bigtreetech/BIGTREETECH-S42B-V1.0/(threads)

Thread 1 (2020-01-07):

Manual file

schpuntik, 2020-01-07:
Manual file is brocken. Please  upload again

yangwenxiong, 2020-01-08:
> Manual file is brocken. Please upload again

Have been updated

yangwenxiong, 2020-01-08:
[https://github.com/bigtreetech/BIGTREETECH-S42B-V1.0/issues/1#issue-546557873](url)

yangwenxiong, 2020-01-08:
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

yangwenxiong, 2020-01-08:
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

yangwenxiong, 2020-01-08:
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

yangwenxiong, 2020-01-08:
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

Closed 2020-03-23.

Thread 3 (2020-03-15):

Motor Spin after M17 command

ehtnevets, 2020-03-15:
After auto-disable timeout, sending M17 (enable) will cause motor to jump to almost the end of travel of an axis. Is there work around?

Thanks

sae74, 2020-04-30:
I have exactly the same problem in rotation after shutdown

ehtnevets, 2020-05-01:
I'm ordering the MKS closed loop board. I'll let you know if MKS brand exhibits the same problem, in 2-3 weeks. Shipment has been really slow from China to U.S.

sae74, 2020-05-01:
I will wait for feedback from you.
Thank!

ehtnevets, 2020-05-21:
I ordered MKS from AliExpress. It hasn't arrived after more 2 months. I disputed this with AE but seller (MKS) keeps extending protection program. AE only allows dispute if the protection program is expiring in a day. The computer generated response from AE keeps saying my dispute is invalid. So, I call my bank to charge back.  I gave up MKS.

Anyway, I gave up with this closed loop stuff as it doesn't have the advanced smoothing feature like Trinamic drivers. It's loud and vibrates my print bed. Lowering the current seems to help but sacrifices max speed. Even after I found all the disable motor-off feature in Marlin and Klipper firmwares to avoid the jump from re-enabling, I think this closed loop solution gives worse bottom line result.

To top it off, the magnet always gets loose. I used all different type of glues, cement, superglue, epoxy, etc. They don't help. Especially, the ones I used in the extruders with linear/pressure advance feature (linear advance causes the motor to spin back and forth very fast and for short distances, aka violent jerking).

So, in the end I realized that closed loop motor this cheap ain't cut it. If you want to go closed loop, get one with $100s/axis. Plus, if your non-closed loop stepper is skipping steps, there is other fundamental issue that needs to be addressed. But for sure not going with closed loop.

Back to Trinamic.

sae74, 2020-05-21:
Thank. But I need a device not for a 3D printer.
It’s very important for me to keep track of the number of steps.

ehtnevets, 2020-05-21:
Perhaps, you should use the more expensive version (about 3x more). They use more expensive components even down to the passive ones like bigger capacitor, tighter tolerance.

When it comes to closed loop control, I re-learned (I started a company that designed and manufactured robots for semiconductor industry) that you get what you pay for.

You can always keep track your steps with the software. The software is the one doing the stepping anyway.

ehtnevets, 2020-05-21:
And if your usage include moving the motor with a lot of high accel and decel, the magnet could be another problem.

sae74, 2020-05-22:
I need to control the steps for a water pump system. Need high accuracy +/- 0.005 ml liquid

ehtnevets, 2020-06-15:
I finally got my MKS boards but decided that the motion smoothness is more important when it comes 3D printing and decided not to bother with it.

I have 1 board set with OLED and 4 just board set that I want to sell. If you are in US, I can sell them to you at cost + shipping. Cheaper than you find on eBay.

sae74, 2020-06-16:
Thank.
But I am in a different country.
If you know what Chernobyl is, or you watched the Chernobyl series, then this is about my country, Ukraine.

ehtnevets, 2020-06-16:
Ukraine. Remind me of my a friend who told a story about Chernobyl cleanup when he was in the Army there.

Quas7, 2020-09-10:
I experience the same issue for my FDM extruder after powerdown and enabling again. It always stripped my filament as it retracted with max speed x100m of filament. ;)

Simple solution was to disconnect the enable-pin from the cable-connector and bridge the enable signal on the stepper PCB to GND (active low) with a dupont wire.
This way, the stepper driver stays of course always active but there is also no "reset to 0" at the start of the print.

Quas7, 2020-09-10:
I flashed today the latest firmware out of this repo to adjust the PID values a bit and now the enabling/disabling of the stepper driver does not result in any erratic spinning anymore.

I guess, the issue got solved by the devs before uploading the code here.

sae74, 2020-09-11:
How did you upload the firmware?
Where did you connect the programmer?

Quas7, 2020-09-11:
Took the pinout from here: https://github.com/bigtreetech/BIGTREETECH-S42B-V1.0/blob/master/Item-Pinmap.PDF
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
Read carefully the pins as there are two rows of pins (OLED and aux. connector) and one column of pin descriptions depicted

SWCK, SDO, GND are required - you can also disconnect the board from the supply and plug in the 3v3 from the programmer.
Make sure, the board is not "enabled" for flashing as this seems to result in issues (seems to be EMI as my OLED also shows artefacts from time to time).
I used a st-link v2 clone but any STM32 programmer will do, I think.

Quas7, 2020-09-22:
https://github.com/bigtreetech/BIGTREETECH-S42B-V1.0/issues/16
I will continue to post results for optimizing the communication frequency.

AbeFM, 2020-09-30:
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

I hooked up those 3, plus 3.3V, pin for pin over to my generic STLink2 dongle. The dongle mounts in Windows, but beyond that, I can't get anything to talk. Should it show up as a com port? Do I need a driver for the motor controller board (S42B) itself?

Do you upload firmware with the SerialPort Assistant, Arduino, VS, or what?

I have a feeling I have a bad board, but trying to see if I can get it talking. It holds position, calibrates, works with the screen - but won't register steps from printer. I even recompiled to get the longer pulse widths, still a no go.

Thanks - sorry for the off topic post - perhaps having the process more explicitly laid out will help others in the future.

Quas7, 2020-09-30:
depending on the dongle you have, it should show up as a generic USB device "STM32 STlink" or as a "ST-Link Debug" (STLink v3) with an additional COM-port.
If you have a Baite dongle it shows up as a com port via "STM32 STLink".

Do not connect the 3V3 parallel to powering the board itself. There can only be one supply voltage and you could damage either supply (most likely the dongle, if it is a cheap clone).

For coding, I work with platform.io in as a plugin from the market inside visual studio code (https://code.visualstudio.com/).
See here for installation: https://platformio.org/install/ide?install=vscode

You can upload the binary via visual studio itself if you configured your dongle correctly in the platformio.ini via upload_protocol.
Youtube explains it in more detail here for instance: https://www.youtube.com/watch?v=dany7ae_0ks&ab_channel=MakeUseOf

good luck.

AbeFM, 2020-09-30:
Thanks for the detailed response!

1) I have the printer shut off, and the 3.3 line from the programmer
(programmer powered from usb) powering everything. Is this ok?

2) I've had the OLED screen plugged in - is that an issue?  I put the board
in Open Loop mode (sw3 OFF) during this.

3) In Device Manager, under "Universal Serial Bus devices" I have "STM32
STLink", but I have no entries under "Ports" as I would expect with a
serial adapter plugged in. Do you feel that is because I don't have a
driver for the S42B on the computer, or because I may not have fully
installed the STLink?

Watching videos and getting PlatformIO installed.

                  Thanks!
                          -Abe.
Sent from my "smart"phone, please excuse brevity and Swype-oes

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

AbeFM, 2020-09-30:
Ah, ok. So I didn't have 5V run to the driver's socket, so the little adapter board wasn't sending said +5v to the S42B. I checked that I could talk to another SM32 board (one of those Arduino Nano looking deals). Your pinout was helpful.

Now with that jumpered, I was able to flash your firmware onto it. Everything works including printer commanded moves. I just need to remove the jumper and Say It With Solder and I may actually be able to print stuff again. Thanks for all the help!!!!

Does that have the bug fixed with the jumping when "enabled" is un-asserted?

AbeFM, 2020-10-02:
Still sufferings inconsistent connections. Sometimes it doesn't work without being plugged into printer, sometimes it doesn't work IF it's plugged into the printer, I'm getting a replacement programmer but I suspect it's the board. Aside from that, I need to change my PID values, and had some questions for @Quas7 :

> Make sure, the board is not "enabled" during flashing as this seems to result in issues (seems to be EMI as my OLED also shows artefacts from time to time).

Can you explain what you mean here - you mean the enable pin from the printer being asserted? So the bad state is dependant on the firmware settings? I've had the board unplugged from the motor and oled when programming.

I don't think I have the same issue as you, mine gets the first line (initializing oled) then resetting, so it's just flashing that message at ~2 Hz.

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

Have you used this for any movement axis? I was getting run away oscillations on my CR-10 and wondering what good starting numbers might be.

> Warning! contains reset-to-zero-bug after re-enabling the driver: [s42b_org_as_delivered.zip]

Can you explain what that error is so I can verify it's removed from my firmware?

Quas7, 2020-10-02:
@AbeFM
I had also many connection problems in the beginning but quickly noticed, that this happens, if the board was powering the motor (driving the PWM stage).
Disconnecting the motor did not help in my trials likely as the PWM chip will still try with maximum motor voltage to get current pushed into a non existing motor. These voltage peaks seem to still interfere with the programming communication.
Just to be clear, I would not go that far to say that this is a design flaw of the PCB as on such a small board this might be really hard to prevent. BTW, the PWM frequency seems to be 187kHz according to Jans calculations.

You can set the "enabled active high or low" via the menu to switch the driver stage off during programming.

My PID settings are only for my extruders and naturally they feature a quite heavy dampening that prevent oszillations.
If you want to do a heuristic calibration, I would recommend the Ziegler-Nichols methode for PID systems as a starting point (https://en.wikipedia.org/wiki/Ziegler%E2%80%93Nichols_method).
You will need to generate a stable oszillation with a high P and I=D=0 and then measure the oszillation frequeny with a smarthone app like "vibration analysis" (android).
The rest is then following the recipe on wikipedia and I would start with the derived values for "classic PID".

AbeFM, 2020-10-05:
Ah, thanks again for a good answer. I'm unfortunately reasonably versed in PIDs, but have never had a case I COULD just tune like that. I guess the problem is you're reading the pulley, not the stage, probably making things worse. Anyway, I'll try it when I managed to get it flashed - even if I didn't need to I've always wanted to use the phone accelerometer for something useful.

Ah, ok, thanks for the answer: Making sure it's not enabled. Which pretty much means "does motor freewheel", if it's holding it, you'll know.

It would be awesome if (along the lines of "it's not a design issue) they let you flip a DIP switch to get into reliable programming mode. :-)

swanepoeljan, 2020-10-07:
> It would be awesome if (along the lines of "it's not a design issue) they let you flip a DIP switch to get into reliable programming mode. :-)

If they just broke-out the BOOT0 pin of the MCU to the DIP switch (or some extra jumper) we could have used the internal system bootloader to easily flash new firmware with only a normal USB to Serial bridge...

Thread 4 (2020-04-25):

Configuration for 0.9 degree step angle steppers

WayeeCool, 2020-04-25:
I have steppers with a 0.9 degree step angle instead of the 1.8 degree step angle the S42B seems configured for.  On the MisfitTech Nanosteppers, that these are based on, support for 0.9 degree steppers was added a long time ago and I am wondering if the manual for the S42B just leaves out how to configure for 0.9 degree steppers.

Andrei43D, 2020-07-25:
I have 0.9 steppers too. Interested, if its possible to use this board with existing TMC2209 drivers and 0.9 steppers. BigTreeTech, I'm up for testing, of you are interested. This could become a really useful addition to almost any printer, if the board could work with different motors and different drivers (like 2209 or 2226)
Keep up your great work!)

setar, 2020-11-07:
very easy fix
https://github.com/setar/BIGTREETECH-S42B-V1.0/commit/cead5cab6ba368c2d2e6fd1c4872c61c3020dbd4

caesar1111, 2020-11-12:
@setar : which 0.9 degree stepper you are running for your for? And can you still confirm they run without flaws?

setar, 2020-11-12:
it work for me now http://roboforum.ru/forum107/topic18565.html

Thread 6 (2020-06-16):

[FR] TMC stepper driver

Protean-Man, 2020-06-16:
What you have done is impressive with the integrated closed loop circut - but the A4950 is older and antiquated. What about the TMC4671 - ? Or other even two options with the TMC5160 & TMC2209?

frank-pian, 2020-06-29:
These closed-loop drives are based on 'Nano Zero Stepper'.
This code does not use the TMC chip.

dzid26, 2020-07-02:
> What you have done is impressive with the integrated closed loop circut - but the A4950 is older and antiquated. What about the TMC4671 - ? Or other even two options with the TMC5160 & TMC2209?

This would be close loop control on chip instead of software.

They actually sell (expensive) close loop steppers. https://www.trinamic.com/products/pandrive-smart-motors/#c2483

garkin, 2020-07-28:
This whole assembly is less than $20 atm. What makes A4950 antiquated in this price range?
What exactly your change adds to the plate? How much does it costs?
What ammount of work required to update firmware?
[Mouser shows $30 per item](https://ru.mouser.com/Search/Refine?Keyword=TMC4671)
[TMC4671-LA datasheet](https://ru.mouser.com/datasheet/2/256/TMC4671-LA_datasheet_Rev2.00-1880648.pdf)

Protean-Man, 2020-07-28:
In the usage of stepper drivers the A4950 compared to others, it is older and antiquated. This closed loop system is great and yes it is at a great price range for what you get.

My question still stands given that they could make create this for $20, why wouldn't they want to sell a version with more advanced drivers?
The closed loop systems from TMC are very expensive - I'd bet Bigtreetech could do it for much cheaper and get similar quality.

fake-name, 2020-08-05:
The TMC4671  is completely irrelevant here, because the servo controller is implemented in the STM32 MCU. Sure, you could replace the entire circuit with another, but at that point, it's just a different product.

> In the usage of stepper drivers the A4950 compared to others, it is older and antiquated.

The A4950 is not a stepper driver, and it is not antiquated. It's a perfectly servicable modern single-chip current limited H-Bridge IC.

If you think the TMC4671 is a replacement or upgrade for the A4950 (and the way it's being used), you have no idea what you're talking about.

The entire point of doing the servo loop in a inexpensive MCU with a simple H-Bridge output stage is that it's inexpensive, and you can compensate for any hardware nonlinearities with clever software. The TMC4671  is the opposite of that.

dash3811, 2020-11-18:
If you want to use upgraded drivers for closed loop then you should just buy a SKR 1.4 or 1.4 Turbo and instead of connecting the wire to the adapter driver just connect it to the spot in front of the drivers labeled x-cls, y-cls, etc. That's the purpose of those pins.

Thread 7 (2020-07-27):

OLED Screen doesn't stay on

CircuitSetup, 2020-07-27:
Is there a reason the OLED screen would flicker and turn off completely when the stepper motor is enabled? The screen never seems to stay on. It does stay on when the motor is not enabled, but not always.

cofhal, 2020-07-31:
I have the same problem.

CircuitSetup, 2020-08-04:
@bigtreetech - any ideas on this?

charchess, 2020-08-13:
Same here.
to be more specific, I got 4 motors and so far :
* the X one is working fine
* the Y one is dancing (when a command is issued he is going back and forth around the target position I guess, not related to that ticket, just for information)
* the Z1 and Z2 are just not responding and display is shuting down after a couple of seconds or sometimes flickering before shuting down

I tried to invert X and Z1 motor and Z1 motor still doesn't repond properly and still have that shutdown issue.

when moving a bit the oled screen, I got the impression there is some bad contact somewhere, will investigate further in the next days and see if I can find anything.

For those having the same problem (screen shuting down), can you control it (just some display problem) or is the motor not obeying the commands ?

CircuitSetup, 2020-08-13:
@charchess make sure the current and steps are set correctly, and after doing so, run the calibration.

When my screen goes out the motor still responds without issue. If I want to change something I have to do it before the motor is activated though. I swapped with a similar screen, and another driver and it didn't make a difference.

kookaburra88, 2020-08-14:
Same issue on my side with 2 motors + 2 OLED screens

kamilj, 2020-09-01:
More and more often I think about creating a database for Chinese products that are just a scam. Products of such poor quality are practically absent in Europe or the USA. I have the same problem in 3 drivers.

charchess, 2020-09-02:
@CircuitSetup my issue on the motor was ..I did misread the documentation ...
https://github.com/bigtreetech/BIGTREETECH-S42B-V1.0/blob/master/42%20Stepper%20Motor%20Closed%20Loop%20Driver%20Control%20Board%20Manual.pdf page 20 explain how to setup pulse signals ... and it solved the issue of my motors moving wrongly

I can't confirm if it solve the OLED shutdown issue ... as I short circuited the heater/thermistor ...and now am waiting for a new motherboard from biqu...

@kamilj the idea might be nice, but I really don't feel like biqu/btt should be in such a database
* there product are overall good and working as expected for a cheap price
* biqu is on an improvement with customer path (it is known their product are released as working but there will be newer upgraded version months after, so bugs are expected)
* they could do some more thorough job of debugging to only release final product but that would increase the price and the time to release (if that's what you're looking for, I think you might prefer some huge company that release product after years of developpment and not "on bleeding edge" ones)
* they are even providing some documentation (on which they might want to improve a bit, the english level got me at a loss some times )

and to end that, stating that "chinese products" need such a database, I disagree, you'd need a worldwide database as lot of scam are not from china. Referencing all, including real scam (like out of nowhere power generating system ie) would be a real huge amount of work.

Have a nice day

kamilj, 2020-09-02:
I think about Chinese products because the law does not protect the consumer in this particular case.

narosenberg, 2020-09-12:
Same problem here.  Most times the screen goes black as soon as I press the menu button, sometimes the characters are reversed left-right.  I have two of them (new) they both exhibit the same problem and are unusable.  I've contacted the vendor (BIQU) but based on others' messages, I'm not too hopeful.

Quas7, 2020-09-12:
does the issue also occure, if you disconnect the motor (power off before unplugging the motor)?
I suspect that some motors draw to much current and the resulting interference kills the OLED communication.

narosenberg, 2020-09-12:
The motor used is the one you provided as part of the kit.

I have just tried what you suggest – power off, disconnect the motor, power on.  Same result.

Neil

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

Quas7, 2020-09-12:
I have the same issue but much less severe than you guys. My extruder has this closed loop setup and after some printing the display gets corrupted or frozen.

ok, next try... try to disable "closed loop control" by switching dip switch 3 to off.
Dip 4 has to be on to run calibration.
there must be some source of interference.

What supply voltage do you feed to the boards? 12V or 24V?

fjrpilot05, 2020-09-13:
Similar issues as described here. (flakey OLED screen).  But not enough to prevent setup.  I am experiencing 2 deal breakers though.
1) random layer shifts
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

2) On my machine (Monoprice Maker Select Plus, w/SKR1.4 Turbo and S42B on x-axis only) when I do the math I should be at 160 steps/mm with 32 microsteps.  In order to get the x-axis dialed in I need it to be set for between 205 - 206 steps/mm
This is very odd to me.  The mechanics on the Monoprice dictate that it should be 160 as it is on the y-axis without the closed loop.

Has anyone else who is using these experienced layer shift on long running jobs?  How about weird step count settings?

The layer shift problem is a deal breaker for me.  I thought this was impossible with closed loop during a normal print job (no interference, no hung up filament, no hitting the printer with a mallet.... :) )  But it appears that there is something flakey going on.

Regards

fjrpilot05, 2020-09-13:
@charchess
With regard to the y-axis dancing around, Have you tried connecting up through the serial interface and play with the PID values?
This implementation of closed loop doesn't have any sort autotune. (The calibration is not for tuning PID values) so in order to get these tuned in for your implementation these values should be adjusted for each individual axis you use them on.
Regards,
fjrpilot05

Quas7, 2020-09-13:
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

did you reduce the communication speed and increased pulse lenghts to the S42B?
in Marlin you can select the TB6600 external steppers to match the slower timing required by the S42B. It will show this behavior, if set to 4988 or TMC drivers. DRV8825 settings might work somehow.

Quas7, 2020-09-13:
I just noticed, that after flashing the compiled version of the firmware provided in this repository all the display issues vanished together with the bug "spin to zero position on re-enable".

Maybe you test and flash the boards with the latest version?
A few details how to do it can be found here: https://github.com/bigtreetech/BIGTREETECH-S42B-V1.0/issues/3

If the issue persists for someone, there might be a hack by changing the GPIO speeds for the display communication.

oled IO in main.c (line 1215 onwards):
GPIO_InitStruct.Speed = LL_GPIO_SPEED_FREQ_HIGH; // switch to LL_GPIO_SPEED_FREQ_MEDIUM

It looks like the angular sensor (TLE5012B) is not interfaced via the same SPI bus but some other interface.
https://www.infineon.com/dgdl/Infineon-TLE5012B_Exxxx-DS-v02_01-EN.pdf?fileId=db3a304334fac4c601350f31c43c433f

Quas7, 2020-09-13:
For the shifted layers and hte change of communicaton parameters see also here: https://github.com/bigtreetech/BIGTREETECH-S42B-V1.0/issues/14

You can test also with open-loop mode by switching pin 3 "off". If the layers still shift, it is not the PID.
For a wrongly calibrated PID I would normally expect ringing or undershoot but not a constant layer shift. That is why I think the S42B is thinking it is correct as it just did not catch all steps send by the mainboard.

Quas7, 2020-09-16:
after a few days of printin now, the display showed some erronous characters but it is still better than before the firmware update.

Quas7, 2020-09-22:
regarding the OLED there is a new finding for the initialization of the OLED here https://github.com/bigtreetech/BIGTREETECH-S42B-V1.0/issues/16

Quas7, 2020-10-05:
PR is opened as a possible fix for the OLED issue. Testers welcome to approve.

Thread 8 (2020-07-28):

Sensorless Homing

garkin, 2020-07-28:
It should be not hard to implement using encoder.

Question is how you should signal about it to the Marlin without patches. Current Marlin implementation looks heavy TMC based.
Does current pololu adapter have enough pins?

[marlin docs](https://marlinfw.org/meta/search/?q=SENSORLESS_HOMING)
[marlin repo](https://github.com/MarlinFirmware/Marlin/search?q=Sensorless+Homing)
[duet wiki](https://duet3d.dozuki.com/Wiki/Stall_detection_and_sensorless_homing)

Also opens up [Sensorless Probing](https://www.youtube.com/watch?v=xb8dM9duGOs).

garkin, 2020-07-28:
Bad news, looks like replicating TMC UART interface is not a viable solution. Changes to the Marlin will be needed.
Worst news, mainboard interface has no UART pin at all.
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

garkin, 2020-07-28:
May be possible to drop EN pin in favor of UART. Still hardware revision for pololu adapter will be needed.
And they already added this pinout as SKR 1.4
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

Looks staled until next hardware revision.

Closed 2020-07-28.

Thread 9 (2020-08-06):

Stepper drive in closed loop misbehaves...

Baltojikale, 2020-08-06:
Bought diy kits and installed on Geeetech a10 (printer similar to ender3 ). Calibrated and installed according TEaching tech video. Drivers in closed loop mode misbehave.. they count steps as red led lights up ( shows error) but driver doesnt move motors or moves periodically then once again dont move.... also tried changing stepping pulse width, and reflashed most current firmware from this repository. Uppon further inspection drivers works well in open loop but doesnt performs movement correctly in closed loop.
What could be the problem??

mickeymicks, 2020-08-15:
I'm also seeing the same problem on a modified Duplicator 6 with MKS SGEN L board.
Interestingly, this only happens to my Y motor. The one that I installed on my X motor works fine in both open and closed loop.
I tried swapping the motors, connectors, etc and it's only happening on that one board.
For my case, the motor won't move at all and would just make some whiny noises.

Baltojikale, 2020-08-17:
at first was same only one axis misbehaved upon further experimentation both started to misbehave.

raimis170, 2020-08-24:
my does not work when i enable number 3 switch

Marcusbjol, 2020-09-04:
To get them to work, implement teaching techs corexy fix. Prepare to recalibrate the steps per mm tho.

Baltojikale, 2020-09-04:
Yes. i have implemented those fixes. but  it seems thats not the case.. few more test are left to perform but at 32 micro stepping setting for s42b i have topped out atmega2560 chip computational capabilities and thus layer shifting and closed loop misbehavior was due to slow motherboard . Just yesterday instaled SKR1.4 turbo (8times faster that gt2560 board). so today will be testing if problem still ramains.

So my suggestion to fix this issue with atmega2560 based boards is to reduce micros tepping to 16 or even 8 micro stepps per x and y axis.

Will update if problem remains with skr 1.4 turbo

Quas7, 2020-09-14:
could also be partly related to a too fast or boarderline communication timing. Would also explain the axis dependence @mickeymicks as the PCB routing differs for the steps signal.
See https://github.com/bigtreetech/BIGTREETECH-S42B-V1.0/issues/14

Baltojikale, 2020-09-14:
So all tests passed and been printing non stop for a week with skr 1.4 Turbo with no layer shifts. Thought with linear advance feature enabled printing speeds kinda limited... And as i predicted 8 bit boards cant handle 32 microsteping on x /y  and spi on z/e0.  So in case of s42b misbehaving with 8 bit board first thing is to reduce microstepping.

mickeymicks, 2020-09-23:
> could also be partly related to a too fast or boarderline communication timing. Would also explain the axis dependence @mickeymicks as the PCB routing differs for the steps signal.
> See #14

I'll go try out the marlin settings in your link later.
Will test it on a spare SKR 1.4 board I have, as for now, i've decided not to install s42b on my printer.
Just too much hassle and I feel it won't bring that much benefit in real world prints for my case at least.
Maybe some day, I will attempt to install it again.

Thanks!

Closed 2020-09-14.

Thread 10 (2020-08-11):

[Feature Request] Sensorless homing support

MiggyMan, 2020-08-11:
Given that this unit is able to detect missed steps could this functionality be adapted to allow for sensorless homing ?

AbeFM, 2020-10-02:
There's no absolute reference (i.e. the belt could slip a tooth, and it only knows where it is within a given rotation) - you might be able to run it back till it stops moving, then use either absolute rotational position (probably what I'd use)...

I guess the later versions of the board have CAN ports - which yeah, I suppose you would be able to directly command - AND I feel you could drop this lame idea of sending steps.

Quas7, 2020-10-03:
this is not really "sensorless" as we have a magnetic sensor system here. ;)
But, we would need to wire a pin of s42b back to the endstop pins of the controller. I think, it is doable but does not really reduce the wiring as "sensorless" does.

For 3d printers the sensorless homing is normally bound to stallguard (or back-EMF measurement) via TMC drivers.

https://www.trinamic.com/technology/motor-control-technology/stallguard-and-coolstep/

Quas7, 2020-10-03:
@AbeFM
the S42B keeps track of its absoulte position as it is counting rollovers as far as I know.

swanepoeljan, 2020-10-04:
We also have it on the S42B, the red LED that flashes before and after calibration lights up when the error between the desired and actual angle reaches more than about 36°.

Quas7, 2020-10-04:
@swanepoeljan
yes, you are right - forgot about that.
It should not be too difficult to copy that function and generate a trigger on ~2° and pull one of the extension pins high/low to mimic an endstop for the motion contoller board.

AbeFM, 2020-10-05:
Yeah - with the boards that have CANbus, you could run them like trinamic drivers. I know they talk serial, but I don't know if they entirely commanded that way (without step/direction pulses...) - my point was you could implement that set up if you can talk back.  You'd save DIR, ENABLE, and STEP and replace with CANH and CANL, plus power/ground, sounds like a 4-wire solution.

I think one thing you could look for, while homing, is a wind up of the I variable - if you get even 1 degree out, wait a short time, if it's winding up I and P is constant, then you know you're hitting a hard stop.

swanepoeljan, 2020-10-06:
@AbeFM Are you referring to S42B boards?

> I guess the later versions of the board have CAN ports

Haven't seen any of them but would be really interesting! Would also mean an upgrade of the MCU since the STM32F030C8T6 does not have a CAN controller onboard. I like the idea of using CAN! Do you know if it's supported in Marlin or any other firmware?

Good idea for also checking I-term windup to detect a hard stop! This could help to distinguish between bumping (or sudden acceleration) of the control surface or hitting a hard stop...

Quas7, 2020-10-06:
@swanepoeljan
You can DIY it in but not on S42B.
I saw a "wiring example" for the STM32F030C8T6 here: https://github.com/makerbase-mks/MKS-SERVO42B/issues/11 ;)
So far, for 3D printing I did not see any CAN-capable yet (Feature request still open here: https://github.com/MarlinFirmware/Marlin/issues/7735).
For CNC the regular highend does use some real time ethernet, I think.
Given the non-linear behavior of the extrusion, I am also not sure, if there is a big benefit of letting the controler know the actual movment. I mean, the extruder will always blob a bit and ruin an "error free" print, if something is going wrong with steps and has to be corrected (slowed down).
But maybe I miss real benefit here in terms of print reliability?

swanepoeljan, 2020-10-06:
Thanks, looks interesting!

When I think of CAN, I think of a more distributed system. So drivers don't have to be in a box with fans trying to keep them cool but could be mounted on the steppers, like with these close loop solutions. The wiring could be reduced overall and also the noise generated (and picked up) by pulsing steps at a rapid rate (and high currents) through the fairly long motor wires could be reduced. Losses and inductance in the motor wires could also be reduced... Things like the screen and controls are then just nodes and can be mounted anywhere on the bus.
Like you said, for extrusion maybe providing feedback on missing steps would not bring much but maybe there is some other telemetry that it can give back to improve it's operation.

Looks like RepRap [firmware](https://reprap.org/wiki/RepRap_Firmware) has some support for CAN

Quas7, 2020-10-06:
maybe we just wait for this campaign to rum: https://www.ogadget.com/x/ananasstepper3

AbeFM, 2020-10-06:
Agreed - and for extrusion, I don't see much value in closed loop. Maybe I'm missing something. If the set up is even close to right, it'll just shred the filament if you force it, perhaps there'd be some small jams you could fix... But at that point I'd want to have full motion feedback so I could run the extruder both directions and even so I think it'd be a few percent chance of fixing it. I doubt you can do a lot worthwhile without the printer being smart enough to wait for you to fix the error - then you're back on bidirectional communications.

I don't know how the Trinamic drivers do it, but they DO talk back, my Prusa's quite happy to rehome as much as it needed. I'd assumed it was i2c or can which is why I was hoping it would be reasonable to do here. Worst case you could build a box to translate it, but my hope was to lower the load on the CPU by sending target position/speed commands. Certainly I won't be rewriting Marlin from scratch. :-)

Quas7, 2020-10-06:
Oh, you should really test what you can do with a geared extruder setup like BMG (my favorite) or a Titan with closed loop.
For my direct drives I run these little tiny and light 0.7A pancake NEMAs with 1.0A limit and I can retract and print as fast as with a double size stepper (given that the, PID will catch some of the high Jerk in this case).
Of course, if I overdo it I strip the filament but normally the pancakes click before that happens in open-loop.
And this setup stays cool to the touch compared to a closed loop with 1A over-current where you risk burning your fingeres (or melt something else close by). Of course, I have to trust the angle-deviation shutdown of the S42B if I get a jam - otherwise, the motor will reach the same critical temperatures as well.

The Trinamics just measure Back-EMF and they use it for their "Stallguard" feature for remote load sensing. Works really nice also for me for precise homing but it only indicates the load not the position.

But honestly, with a cheap SKR1.4 turbo there is not much need to offload anything anymore to save on CPU cycles.
You do not need a Duet anymore to reach 500mm/s on deltas or something like this. ;)

Regarding the ODrive, I do not even have servos yet on my CNC where this would really make more sense!
But thanks for the hint, maybe I still need something for Christmas for myself.

AbeFM, 2020-10-07:
You're saying the advantage to closed loop is being able to run lower drive current?

Huh. Well, I was all prepared to call you crazy, and I don't think it's the "right" way to do it, but it does sound like it'd let you run a lot less current. And yeah, if you're on the hairy edge - stallgaurd can be iffy. And if you're not, then you're dumping a lot of heat. Printing in summer on a Prusa is not what printing in winter is on one of those.

Quas7, 2020-10-07:
Maybe you think of it the other way around.
I use a much higher current limit with closed-loop than the rated RMS current of the motors.

In open-loop the drivers always push a higher current into the motor.
The closed-loop does only apply higher currents, if there is a sufficient deviation from the setpoint (small deviations = small currents).

Therefore, I use 50% overcurrent (0.7A rated but I use ~1A RMS current limit) as the higher current is only needed for short time periods and is not overheating the motor.

Quas7, 2020-10-25:
Regarding the FR for sensorless homing one possible way to implement it:
1. Copy the red-LED function with a lower threshold of ~0.4deg (quater full step sounds ok?)
2. use either SWCK or SWDO pin on the extension header as "active low" to trigger an endstop on the mainboard
3. In order to keep SWD programming possible, the used pin should only be an active output, if used by the function and stay an input otherwise.

Quas7, 2020-10-25:
I implemented the functionality in this PR: https://github.com/bigtreetech/BIGTREETECH-S42B-V1.0/pull/27

swanepoeljan, 2020-10-28:
If we felt really confident we could also write a UART bootloader which is flashed through SWD. Then after that we could use the SWD pins for these kind of features and just flash our firmware updates using the bootloader (and USB to Serial bridge).

Quas7, 2020-10-28:
That would be one nice solution. But I did not yet try this with a full mechanical setup but only with a small lever.
But without Boot0 accessable we would require a time window approach, right?

We could also maybe free the RX/TX and switch them over to the SWD pins but a software UART is maybe eating up too many cycles given the small STM32 here.

swanepoeljan, 2020-10-29:
> But without Boot0 accessable we would require a time window approach, right?

Also think so, or maybe the bootloader can check one of the buttons. So when you power up or reset while holding a button down the bootloader detects it and waits for new program upload, else continue with normal program execution.

To fast track things we could maybe even look at something that's already available. Quickly Googling I found [OpenBLT](https://www.feaser.com/openblt/doku.php) which looks promising.

One challenge might be to fit everything on the 64kB of flash memory we have on the STM32F030C8. The calibration table takes the last 32kB, just before that sits the parameters which blocks another 1kB and it seems OpenBLT would take the first 5kB. So we are left with 26kB for the actual code.

Can't remember what size the original firmware was but my fork sits at 28kB so would need to do some serious optimization to fit it all in.

Another option we could try is to jump from user code to the existing UART bootloader in ROM. Would then be almost the same as having BOOT0 available. Have never tried it but seems to be [possible](https://community.st.com/s/question/0D50X00009Xkg9mSAB/jump-to-bootloader-area-from-user-application-on-stm32f0) and also mentioned in AN2606. The big advantage here would be that we don't have to give up precious flash memory for another bootloader.

Another nice thing about this last option would be that we can invoke the bootloader whenever we want, like from the OLED menu or even a serial command...

swanepoeljan, 2020-10-29:
It works! The last option, its possible to jump to the system bootloader and then upload through UART1!

I created an InvokeBootloader() function which performs the jump and made it accessible through a serial command. So then in the Terminal program I used this command to call the jump function. Then I disconnected the Terminal and used the Flash Loader Demonstrator to upload the .bin file and it worked!

Here is the code:

```
void InvokeBootloader()
{
  // Function pointer to bootloader in system memory
  // Referenced from AN2606 Rev.44 Table 141.
  // The first word is the stack pointer and therefore the 4 byte offset.
  void (*BootMemJump)(void) = (*((uint32_t*) 0x1FFFEC04));

  // De-initialize UART1 as it will be used by the bootloader
  LL_USART_DeInit(USART1);

  // De-initialize RCC
  LL_RCC_DeInit();

  // Stop SysTick timer
  SysTick->CTRL = 0;
  SysTick->LOAD = 0;
  SysTick->VAL = 0;

  // Disable interrupts
  __disable_irq();

  __DSB();
  __ISB();

  // Set Main Stack Pointer
  __set_MSP(0x20001000);

  // Jump to bootloader
  BootMemJump();
}
```

and here the confirmation from Flash Loader Demonstrator:
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

So over the weekend I will try to add the upload functionality to the Terminal program so that it can be done without the Flash loader. Something like this:
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

Quas7, 2020-10-29:
@swanepoeljan are you kidding me!? This idea was not older than 24h and there was no weekend in between!
I was not even able to comment fast enough that we might need every 'bit' of the flash later . ;)

swanepoeljan, 2020-10-29:
haha... I must admit the idea of jumping to the system bootloader was really fascinating, even left work early to come and try it out! Sounds like you are working on something interesting there... ;)

Quas7, 2020-10-29:
hrhr, that is the right attitude!
I am really not a programming guy but this PID autotuning is something for the Christmas time to get a bit more skilled, I think. One needs challenges to grow, you know. ;)

alexxy, 2021-01-10:
> Yeah - with the boards that have CANbus, you could run them like trinamic drivers. I know they talk serial, but I don't know if they entirely commanded that way (without step/direction pulses...) - my point was you could implement that set up if you can talk back. You'd save DIR, ENABLE, and STEP and replace with CANH and CANL, plus power/ground, sounds like a 4-wire solution.
>
> I think one thing you could look for, while homing, is a wind up of the I variable - if you get even 1 degree out, wait a short time, if it's winding up I and P is constant, then you know you're hitting a hard stop.

I'm working on prototype of such board =)
So it has stm32g4 cpu, tmc51xx stepper driver and 15bit encoder,
can be powered with usb-c with pd, has CAN-FD (up to 8 mbit) and s,d,e, error pins to interface with legacy hw.

Board can be powered from 4.5 to 34 V

Thread 11 (2020-08-14):

PID adjustment via LCD

kookaburra88, 2020-08-14:
Please provide firmware, which allows PID parameter modification via LCD screen.

Furthermore, please implement PID parameter identification. I'm thinking of issuing a chirp signal (sine wave with increasing frequency) trajectory to identify the motion system. Then optimize PID setting e.g. via Q-parametrization (https://www.google.com/url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). If you need help implementing automatic PID tuning, please let me know.

Hanif89, 2020-08-18:
After finding out about this issue, I tested probably over a 100 combinations of PID. I could not get rid of the overshoot without affecting the accuracy. This was with 32 microsteps. The problem becomes visible in printing small circles when trying to damp the overshoot. Setting I to zero causes undershoot. Setting too high of P and/or D results in a lot of noise and vibration probably because the driver is A4950.

I think the closed loop operation shouldn't be based on PID or at the very least the smallest stepper increment should be synchronized with the encoder position measurement. That is the smallest error from the encoder should limited to minimum the smallest stepper increment. Maybe line 89 of stm32f0xx_it.c should be rounded based on the stepangle setting. Also, the minimum input to the stepper should be the same as that used in the open loop mode based on what I'm seeing in that section of code. Otherwise, you get a non-zero input to the stepper between steps which may be causing a lot of unnecessary noise.

Not sure if there's a guide to flash the stepper board. I didn't see any. If there's an easy way to flash it I can probably try changing the code myself.

kookaburra88, 2020-08-30:
You will find the flashing instruction here:

https://github.com/bigtreetech/BIGTREETECH-S42B-V1.0/blob/master/3d%20printer%20-ender3%20closed%20loop%20driver%20module%20installation%20instructions.pdf

Please let us know, whether your controller design was an improvement.

fjrpilot05, 2020-09-13:
@Hanif89
I'm very interested if you tried your modification to the firmware's source.  I'm struggling to try and make these closed loops work for me but the overshooting is unacceptable.  I will second your request to be able to modify the PID values through the LCD.  I don't want to give up on these just yet.
Regards.

nhabes79, 2020-10-02:
I haven't tried to set I at 0 yet. Didn't know I could do that. I've been playing with the PID values through the UART connection and using BTT's serial port assistant. On my CoreXY printer, I have my X and Y motors set at P30 I1 D300. Yes, there is the vibration noise for the first couple of layers, but then it pretty much goes away.
For my cartesian printer, I have P50 I1 D200 for X and Y. I'm still messing with it. Anyway, I was able to achieve the same print quality I was getting before with my 2209s with exception of some salmon skin that I'm assuming is coming from the A4950s. Also, I use a little bit of linear advance. Usually in between .04 and .06. That seems to clean up the remainder of the overshoot.

I'll post some pics later when I get home to show the difference between the 2209s and A4950 closed loop setups.

AbeFM, 2020-10-02:
3rd vote for PID values setting from LCD.

PID Values+
       P
               Up/Down/Set
       I
               Up/Down/Set
       D
               Up/Down/Set

That would be a big help - or write a plain-text way to set values over serial:

READ/SET kP/kI/KD/MC(motor current)/DR(direction)/EN(able) <value>
so we don't have to do checksums and look up on charts of  A1 and B4.

Either one would be a big help.

Lastly: Yeah, the I-values are too big - the PID code needs to rescale that significantly.

Quas7, 2020-10-14:
Regarding the checksums, I assume they are in place because the noise on the lines with a powered motor is way too high to guranatee stable communication. Note, programming the board with motor enabled fails as well in almost all cases either during prog or verify.

The display programming option would be nice at least to modify the RAM values.
Saving the values to flash should maybe be set as seperate function after successfull testing.
I had twice the issue, that a interrupted calibration required a reflash of the firmware (stuck in bootloop).

swanepoeljan, 2020-10-15:
Was also thinking another reason could be due to the fact that the MCU is using the internal RC oscillator which is not always the most accurate for sampling bits.

I think it's anyway a good idea to have checksums, it's just not so nice if you have to manually calculate them. On my [fork](https://github.com/swanepoeljan/TrueStep) of this repo I completely rewrote the handling of the UART, modified the packet structure and included an 8bit CRC checksum. Then I also wrote a small C# program to communicate through the UART, in this case the program calculates the checksum automatically. If I find time over the next days I could maybe also adapt it to work with the original version...

Another modification I made was rewriting the OLED menu and this time I included the option to adjust the PID gains in RAM (as Till also mentioned). Then there is also a Save option which stores the gains to flash memory.

If anybody wanted to try it out, just keep in mind that it's still work in progress with limited testing being done so far.
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

Quas7, 2020-10-15:
@swanepoeljan this is great! I directly pulled your fork to a branch.
BTW, nice new name creation. 👍
And you already have your own promotion video for that: https://www.youtube.com/watch?v=zL2DP2p8xSg&ab_channel=TrueSteppersVEVO ;-D

swanepoeljan, 2020-10-16:
@Quas7 Thanks for giving it a try! Its good to hear that at least it could also compile and run on your side.

Haha... nice video ;-D

Good idea to use it for tuning, think it should not be that hard to implement. So in the firmware I could just add an option to start streaming angle values at a constant rate. Then as a first step just capture and write the reported values back to a csv file for manual processing. Then maybe later perform the processing/calculating of gains in the terminal and even add a graph control to display the result directly in the terminal...
I have a faint memory of Ziegler-Nichols method from Control System class but would have to take a look at the video you posted as a refresher.

swanepoeljan, 2020-10-18:
Made a little bit of progress, added a UART command to stream the angle values at 5ms intervals(200Hz). Then I also added a function in the terminal program to write these values to a text file (TuneLog.txt) so that we can use a spreadsheet for the initial manual calculations. (To convert the logged values to degrees, multiply them by 0.021972)

Trying the Ziegler Nichols approach (as proposed by Till) but having a hard time to get neutral oscillation state with my test setup (which is just a 100mm lever with a weight on the end). If I make Ki=1 then I can get it to oscillate but think its more due to "windup" when P is too low (slow) so not really a P only undamped response.
Just to illustrate the logging:
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

I am trying to assemble an printer bed assembly to test it on there but might take a couple of days until that setup is ready...

Just for interest sake, here is a response from pulling the 100mm lever (without the extra weight) back and releasing it (kind of step impulse) with the stock gains:
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

Quas7, 2020-10-18:
That looks really promising!
I guess, you already tried to point the leaver just vertically down for the free running P-based oszillation? Or just remove the leaver to get a baseline? I am also not sure, how one could calibrate PID for such an "uneven" load scenario.

This "humming" sound for bad calibrated setups is like 3-4kHz by ear.
Just figured, that measuring this via an audio spectrum app might also be a quick way forward. ;P

swanepoeljan, 2020-10-18:
Haven't tried it with the lever down yet, will also give that a try.
At least we can now see the response so should be easier to evaluate if certain gain changes improves the system or not.

Good idea to measure the humming through audio! The PID control loop runs at 10kHz, maybe when oscillating between two angles we get something close to a 5kHz tone...

AbeFM, 2020-10-27:
> I think it's anyway a good idea to have checksums, it's just not so nice if you have to manually calculate them. On my [fork](https://github.com/swanepoeljan/TrueStep) of this repo I completely rewrote the handling of the UART, modified the packet structure and included an 8bit CRC checksum. Then I also wrote a small C# program to communicate through the UART, in this case the program calculates the checksum automatically. If I find time over the next days I could maybe also adapt it to work with the original version...

This was my thinking exactly, I was all hot to write a program like that but I got busy with other stuff and I wasn't super sure how to approach it.
I found your compiled EXE on github, but I would love to see the source for it. Is that something you have posted, or would be willing to post?

swanepoeljan, 2020-10-28:
Sure, I just added it to the [utils](https://github.com/swanepoeljan/TrueStep/tree/master/utils) folder.

Was done in C# using VS Studio Community Edition 2019.

Quas7, 2020-10-28:
@swanepoeljan damn, now I have to check out how to C# as well. ;)

swanepoeljan, 2020-10-29:
:-) I am sure you will pick it up quickly.
It's really a very nice and powerful programming language!

caesar1111, 2020-11-06:
@swanepoeljan : thks for the gread job on the firmware. I have the same issues like kookaburra88 and this helps a lot with tuning the PID.
..another thing...
Since you are already following the issue Error in OLED initialization code #16, you know about the problem with the OLED. While I am trying to test the frequency settings on my installed S42B and Quas7 helped a lot in trying to solve it with an alternative firmware, we got no solution so far. I bought some S42B directly at the BIQU store and I am haunting down the support01@bigtree-tech.com support to give us a solution (right now they are tracking for a bad lot shipped).
But here is an additional request:
Can you add a configuration line in the menue where you can also alter the OLED frequency.... this would help us a lot to find a solution for those who suffer from the OLED issue. This would allow us to choose the frequency without having to flash the S42B all the time.
thks in advance....

Quas7, 2020-11-06:
as discussed over in issue #16 the OLED frequency does not fix it at least not on its own. Please test #20 as a workaround for now.

swanepoeljan, 2020-11-06:
@caesar1111  Glad to hear that it is helpful. As for the extra menu item, should be easy enough to add, I have some minor changes on my local repo that I planned to push to github over the weekend. I could then also add this option in there.

During the last days I also added an optioned to the terminal program that allows it to work with the original BTT firmware. It is limited to the functions provided by original firmware but should at least also help with PID adjustment. Will also upload this version (both the exe and source) over the weekend.

swanepoeljan, 2020-11-07:
@caesar1111 Added the OLED frequency change option to the menu and quickly tested it, seems to work. It's now also updated on my repo. For the moment it does not save the value to flash so if you reset then it starts again with the default decimal value 0. If it helps to solve your issue then I can make the value also saveable in flash (like for the PID gains). Keeping my fingers crossed that it helps!

swanepoeljan, 2020-11-07:
Just pushed the updated terminal program to my repo (zip in root and source in utils), there is now a checkbox ("Use BTT protocol") which allows it to work with the original firmware:
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

This should make it easier to change the parameters, compared to the originally provided terminal program. No need to calculate checksums or things like that, just read the current values, modify them and write them back again. Just note that every write operation writes to flash memory (unlike the TS version, the original firmware has no command for changing parameters in RAM only).

Pampinho1, 2021-01-15:
@swanepoeljan Any chance you can upload the compiled firmware to your fork? I am very interested on trying it out myself, but I am unable to compile it because PlatformIO complains about missing dependencies (In particular they seem to point to "stm32f0xx_hal.h" but I don't know enough to venture into that territory...)

swanepoeljan, 2021-01-18:
I have added a bin [folder](https://github.com/swanepoeljan/TrueStep/tree/master/firmware/S42BV1.0/bin) with the compiled firmware.

Pampinho1, 2021-01-18:
> I have added a bin [folder](https://github.com/swanepoeljan/TrueStep/tree/master/firmware/S42BV1.0/bin) with the compiled firmware.

Thank you so much for that. I have however found the fix to the errors compiling the firmware in #38 and combined your changes with that and it worked. Now I am just trying to figure out a change on the behavior in what seems to be the number of micro-steps. In Marlin I have it configured as running with 32 microsteps, but if I set the same value on the board it only moves half of the distance.

GhostlyCrowd, 2021-01-19:
@swanepoeljan Any change you can get your fork working with the V2.0 S42B from BTT, they haven't posted source which isn't surprising and it uses the STM32F1 MCU now

swanepoeljan, 2021-01-19:
Sounds very tempting and I actually have a V2.0 driver to even test it on! If I can just find the time...

Regarding the V2 source code, have a look [here](https://github.com/bigtreetech/BIGTREETECH-Stepper-Motor-Driver/tree/master/S42B/firmware/S42BV2.0 ).

TazerReloaded, 2021-01-19:
I have two V2 drivers on my printer for X and Y, they work quite well out of the box, so maybe they reworked the default settings (or my printer just matches them and I was lucky).
But of course I'm in for some tuning, so a version that works on 2.0 would be much appreciated! So far it's awesome that I don't have to worry about layer shifts anymore.

GhostlyCrowd, 2021-01-19:
> Sounds very tempting and I actually have a V2.0 driver to even test it on! If I can just find the time...
>
> Regarding the V2 source code, have a look [here](https://github.com/bigtreetech/BIGTREETECH-Stepper-Motor-Driver/tree/master/S42B/firmware/S42BV2.0).

Thanks for the link!  I'm following you on github so I'll keep an eye out if you happen to get the 2.0 project going :)

linewallker, 2021-11-30:
Hi There, do yo have any experience with configuration of pid in use with grbl? I actualy using Last version of fluid NC but I am experiencing some overshots in inner edging of engraved area, can somebody help please?

Thread 13 (2020-08-25):

Motor will not move!

tubaian, 2020-08-25:
I installed a S42B on the X-axis of one of my printers which has a SKR 1.4 turbo board and Marlin-2.0.5_7_7_20 installed and was working fine on a 2209 driver. Calibrated the S42B OK, commented out the X Driver info in Config.h, removed the references to stalled homing for the X-axis, changed the Minimum stepper pulse to 3 and Maximum stepper rate to 150000, all in Config.adv.h . Motor has faint vibration which changes slightly when I give a 'move X' command but the motor shaft does not turn. The only response to a move command is that the error value changes slightly and then goes back to its previous value (usually 0).
I have tried 2 different motors but neither work. Any ideas?

raimis170, 2020-08-31:
i have same. works only on calibration mode

AbeFM, 2020-10-02:
There's a note burried in the docs that says to set the minimum pulse width your printer is sending out - i.e. it might not be seeing the step commands. I believe this will require you to recompile Marlin, as I did.

I had other issues, I haven't tried going back, but it's something to look at.

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

tubaian, 2020-10-03:
Thanks AbeFM. In my initial post I did say that I had already tried altering the two items you specify but without any success. I haven't looked at changes in the s42b firmware sources though so I'll do that. I was going to try running them with an arduino to prove the motors are OK but I was so disappointed that they didn't just run 'out of the box' that I haven't got round to it yet..

AbeFM, 2020-10-05:
My bad - when I came back to this to answer it, I'd totally forgotten what I'd read.

You're still getting it to enable, right? Mine turned out to be missing the +5V line, then it saw the steps. If you're using a stock board I'm assuming that's there... I'm guessing the red "magnet too close" light isn't staying on (it's a second light)? I moved mine further, when trouble shooting, but it wasn't my issue and I feel is a little more unstable since.

With programming issues, it's dead in the water for now.

Quas7, 2020-10-05:
Could be realted to this observeration for certain bigger motors: https://github.com/bigtreetech/BIGTREETECH-S42B-V1.0/issues/19
The biggest motor also did not turn outside calibration in closed loop (open-loop no issue) but for slow movements the display shows increasing angle deviations till "red light" at 36° delta.

tubaian, 2020-10-06:
Abe, I was trying to use the motors on a stock Bigtreetech 1.4 turbo board with Marlin 2. I have tried them with an arduino basic setup and they run fine provided I have a delay of at least 7 - 8ms between step pulses. I have spent hours poring over the firmware source code trying to find somewhere I could modify the 'sampling frequency of the pulse signal' but without success. Its galling that a manufacturer would supply a product that won't even work with their other related products.

Quas7, 2020-10-06:
@tubaian you mean 7-8ms delay between rising edge of the step-input (from the arduino) and the actual motion at the shaft?
I would not directly conclude that this delay is coming from the "sampling frequency of the pulses" but is more the nature of a stable PID control because the D value shoud exactly do that (differential or "dampening"). Maybe you set D to zero and measure (if oszillations do not make it impossible).

AbeFM, 2020-10-06:
I read it as the delay between the ending of one pulse and the start of the next pulse - too close together, you'll miss the pulse and count consecutive pulses as one long pulse. It's a form of aliasing.

Probably you could test it. I'd turn microstepping all the way down, but you don't need to. Have the printer move in a line at a shallow angle - say 1 degree - and/or turn steps per mm way down. If it does that move slowly (straightforward g-code, something like G1 X200 Y2 F10), the idea being you could spread the pulses out enough that they will get counted.

If things work as they do in my head, you'll see the spacing between pulses go up and the system function as expected, and that'll verify your suspicions.

mirecta, 2020-10-06:
I have same problem open loop works perfectly but close loop only one microstep and hang at Err: 35.99 and red stil shinig , calibration is ok . in Marlin 2 i choose TB6600 which has some frequencies and puse width. my board is BT GTR , i have logic analyzer can i help you ?

mirecta, 2020-10-06:
And i has MKS servo 42A 1.1 too and its work with same motors but i want BT S42S .

tubaian, 2020-10-06:
The arduino code I was using to test the motors is as follows..

int stepPin = 5;
int dirPin  = 6;
int  enPin  = 7;

int numstep = 4096;
unsigned long ldelay = 10;
unsigned long mDelay = 500;

void setup() {
  // put your setup code here, to run once:

     pinMode(stepPin,OUTPUT);

     pinMode(dirPin,OUTPUT);

     pinMode(enPin , OUTPUT);

     digitalWrite(dirPin, HIGH);
     digitalWrite( enPin , LOW);
}

void loop() {
  // put your main code here, to run repeatedly:

  for(int x = 0; x < numstep; x++) {

           digitalWrite(stepPin,HIGH);

           delayMicroseconds(ldelay);

           digitalWrite(stepPin,LOW);

           delayMicroseconds(ldelay);

        }

    delay(mDelay);
    digitalWrite(dirPin, LOW);

I found I could change 'ldelay' down to 7 on one motor and 5 on another before they refused to move.  Hope this makes sense to someone..

AbeFM, 2020-10-06:
> I have same problem open loop works perfectly but close loop only one microstep and hang at Err: 35.99 and red stil shinig , calibration is ok . in Marlin 2 i choose TB6600 which has some frequencies and puse width. my board is BT GTR , i have logic analyzer can i help you ?

Ah! I had this once. When I first put mine together, it worked fine, but then I spaced back the sensor board 1.2mm (printed washers), and a couple times it did this, especially if I bumped the wheel by hand.

When I looked it up in the manual it says it might leave the light on like that if the magnet is too close. Anyway, I was about to say check magnet distance (supposed to be 2-4 mm), at least it's something to look at. Got what it's worth, my spacers are still in there and it only happened a couple times.

@tubaian - thanks for the code snippet, that looks great and it's cool you got a tester going like that. Those are with the same BigTreeTech board but different motors?

Quas7, 2020-10-06:
@tubaian Ok, so you experimentally found evidence that the timings from the S42B manual are still to fast for some batches?
Little sidequestion, did you use an Arduino Board with 5V or 3.3V controller?

And more imporant, did you already set the minimum stepper pulse width to 7 or more in configuration_adv for testing?
/**
 * Minimum stepper driver pulse width (in µs)
 *   0 : Smallest possible width the MCU can produce, compatible with TMC2xxx drivers
 *   0 : Minimum 500ns for LV8729, adjusted in stepper.h
 *   1 : Minimum for A4988 and A5984 stepper drivers
 *   2 : Minimum for DRV8825 stepper drivers
 *   3 : Minimum for TB6600 stepper drivers
 *  30 : Minimum for TB6560 stepper drivers
 *
 * Override the default value based on the driver type set in Configuration.h.
 */
**#define MINIMUM_STEPPER_PULSE 7**

mirecta, 2020-10-07:
i will try it today
#define MINIMUM_STEPPER_PULSE 7

tubaian, 2020-10-07:
Quas7, I used an Arduino Uno with a single stepper breakout board. I had the MINIMUM_STEPPER_PULSE in Marlin set to 3 as Bigtech's page suggested - I'll try upping this to 7 later today. Thanks.

mirecta, 2020-10-07:
#define MINIMUM_STEPPER_PULSE 7 not work for me in close loop  stil freeze at 35.99 , in open loop still works perfectly

mirecta, 2020-10-07:
it is point to measure problem because in open loop it works even with pulse 2 and more,

tiagomaricate, 2020-11-03:
Is it solved? Same problem here.

Quas7, 2020-11-04:
> it is point to measure problem because in open loop it works even with pulse 2 and more,

comparing open-loop vs closed-loop might not work because the load on the controller is completely different in both modes. The controller does not have to manage the angle measurment and PID control and that might improve its response behavior for shorter pulse-length etc.

Quas7, 2020-11-04:
@tiagomaricate after testing with many different motors I can say, that the motor design itself is a strong factor. Try using a different nema17 model without any "magnetic parts" (test with a magnet) on the backside.

tiagomaricate, 2020-11-04:
> @tiagomaricate after testing with many different motors I can say, that the motor design itself is a strong factor. Try using a different nema17 model without any "magnetic parts" (test with a magnet) on the backside.

Indeed.
All my original nema have metallic plates/boxes on the backside.
So I tested with a new motor I bought a month ago. This motor has a plastic cover on the backside. And worked.
Now I'm checking if is best just to replace X and Y motor or replace all, to keep a standard configuration.

Quas7, 2020-11-04:
I am quite sure you can make it work with any motor, if you just move the board and encoder magnet very far away from the magnetic noise. I saw installations working fine on the "pulley side" instead of the backside.

NZ-Nitro, 2020-11-10:
Another person being driven mad by this problem, but also calibration accuracy as an example I give the axis a 10mm command and measure with verniers a 7.5 mm movement

- Tried changing the dip switches 1, 2

- Tried changing the steps per mm, this made no change on the error

- Tried changing the #define MINIMUM_STEPPER_PULSE no change on this error

- Reinstalled all the software on the computer no change

-

Quas7, 2020-11-10:
@NZ-Nitro maybe you checkout #24 and #19
Very likely your nema17 motor is interferring with the magnetic encoder or your motor is wired differently than the board.

Mercury3D, 2021-06-04:
Hello,
Has anyone made any progress on this issue?  I am having the same hangup whereby the motor will do 1 microstep then hang at -36 degree.  Have tried all the switches, calibrations, marlin alterations and this problem is still occurring.  I am using S42B V2.0 full motor/sensor assemblies from BigTreeTech (meaning i have not altered spacing of the board or magnet.).  Trying to use these for the y axis of an Ender 5 Plus.  Even if i disconnect the motor from the frame and try moving the motor away from the machine it self it still will not move.  Open loop mode works fine, but as soon as i enter closed loop mode it seizes up.   Any help would be greatly appreciated have been trying to make this work for weeks!

ElekPat, 2021-06-04:
See this https://github.com/bigtreetech/BIGTREETECH-S42B-V1.0/issues/33, it worked for me.

Thread 14 (2020-09-04):

Steppers misbehaving workaround and steps per mm wrong

Marcusbjol, 2020-09-04:
When I recieived the 2 stepper motors, one did not move. I followed the fixes in teaching techs video by changing 2 lines in config_adv.h

#define MINIMUM_STEPPER_PULSE 3
#define MAXIMUM_STEPPER_RATE 150000

After implementing this, both steppers worked.

However, both have radically altered the steps per mm setting. Before the changes, they were set to 1280 with 16 microstepps. After, the movement was way off. By some experimentation, I was able to get it to print properly with y 204.95 and x 207.03 and 32 microsteps on both.

Reading config_adv.h, I will try
#define MINIMUM_STEPPER_PULSE 1
#define MAXIMUM_STEPPER_RATE 500000
to match the driver.

BluPix, 2020-09-06:
Hi, i have discovered from manual that 32 microsteps means 8192 steps per 360° revolution.
So correct formula for steps per mm is: 8192 steps per revolution / (2mm GT2 belt * 20 tooth per revolution ).
example:
8192 / (2 * 16) = 256
8192 / (2 * 20) = 204.8

kamilj, 2020-09-09:
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

You do not read the documentation :P

42 Stepper Motor Closed Loop Driver Board User Guide
ShenZhen BigTree Technology CO.,LTD .

5、We found that when SKR V1.3 motherboard was used
to drive this driver, the motor did not rotate after the
motherboard gave S42B pulse.This is because the pulse
frequency was too fast and S42B could not be detected. At
present, there are two ways to modify:
1.Modify pulse width and pulse frequency in Marlin
firmware.
Details: Modify the high pulse width in configuration. adv,
# define MINIMUM_STEPPER_PULSE 3
# define MAXIMUM_STEPPER_RATE 150000
2.Modify the pulse signal sampling frequency in the S42B
firmware source code.

Marcusbjol, 2020-09-09:
The documentation is poorly written and translated (former tech documenter here). I did find a solution and documented it here for others to find.

Funny enough, hard coding

#define MINIMUM_STEPPER_PULSE 1
#define MAXIMUM_STEPPER_RATE 500000

work as well.

fjrpilot05, 2020-09-13:
@Marcusbjol
You are absolutely correct.  As it turns out it appears that your suggestion works better especially when the implementation is mixed with TMC2209's on the other axes.  I think this is so because these settings are global across all axes and the suggested settings in the manual (pulse 3 and rate 150000) severely hamper the 2209s.

Quas7, 2020-09-13:
in Marlin firmware you can just select the TB6600 drivers for the axis with the S42B in the Configuration.h Stepper Drivers section. Worked for me without issues with TMC2209 on X/Y/Z and only extruder with S42B.

This activates this timing profile just for the respective axis (see configration_adv.h in Marlin).

Minimum delay before and after setting the stepper DIR (in ns)
1500 : Minimum for TB6600 drivers (guess, no info in datasheet)

Minimum stepper driver pulse width (in µs)
3 : Minimum for TB6600 stepper drivers

Maximum stepping rate (in Hz) the stepper driver allows
150000  : Maximum for TB6600 stepper driver

fjrpilot05, 2020-09-14:
Thats an awesome suggestion.  I'm gonna try that right away.
Thank you

Marcusbjol, 2020-09-16:
Seeing odd behavior regardless of which stepper timing I set (tried their recommended settings). The first move of the X-axis moves very rapidly and then moves as expected. Their firmware needs some work.

Additionally, as stated before, their solution degrades performance with their TMC2130 stepper drivers as well.

They are responsible for providing compatible firmware for all their products (using BTT SKR 1.4 Turbo, BTT 2130 Drivers for Z+E0+E1, and BTT closed loop for X+Y). Incomplete product they need to update.

Quas7, 2020-09-16:
@Marcusbjol
for the rapid movement at (re-)enabling you can check here (solved): https://github.com/bigtreetech/BIGTREETECH-S42B-V1.0/issues/3

The timing can be set in Marlin per axis using the "TB6600" timing profile without impacting other stepper drivers.
Marlin documentation improvment for this is suggest already here: https://github.com/MarlinFirmware/Marlin/issues/19391

Marcusbjol, 2020-09-18:
Implementing that fix solved the issues.

Thanks for the help guys.

fjrpilot05, 2020-09-22:
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

Hey Quas7,
I just wanted to circle back and Thank you for your suggestions.  I've got my setup pretty much to a happy place thanks to your suggestions.

Regards,
Kevin

Quas7, 2020-09-22:
Hey Kevin,

great that it worked out as intended and thanks for giving positive feedback. :)

Best regards,
Till

GIANNHSitia, 2021-02-14:
hello, i have same problem. i change X , Y axis driver with S42B 1.1 . Working but with wrong steps per mm..For examper: instead of moving 150mm this move 120mm.. with old driver work ok.. i add to configuration.h this lines.... but dont change nothing. how to fix this? sorry but my english is not good

#define X_DRIVER_TYPE TB6600
 #define Y_DRIVER_TYPE  TB6600

Closed 2020-09-18.

Thread 15 (2020-09-09):

Dual steppers (z axis) wiring confusion

lousassole, 2020-09-09:
Good morning,

I cannot figure out how to wire dual Z to the S42B drivers on my SKR 1.4 turbo. It appears that i could use the adapter as well as the CLS pins on the board, but am not sure if this would cause issues. Would i be better off crimping a cable to use them in parallel, or daisy chain them? I just don't want to experiment with it and let the magic smoke out of the board or burn out a motor.

Marcusbjol, 2020-09-18:
I am no expert on this, so take what I say with a grain of salt.

It should make no difference (parallel or serial). There might not be enough signal strength for 2 closed-loop controllers to function. Burning out a motor is unlikely with the power not being enough, but the double draw of the motors might be (probably not tho).

Test it out and let us know how it goes.

Quas7, 2020-09-18:
maybe you add a drawing, what you want to wire in which way?

do you plan to go for serial Z before or after the S42B?
With "after S42B" I mean one motor with encoder and the second motor is just following via series connection of A1,A2,B1,B2 connection. This would be the only possibility to wire something in series, in my opinion. There is no power issue in this setup as the current stays same as for one motor.

In parallel config, all pins besides maybe GND and Motor-Vcc from the mainboard socket can be connected in parallel.
GND and motor Vcc should be wired directly from a bigger connector than the socket as two motors in parallel might exeed the single pin current limit.
But, for a normal double Z axis the motors should not run above max 2x 800mA (RMS) which should be still fine for dupont style sockets and alike (max 2.5A up to 85C ambient, datasheets are hard to find on that rule of thumb though)

In my opinion, Z-hybrid steppers are quite an overkill as the repeatability and stability of Z with lead screws is normally a decade better than the X/Y belt axes.
Maybe improves belt driven Z axis setups.

Marcusbjol, 2020-09-18:
Definatly mainboard -> 42B -> 42B.

I got my feet wet on smoothie and they have specific instructions on wiring external drivers in parallel (http://smoothieware.org/general-appendixes#multiple-drivers-in-parralel), so it should work in this setup.

Thread 16 (2020-09-22):

Error in OLED initialization code

jmdhuse, 2020-09-22:
In the file oled.c, where the clock divide ration and oscillator frequency are initialized with the 0xD5 command.  The parameter
in the file is "80", but I think it should be the hex value "0x80".  This might address some of the display instability issues.

Quas7, 2020-09-22:
Interessting finding.
Expected for D5h is a 8-bit value representing [3:0] 4-bit "clock divide ratio" and [7:4] 4-bit "Oscillator Freq."
0d80 = 0b 0101 0000 = ~320 kHz clock and divider 1
0x80 = 0b 1000 0000 = ~380 kHz clock and divider 1 (this would be the default setting)

I experienced many display issues before updating the firmware via this repo. But, I still have display issues after 20h printing.

Therefore, I will try to measure PWM frequency of the motor drivers and stay away from the harmonics for the clock+divider setting.
I did not find the magic number for the PWM frequency in the source code yet. Maybe someone else has more luck/skill?

adding the relevant datasheet informations from p.43 here:

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

10.1.16 Set Display Clock Divide Ratio/ Oscillator Frequency (D5h)
This command consists of two functions:
• Display Clock Divide Ratio (D)(A[3:0])
Set the divide ratio to generate DCLK (Display Clock) from CLK. The divide ratio is from 1 to 16,
with reset value = 1. Please refer to section 8.3 for the details relationship of DCLK and CLK.
• Oscillator Frequency (A[7:4])
Program the oscillator frequency Fosc that is the source of CLK if CLS pin is pulled high. The 4-bit
value results in 16 different frequency settings available as shown below. The default setting is
1000b.

[SSD1306-SolomonSystech.pdf](https://github.com/bigtreetech/BIGTREETECH-S42B-V1.0/files/5260380/SSD1306-SolomonSystech.pdf)

Quas7, 2020-09-29:
Jan pointed out, that 187.5kHz might be the PWM frequency.
https://github.com/bigtreetech/BIGTREETECH-S42B-V1.0/issues/17

Therefore, staying away from 375kHz would be a good idea to get stable communicaiton but the default setting is hitting the first straight harmonic (380kHz +/-).

caesar1111, 2020-09-30:
Hi and sorry to ask this silly quesiton, but is there a description in how to connect the S42B to the computer? I not an expert in programming microcontrollers, but stumbled across the problem you described on two fo my three controll boards I just recieved recently. I will try the 0x80 default setting and everything is already compiled, so I just need the description on the  "hardware part" of how to connect the controller...Thks in Advance

Quas7, 2020-10-01:
sure, no problem @caesar1111 .
I explained the hardware setup here https://github.com/bigtreetech/BIGTREETECH-S42B-V1.0/issues/3

It might be better to change the OLED to something 25% faster or slower than 0x80 as this is hitting the PWM frequency as a possible source for interference.

caesar1111, 2020-10-01:
@Quas7 thks a lot, I just order this programmer: https://www.amazon.de/gp/product/B086TWZNMM/ref=ox_sc_act_title_1?smid=A1X7QLRQH87QA3&psc=1
as for the requency.. should I go with the 0d80 you mentioned above?
and just to be sure, you mentioned "SWCK, SDO, GND" in your description. In the pinout there is just the SWDO, so I will go with this mapping:
S42B pin  ->  Programmer PIN:
SWCK      ->  SWCLK
SWDO     ->  SWDIO
GND        ->  GND
3.3V         ->  3.3V
will post as soon as I have the programmer and had a chance to flash the board... my SK-Go² is waiting for some torture tests on the S42B. Spare belts are ready :)

Quas7, 2020-10-01:
If you power the board from another source, I recommend not to connect 3.3v (in theory, the stronger voltage source kills the weaker one or just generates heat).
SWDIO is correct (Serial Wire Data Input/Output)

I would try the lowest frequency range first with 0x00 (280kHz +/-). This whould be centered somewhere between the harmonics of the PWM.
If I find time, I will build a small coil probe and try to measure the actual frequency peaks with an Osci or a nanoVNA.

I run S42b only on my extruders as it keeps the motor very cool compared to just pushing current through it with open-loop stepper drivers. For other drivers I did not see the benefit - if I miss steps, there is something else wrong. And even with S42b the timing will get a hit with to fast moves at the limit, I think.

nhabes79, 2020-10-02:
Interesting discussion. I too can't stand the instability of the OLED screens. They simply aren't useful. I have found that when my printer is powered down and I have the OLED powered through an ST-link or UART, they are super stable. No issues at all.

I actually do have these motors on my y and x axis. I like to do a lot of stripes in my TPU prints, so I'm changing colors a lot. I'm a bit heavy handed and sometimes bump the print head when I am changing colors. Print is over right then and there. Also, I recently got a delta printer. Love it. Changing colors on it is a nightmare. I have about a 50% chance of knocking the print head out of alignment.

I also like to print fast. Sometimes this causes the print head to come out of alignment.

Anyways, I'm hoping these motors fix the problem.

I'm not a programmer and most of the programming vocabulary goes right over my head. I am curious though if you all are having success changing the firmware for S42B. I was able to find something online that showed me how to make VScode/platformio compile as a hex file. I use ST utility to upload the firmware to PCB, but nothing ever seems to change. First of all, the firmware I compile is 85KB while the stock is only 73KB. That seems odd considering I've only been changing the PID values. Secondly, when I use the ST utility to compare the stock firmware to a firmware I've compiled, it is wildly different. Doesn't make much sense to me if I'm only changing a couple of numbers.

The only way I've been able to successfully change the PID values is through the UART connection and using BTT's serial port assistant. That works, but that doesn't have all the options that you all are talking about with the OLED screen issues. Also, while I'm thinking about it, if I change the PID values in the firmware, compile and upload, then check them through the UART connection and BTT's serial port assistant, the PID values are still the same as they were before. It's weird. Nothing changes when I compile a new firmware.

Quas7, 2020-10-02:
Just thinking, maybe it is easier to enable "advanced pause" in Marlin and do a home-after-change?
Normally, the homing precision is 0.05mm with mechanical endstops. A repeatability test can be enabled in Marlin as well to verify that.

I have also bought last week an ultra cheap delta printer (FLSUN Q5) and I love it as it is really ultrasilent after a few mods (fans, hotend, UART steppers, BMG extruders, etc.) but as it is a bowden I do not touch the print head for changing filaments at all and I installed a TL Y-splitter for 2 color prints. But I have to do more testing this weekend to get some statistics for possible errors first.

Regarding your flashing issue.
I do not get a hex-file after compiling but a binary and this is 30.872 bytes big. That should be the default for this repository, I think.
As nothing changes for you but the upload seems to be valid and without any offence... did you check the time stamp on your hex files after compiling? Just want to make sure, you really flash a freshly compiled hex and not a leftover file from the repo itself. ;)

My binary compiled via vs code + platform.io is located in \firmware\S42BV1.0\.pioenvs\BIGTREE_S42B_V1_0\firwmare.bin

AbeFM, 2020-10-02:
> @Quas7 thks a lot, I just order this programmer: https://www.amazon.de/gp/product/B086TWZNMM/ref=ox_sc_act_title_1?smid=A1X7QLRQH87QA3&psc=1

I just got that one, or one just like it - and am having really mixed luck with it. Some times it'll connect, sometimes it drops. I don't trust this controller and I don't trust the STLink and it's been a LOT of debugging. I'm looking forward to seeing how that goes for you.

The first time I tried programming it powered by the dongle (and DISconnected from the printer by pulling the white cable) it didn't work, and plugged into printer it didn't work until I fed +5V on the 5V line. Today, it only works powered from the dongle and not when powered from the printer.

Perhaps a seperate thread for general programming issues makes sense so as not to clutter firmware issues.

@nhabes79
>I use ST utility to upload the firmware to PCB, but nothing ever seems to change. First of all, the firmware I compile is 85KB while the stock is only 73KB. That seems odd considering I've only been changing the PID values. Secondly, when I use the ST utility to compare the stock firmware to a firmware I've compiled, it is wildly different. Doesn't make much sense to me if I'm only changing a couple of numbers.

I was using the same process this morning. My firmware was 30,872 bytes, like the one @Quas7 posted. I couldn't get stuff to upload from VSC/PIO but I can't tell with all my connection issues what's going on. I'm getting .bin files, BTW.
I'm also hoping to use this to prevent occasional skips on the Y-axis - I've set the speeds and accels so low it's really effecting my printing.

Are you hand-calculating the checksums? I found a calculator, tried to write a spreadsheet, but I think I'll have to get into VBA or something to get the checksums and was figuring I'd just use the online calculator. :-\

Re: Changing filament: You should be able to do that with just g-code commands, or through the menus, you can set up load and unload procedures where you shouldn't have to tweak the extruder directly, I've got this on both bowden and direct drive units... And even so, I don't knock the head around as long as it's locked in position... Perhaps a Delta would be less stable?

Lastly:
I added a block RIGHT after the includes:

//Set gain constants here. OEM defaults are 30/10/200
#define kP_Gain 30
#define kI_Gain 5
#define kD_Gain 200

and edited 314-316 to be:
int16_t kp=kP_Gain;                //was: 30
int16_t ki=kI_Gain;                //was: 10
int16_t kd=kD_Gain;               //was: 250

I just don't like scrolling.

Quas7, 2020-10-02:
@AbeFM I can feel your pain with the programmers.
I have various stlink clones, an original stlink v3 and a bag full of converted black magic probes (you can convert a stlink clone or a blue pill board) as well as an original black magic probe. In my experience, all of them work fine but the clones not always at full speed at with all tools (e.g. ST software).

For uploading with stlink clones I noramllyy use st-flash: https://github.com/stlink-org/stlink
But you have to install MSYS2 MinGW (linux in windows) to use it.

The problem with the S42B is mainly the PWM output stage, if the board is "enabled" (normally it is active low!).
You can try to set motor current = 0, enable active high (stays off, when unconnected) or remove the motor voltage supply from the JST connector.

nhabes79, 2020-10-02:
**Quas7** - Funny. I just got the FLSUN QQS. Changed out the board for an SKR 1.4 turbo with 2209s. Loud as can be. Easily my loudest printer and my corexy and cartesian also used to run the same setup and you could barely hear them. I have to learn more mechanically about the delta to see what is causing all the racket. But man, do I ever love the speed of the delta.

I've always used Cura as my slicer. Works good enough for me. I just use its function to pause at a certain layer and move the head away from my print. I manually pull the filament out and change it. I don't touch the print head at all for my delta to do this (bowden setup), but the print head slightly moves almost every time no matter how careful I am. This is what originally got me on the idea of these closed loop setups. I like your idea of advanced pause feature, but I'm afraid I would still run into the same issue. Also realize I'm doing this with TPU. Sometimes I have to push hard to get the new filament pushed into the hotend. It's uncommon for me to bump my CoreXY or cartesian, but it still happens (probably 10-15%). I've already noticed that the closed loop function still works when my printer is paused. I've pushed hard on my print heads for both of those printers and it snaps back into place - waiting patiently for me to change the filament. :) This is obviously a "me" issue. I'm heavy handed and I'm just looking for an extra "crutch" to help me out on these filament changes. Especially once I convert my delta.

I changed something in VS code or something in platformio.... I can't remember. Somehow, I got it to compile into a hex file. I thought I had to do this because the S42B firmware is hex. I didn't know I could compile it as a binary and just use it that way. That would be a lot easier.

Yes. I check the timestamps on my files. lol. That's one of the first things I learned when I first downloaded this software to compile marlin. Learned that the hard way. I'm definitely uploading my latest compiled hex files, but now I'm super curious to try out using binary to see if that works. I'm tired of doing all the checksum calculations using BTT's serial port assistant.

Yes, the lines you mentioned in the firmware (314-316) - those are the ones I've been changing with no luck. Nothing happens. We'll see when I try with making a binary file.

**AbeFM**

Yes, I've been hand calculating the checksums (just learned what that was the other day). I too thought about making a spreadsheet, but things get more complicated, at least for me and the time I want to spend, when it comes to adding up the negative numbers. And that one took me awhile to figure out (especially the D value if you want to try something above 255). You have to use the negative value (didn't know that was a thing when I first looked at this) for A2 (A0 or A1 for P and I), then add it to 05 and your new value you want to put in for P, I or D. However, it all has to stay in 8 bit form, so the checksum can't be bigger than 2 characters. In that case, you need to split up your new P, I or D value into 8 bit form and add those two numbers separately. Took me way too long to realize that one. I have a feeling though I'm just saying things you all already know. Hexidecimal is all new to me.

The thing you did with setting the gain constants, do I have to do that to change them? I tend to just leave my VScode open to the spot where I want to change. Really no scrolling involved.

Yeah, I figured I could use gcodes to do a color change, but I found a way that works for me. Every time I've tried to setup something via gcode, something goes wrong. Like after a color change the print head will go back to printing but push out another 50mm of plastic first before restarting and thus ruin my print. I could keep trying to go down this route, but I like what I do. For the most part, it is easy. I could try sending the printhead to home to change my filament, but its extremely hard for me to do on my corexy at the home position. The cartesian would be easier, but I guarantee I can still bump it out of place. Most of my color changes go smoothly. Sometimes things just get stuck and I have to force it a bit more to get through the extruder (Hemera on my corexy and bmg on my delta and cartesian). That's usually when I bump it. As for the delta, No matter what, I'm going to bump it. Doesn't matter where I tell it to home.

Quas7, 2020-10-02:
@nhabes79
You can try to flash my compiled binary from this thread [https://github.com/bigtreetech/BIGTREETECH-S42B-V1.0/issues/3#issuecomment-691197566], in case you still run into issues with your compiled one.
https://github.com/bigtreetech/BIGTREETECH-S42B-V1.0/files/5210515/S42B_fw_P30_I10_D200.zip
My default was P30 I10 D250 - I hope, that is also yours. If you need other values to verify, let me know.

Quas7, 2020-10-02:
In case, you want to convert your cheap stlink v2 clones to a blackmagic probe: https://github.com/sakana280/stlink-tool
Worked for me right out of the box.

nhabes79, 2020-10-02:
Ok, first of all, I don't know what any of what you said here means:

And I just noticed, that all this checksum magic is maybe needed because the devs have been aware, that there is an EMI issue for an enabled drive stage. ;)

That's unfortunately above my pay grade. I get into the weeds quick when I try to get information out of computer stuff/programming stuff message boards. Very quickly I have no idea what anyone is talking about. I also don't know what a blackmagic probe is or why I would want to convert my ST Link to one. I also don't know what powercycling is that will remove something called a BMP upgrade.

No worries. Maybe someday I'll look up what this all means.

So, the PID values you have in your firmware file are the stock ones. I'm truly amazed that you got that to work. Having my I value above 1 is an imediate failure. Didn't matter what my P or D values were. Have a look at the pictures below. These were all done on my cartesian printer. The one on the left is with TMC 2209s in open loop. The one in the middle is with the S42B closed loop with stock PID values. The print quality is horrendous. The overshoot is super obvious. The layers can't even stack on top of each other. The one on the right is with my PID values that I entered in hand calculating the hex numbers and using the serial port assistant to do so.
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

Now, here is where it gets interesting. I changed my platformio back to creating bin files instead of hex. I remembered now, you have to make an edit in the main.py file.

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

Anyway, I went ahead and compiled my own binary file. Ended up being the same size as your binary file. All good. I used STM32 ST-Link utility to flash it to the S42B. It asked me if I wanted to start at a specific address 0x08000000. I have no idea what that means. I just clicked ok. I then checked the PID values in the serial port assistant. Looked weird.

Then I decided to flash your firmware to my S42B and check the PID values in the serial port assistant. This picture below is exactly what I got whether I used your binary firmware or mine.
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

If this is what you are using, I don't think your I value is 10 either. I think yours is like mine and is set at 1. Why is P at 040 and D at 025? I have no idea. Either way, I'm back to square one and will have to make PID adjustments through the serial port assistant instead flashing firmware.

Unfortunately, all these tests have now completely jacked up one of my S42B boards. I tried to flash back to the stock firmware (the file called ITEM.hex in the S42B files) and now I get this if I try to check my PID values. the motor still works, but I can't read any of the values on my board nor will it allow me to change them. If you have any idea on what I have to do to flash this back to stock so I can use the serial port assistant again, it would be much appreciated. I don't have to go the route of flashing firmware to change my PID values. The serial port assistant was working fine before even if I had to hand calculate the values. I'm fine going back to that.

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

Quas7, 2020-10-03:
No problem @nhabes79. Obviously, you do not need a blackmagic probe or anything fency as your clone is working with the ST link software (many stlink v2 clones do not work this way).
These PID values are stepper motor specific and I use my S42B only for the extruder where I have naturally a crazy high dampening on the movment (geared extruder and pushing filament). Therefore, my "I" values can stay stock.

I think, the flashing you do is actually not erasing the part where these values are stored.
Maybe it helps if you do a full "chip erase" before flashing?
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

caesar1111, 2020-10-05:
Hi,
good the read up on the article, since I hit a similar wall while tuning my SK-Go² (corexy) now running the S42B for X and Y:
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. As you can see, the overall quality is not to bad, but:
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
I have a severe overshooting on the corners. It does not matter what material (black is PLA, organe is PETG), no matter what temperature, acceleration or print speed. So if you are now telling me that this could be related to the PID setting in the firmware of the S42B, at least this leave me with another thing to check up.
Since I am still waiting for my programmer to arrive, I cant really start the testing, but what would help for a fast feedback is a precompiled firmeware which is adressing the OLED frequency and the PID issue, just to start into the right direction.....
....will come back as soon as I have the programmer...

Quas7, 2020-10-05:
@caesar1111 are you sure, that this is really XY is overshooting and this is not just overextrusion because of low Jerk/Acceleration at corners?
This overextrusion is typical for FDM, if there is no linear advance (pressure advance) enabled and calibrated. If you are slowing down at corners the molten plastic is not following a linear characteristic (it is lagging behind) as the mechanics do.

Did you try with "open loop" (switch 3), if you get the same?

caesar1111, 2020-10-05:
@Quas7 its a good point. I didnt have the issue when I was running the printer with  0.9 steppers and TMC2209 for X and Y... but I was also changing to Volcano hotend in the process of migrating.
So LIN_ADVANCE is not switched on so far, but I was playing around with jerk (or nowadays #define JUNCTION_DEVIATION_MM 0.01) and the acceleration:
#define DEFAULT_MAX_ACCELERATION      { 2500, 2500, 50, 2500 }
#define DEFAULT_ACCELERATION          2000
#define DEFAULT_RETRACT_ACCELERATION  2500
#define DEFAULT_TRAVEL_ACCELERATION   2500
starting the acceleration at 500 and went up to 2500 but this didnt change anything....
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
....so next stop: enable and tune in linear advance.

Quas7, 2020-10-05:
Ok, with a volcano this non-linear effect is even more pronounced.
BTW, the testcube is maybe not the best object to test for acceleration and jerk as you need some free distances to get to full speed first.
TeachingTec goes over the basics well enough, I think:
https://www.youtube.com/watch?v=Mnvj6xCzikM&t=933s&ab_channel=TeachingTech
https://www.youtube.com/watch?v=rp3r921DBGI&t=123s&ab_channel=TeachingTech

nhabes79, 2020-10-05:
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

Ok, I have to laugh, but that's exactly what I did that has completely messed up my S42B board (full chip erase, then flash with stock ITEM.hex firmware). No idea why. I have some new S42B boards coming in, just a shame I can't adjust this particular one anymore. Everything else on it still works. It still runs the motor fine in my printer, I just can't adjust the PID values now.

Quas7, 2020-10-05:
@nhabes79
There is one more thing to try as I ran into this for an MKS servo42b recently.
In settings decrease the communication speed to 250kHz and set it to "Software System Reset"
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

Than check the Option Bytes.
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

All flags shood look like in this screenshot (readout from a S42B):
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

Especially the WDG_SW has to be enabled, otherwise it will reboot continously.
Also, all pages should have "No Protection". If there is a mark it will show "Write Protection". I think, platform.io will still give you a "success" but the actual write will fail but that might have been only my setup.

Quas7, 2020-10-05:
To get back to the orignal topic and close this.
I tested now several hours with 0x00 instead of 80 (0d80) to get ~270kHz of display com speed and away from the assumed 187kHz(?) motor PWM harmonics.

I do not see any more display glitches and I do not notice any other issues with this.

0d80 = 0b 0101 0000 = ~320 kHz clock and divider 1
0x80 = 0b 1000 0000 = ~380 kHz clock and divider 1 (this would be the default setting)
**0x00 = 0b 0000 0000 = ~270 kHz clock and divider 1**

I will therefore start a PR for others to test this as well.

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

AbeFM, 2020-10-05:
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

Oh, Ah! I didn't know this end could negotiate for slower speeds - totally I'll do that, the 4MHz would rarely, rarely work.

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

And there's a good chance this is at the heart of my rebooting continuously issue. My flags were all messed up, I'll take another look.

Pretty cool about the screen timing. Hasn't been an issue here, but it's a good approach.

swanepoeljan, 2020-10-06:
@Quas7 Regarding the PWM frequency, I hooked up my scope to the VRef pins of each driver and tested it. It was indeed very close to 187kHz so I can confirm it. Wasn't spot on but could be because the MCU uses the internal clock...

caesar1111, 2020-10-07:
got the programmer as mentioned above.

changed the OLED freq to 0x00 = 0b 0000 0000 = ~270 kHz clock and divider 1 in oled.c

changed the main.c to
int16_t kp=30;                // caesar: changed from 30 to 30 (no change so far)
int16_t ki=5;                // caesar: changed from 10 to 5
int16_t kd=200;               // caesar: changed from 250 to 200

installed STM32 ST-LINK Utility v4.5.0.exe

updated the programmer:
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
with the current firmware:
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
changed the target setting:
Connections setting freq ot 240kHz and Reset Mode to System Software Reset
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

disconnected the S42B board from the stepper and connected the programmer:
S42B pin -> Programmer PIN:
SWCK -> SWCLK
SWDO -> SWDIO
GND -> GND
3.3V -> 3.3V (yes, 3.3 was working for me without any issue)

Erased the chip

And just hit program to upload the S42BV1.0\.pioenvs\BIGTREE_S42B_V1_0\firmware.bin which I compiled with visual studio code......

.....I went without any problem.
Now I connected my spare newly programmed S42B incl. stepper to the printer and running a static test of the display stability. if that works out for some hrs I will install the stepper and start to do a dynamic test.

So thanks to all for helping me to get so far. I will post if all the test run successful and read up on the best PID setting....

caesar1111, 2020-10-07:
...ok, the OLED shut down on its own after about 8hrs.... but way better than the 30 sec. before flashing.
I will retry with the 0d80 = 0b 0101 0000 = ~320 kHz clock and divider 1 setting....

swanepoeljan, 2020-10-08:
You probably figured it out by now, but you could use just "80" or "0x50" (which is 80 in decimal), so it should read:
OLED_WR_Byte(80,OLED_CMD);

Quas7, 2020-10-08:
@caesar1111 I would opt for testing 0b 1010 0000 = ~410 kHz clock and divider 1 next. The 0d80 is the default in this repo, if I remember correctly and did not solve it for me.

caesar1111, 2020-10-11:
No success!
I was testing the complete frequency spectrum up and down. (0x02 up to 0xF0) and especially with the divider 2 I was doing literally every step possible. And
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

Thread 17 (2020-09-26):

Reverse engineer and firmware rewrite

kablek, 2020-09-26:
I must admit I was very sad when I received my S42Bs and they didn't work well (display issues, skewed prints, steps missing, ...). At the time fixes for said problems were not available on this github page (and even today some are not really sure to work).

The code is not well documented, it is messy and apparently it doesn't work too well. Would anyone be interested to cooperate/make/use fresh code and decent open source firmware?

I have experience with STM but I am not ready to commit to such project if there is no interest in making such project happen if there is not enough interest.

swanepoeljan, 2020-09-27:
I bought one of these just to experiment with, haven't installed it in my printer and also don't intend too (for the moment). The idea is more to see if I can use it for a basic robot arm project I am planning in the next weeks/months.

In general it seems to work okay but there are lots of features missing for what I have in mind, some of these are things like reading back the angle through the UART or getting notified when it stalls, etc. So as a starting point I [forked](https://github.com/swanepoeljan/TrueStep) the repo and started to add some of these features (on my local clone). While doing this I also completely changed the serial interface by adding TX and RX buffers and also change the package structure (made it smaller) and so far it works. Next I want to start cleaning up the rest of the code and if I find any issues try to fix them.
So my goals are a bit different but maybe it could still be beneficial to others using it in their printers.

So far I have not really fixed any bugs, just added custom features but will try to keep updating my repository with the latest changes.

kablek, 2020-09-27:
I see, quite nice. But I believe it would be better to do proper rewrite. By having said functions in mind stuff will run much better, be easier to maintain and add further functions. What do you think?

swanepoeljan, 2020-09-28:
A rewrite sounds like fun, but maybe before we go down that road it might be good to identify the problems with the current code. I agree the code structure is messy and all over the place but from what I have seen so far some of the techniques they used seems to be not so bad. It's just to avoid that our rewrite produces nice clean code but does not solve any of the real issues.

I also had a look at the [Mechaduino](https://github.com/jcchurch13/Mechaduino-Firmware/tree/master/Mechaduino/Mechaduino) code and I think they took a lot of the ideas (and code) from there. Maybe its also a good project to use as reference.

kablek, 2020-09-29:
Indeed, most of the problem seem to be related to step input code (seems like MCU is not reading input fast enough?) The drivers are also quite loud (PWM frequency? easy to set PID from LCD, maybe even pid auto tune?), There are problems with OLED display, etc...

Mechaduino code is much nicer looking, there are hardware similarities but I believe it is not the same.

swanepoeljan, 2020-09-29:
I wonder how many of the issues are due to bad soldering, as for some people it works well and for others not so much. The unit I received actually works pretty well (on the bench though), never had any OLED issues and seems smooth and quiet. Think I compiled and flashed the firmware from this repository a day or two after receiving the unit so maybe there are some differences between the stock version and the one on here...

Looks like they use timer1 to count the steps and have the STEP input set as the clock source so it should be very fast. Maybe there is some issues with the way they configured it (eg. mode1 vs mode2)... Before the STEP pulse even reaches the MCU is first passes through an opto-coupler so the signal should also be nice and clean... seeing the inductor I assume they have a switching regulator, maybe it's a possible noise source...
I have a function generator which I could hook up to the step pin to see at which frequency and duty it starts to fail, something I could try in the next days.

As for the PWM, seems that they use timer3 and if my math is correct it runs at 187.5kHz, which should be okay as far as audible noise goes. Maybe the PID is causing some oscillations...

PID auto tune would be nice!

Quas7, 2020-09-29:
PWM at 187.5kHz might explain, why the OLED communication gets confused.
The default setting ist 375kHz which is quite close to the first harmonic at 380kHz of the PWM signal.
https://github.com/bigtreetech/BIGTREETECH-S42B-V1.0/issues/16

AbeFM, 2020-10-02:
My board also came with the OLED seeming fine, after reflashing it seemed ok, but neither time was it on more than ten minutes.

I didn't see obvious bad solder joints, but I didn't look that hard. I am having issues programming it/STLink stuff.

I would be interested in helping with the code. I'm totally NOT a programmer, but with some support perhaps I could be of use?

Perhaps something just a bit higher level would be good for serial communications - these checksums and converting everything to hex, etc, could be done on the other end, just like Marlin.

I'd like to see PID autotune, I've fought it with car idle and all sorts of weird spots - it may be PID isn't the best approach for something with real delay like belt-driven masses, and some >1 kg prints will weigh the bed up to the point your settings may need to vary with bed mass (getting ahead of ourselves).

kablek, 2020-11-05:
alllll righty, took me some time due to other stuff (pretty much didn't touch printer for a while since last few days). I did some testing and researching, also looking at other S42B related repositories and forks. Great job on cleaning out the code and making it somewhat readable! Especially true step project! I have pretty much reverse engineered hardware out of software and some other data I could find and I have come to some conclusions/hypothesis:

PWM at 187.5kHz doesn't make much sense. Said PWM frequency comes from system clock (48MHz) divided by value of Auto reload register of STM MCU (which is set to 256). Thing is, from what I got from other data (haven't yet traced parts on actual PCB - so this still needs confirmation), PWM outputs are connected to motor drivers VREF pins, which set current through the coils, BUT it seems to use low pass filter on that connection. Some data from other repositories show values of 1kohm resistor and 100nF capacitor (which still needs confirmation from actual hardware) meaning we are having cutoff frequency of about 1,5kHz. ARR register value of 256 also means there is only 256 distinct pulse widths available, which is limiting factor in micro-stepping selection/accuracy. My proposal would be to raise ARR value to 1024 which would drop PWM frequency to 46.875kHz which I believe would still work fine or even better with filter, make far less EM noise and also increase micro-stepping performance.
Note that changing PWM frequency on MCU will NOT change PWM modulation frequency of motor driver. That is fixed to approx. 20-40kHz I believe (fixed off time off 25us according to datasheet)

OLED comunication is great example of bad coding! hard coded values everywhere, no control over timing and bit-banging what could have been done by hardware peripherals. Now there have been proposals for changing OLED clock speed which lead to mixed results - but I guess mostly efforts failed. I believe reason for that is, that OLED oscillator frequency doesn't do anything with data interface input sampling, even block diagram in OLED controllers datasheet shows internal oscillator only connected to graphics RAM and output drivers. It also would not make much sense with data clock at few MHz since internal OLED oscillator is about 250-550kHz. What I do feel might aid performance (but need to try it out first once again) is disabling change of D/C pin to high at the end of OLED_WR_Byte. after all, every time you write data in this case makes this pin go instantli high and back to low, which might write command byte instead of data making screen go BRRRRR (OFC - this is just my theory).

What I also found out is, there seems to be multiple versions of S42B board available, with differences as far as having different MCU, those seem to also have different pinouts MAKING THEM INCOMPATIBLE WITH THIS CODE!!!
And that is just another reason for proper rewrite making source code, that can run on all versions of S42B board (maybe even some other closed loop stepper boards in the future)

Quas7, 2020-11-05:
Somebody with more embedded coding skills and time than me might be able to track down the reason for this kind of rare SCLK glitches as they are likely throwing the OLED off track.
https://user-images.githubusercontent.com/1175755/97092636-cf376280-1645-11eb-8711-302a26f9cb0b.png

kablek, 2020-11-06:
I am also trying to address problem with SCLK glitches, there can be MANY reasons, speed limitations (pin or bus) code optimization settings etc. I am suggesting to also rewrite OLED code in the way, that clock is controlled by peripheral hardware based timer and interrupt driven. From what I see in the picture of logic analyzer it somehow seems like incomplete transfer? Maybe there is a problem with interrupt driven function doing something unexpected.

@Quas7 do you have more data about glitches? maybe even in a way to see whole waveform, not just screenshot?

Quas7, 2020-11-06:
@kablek for my setups the OLED corruptions are very rare and I did not manage to capture any glitch that actually resulted in a corruption. Even the SCLK glitches are too rare to get them just by brute force triggering.
I might take another shot at this by defining some timing dependent trigger on SCLK, e.g. triggering on deviations from normal risigin to rising edge spacing. But, I did not find this option for my analyzer yet.

But what do you mean with "whole waveform" - you mean an analog measurement with two channels for SCLK and DATA maybe?
Maybe this helps: [a longer logic analyzer trace showing the clock-generation timing issue for DATA-low I fixed with a few NOPs](https://user-images.githubusercontent.com/1175755/97092373-d65d7100-1643-11eb-94a4-5502042964c6.png)

kablek, 2020-11-06:
With whole waveform I mean one full transfer before and after the corrupted SCLK. It would be good idea to check if transfer before and after are correct.

I have started rewriting OLED code to use timer for clock generation and completely change the way it works. I currently don't have much equipment at home (I am in the middle of moving to another appartment so yeah) so I have to think stuff through pretty good. I might also try reducing PWM frequency, it is far from full rewrite still, but it is a start.
If it works I will upload code/binaries for you to test it out.

Quas7, 2020-11-06:
not sure, if we have to completely rewrite the SSD1306 communication as there is already the SPI LL module included?
https://documentation.help/STM32F0xx/
But I did not go down this rabidhole to check out, if this is possible in parallel to the SPI for the TLE angle sensor.

kablek, 2020-11-06:
Unfortunately, no. OLED is not connected to SPI capable pins... So we are stuck with bitbanging it. But, I completely rewrote it, now I am reviewing my code. If I manage to move my ass downstairs to printer, I might even test it out soon. I did use TIM15 timer to generate PWM which is clock signal. let me just see how it goes and I shall report.

kablek, 2020-11-07:
Small update and findings:
I have roughed in the concept for brand new code and wrote first version of it. Unfortunately it doesn't work (yet) and I currently have very limited set of debug tools. The idea behind my version of OLED code is to use PWM based output on SCLK pin (around 1MHz in current testing version) and trigger interrupt every time next bit has to be written and handle SPI protocol stuff.
Interrupts being triggered at 1MHz is a bit sketchy and fast for 48MHz MCU, but I sure can try it, maybe drop speed later on.

I might also try creating a system where screen updates only where needed and not whole screen all the time. This could allow me to drop SCLK speed or even make it dynamic, according to actual needs.  But first I need to make my version of driver working in baseline version.

As for PWM frequency it is a trade-off, I believe RC filter consists of values 1kOhm and 100nF (STILL UNCONFIRMED!!) which puts filter at ~1.5kHz. I did some calculations of what would happen if we drop PWM frequency, pretty much only thing that happens is that voltage ripple on VREF pin should increase. By dropping frequency we increase ripple, but increase resolution. double resolution -> double the ripple. Problem with increasing tau of filter network is that it increases time needed for voltage to reach desired level.
Acceptable level of ripple depends a lot on desired target current level (motors running on higher current should be less affected by the ripple, since ripple is fixed value. There probably is some room for improvement here, but I am still "brainstorming it".
I am first focusing on OLED performance and rewrite first, one step at the time. Next step is actually figuring out why step input pin is so slow (I suspect over done filtering on step input pin)

kablek, 2020-11-07:
We are making PROGRESS!
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
In the picture we are running completely new code for OLED screen, based on interrupts/timer15. OLED still does it's oled problems from before, but it is much more stable in my case. I have still more testing and improvement to do, I want to share and discuss some findings:
I am mostly working with 1MHz PWM output as SCLK. It seems our little OLED friend prefers longer setup times for pins (makes it quite more stable) but, dropping clock frequency lower (tried 500kHz SCLK and it was horrible) have adverse effects?

 Using my fresh code + jumper wires pretty much makes OLED stable, this suggests maybe we could benefit also by trying to shield screen from EM stuff? maybe some sheet metal, aluminum foil? maybe some extra decoupling caps?

I have also tried dropping motors PWM frequency by setting divider to 4, it didn't do much effect on OLED or motor movement.
I have absolutely no means of looking at waveform though, my cheap ass Chinese oscilloscope-ish thingy is in my tool bag that is on remote location and I have no logic analyzer anyway. I don't really have money to buy diagnostic tools.

This is the code I have so far, I will open actual repository once I get stuff going even more into the right direction:
[firmware-OLED_REWRITE_PRELIMINARY.zip](https://github.com/bigtreetech/BIGTREETECH-S42B-V1.0/files/5505353/firmware-OLED_REWRITE_PRELIMINARY.zip)

I would really appreciate some feedback, maybe measurements and diagnostics for comparison.

swanepoeljan, 2020-11-08:
@Quas7

> No, it is not as the hardware SPI2 is not availabe on this type of package (only on the 64pin package)

@kablek

> Unfortunately, no. OLED is not connected to SPI capable pins...

Are you guys sure about that? We have the STM32F030C8T6 (48 pin) which I think does have SPI2 possible on:
PB12 : NSS
PB13 : SCK
PB14 : MISO
PB15 : MOSI

The footnotes says "3. This feature is available on STM32F030x8 devices only." and "5. For STM32F030xC devices only." which to me means that we do in fact have it?

I think what happened here is that BTT made a mistake with routing the pins correctly and therefore they had to bitbang it in the end. They have it:
PB12 : CS
PB13 : DC
PB14 : D1 (SDIN)
PB15 : D0 (Clock)

So SPI2 SCK is routed to the display DC and SPI2 MOSI to the display clock and SPI2 MISO to the display SDIN which would obviously not work.

This means that if we use a cable between the header and the display (which seems to help anyway) then we could actually use hardware SPI2 and fix the routing to the pins on the display.

kablek, 2020-11-08:
@swanepoeljan you are in fact correct, they did connect it to SPI2 port pins, but they did it very wrong.

I am not sure however, why do cables help? Added inductance/capacitance? Better continuity? Since I rewrote whole oled interface and it does somewhat help, I am not really sure HW spi would make much difference. If two completely different codes show similar issues, I am starting to think it is something with hardware?
Oled driver version I created seems to work more stable, but it is interesting how adding jumper cables makes instant difference (as far to make it 100 percent stable with my version, no artefacts even with enabled motors).

Original code is just horrible. Now I have found what I'm pretty sure is overflow in current regulation code.

Also a question I have, once motor moves/gets enabled, you can't enter menu. Is this normal behaviour?

swanepoeljan, 2020-11-08:
The cable helping a lot is interesting, Till once mentioned he thinks it could be the additional inductance that helps. But maybe like you mentioned we could also add some decoupling caps or add some shielding material inbetween the board and display to see if that helps. Maybe even just a series resistor to dampen the signal slightly...

Maybe you are already aware of it but one thing that caught me while doing heavy code modification was that we only really have the first 31kB of flash available. The next page is used for parameter storage and then the following 32kB used for the calibration table. As I approached the 31kB limit I often started to get strange behaviour as the parameters could override program code.

> Also a question I have, once motor moves/gets enabled, you can't enter menu. Is this normal behaviour?

That's strange, I can definitely enter the menu while it's running.

kablek, 2020-11-08:
Is that actually the case with code overwriting parameters? That seems like a really bad programing then....

I will do some testing, trying to get oled stable without cable from hardware standpoint. I did as much as I could, you can also take a look at my version of OLED code, it is compatible with your fork of the code (TrueStep), just remove initialization stuff from main.c file and replace oled.c/.h

swanepoeljan, 2020-11-08:
> Is that actually the case with code overwriting parameters? That seems like a really bad programing then...

Jip, the first sign is normally that after flashing it want's to run the calibration again as the calibration flag gets overridden by program code. Personally I would have used the 1st or last flash memory page for parameter storage to prevent these kind of problems.

> Edit: Well, did some abuse on OLED module, no luck. I will focus on rewriting other code... MAYBE rewriting everything else could stabilize OLED?

Was also thinking that maybe something else is causing it, like maybe an interrupt at some critical stage. The strange thing is that some other guys on here have some drivers which does not even last 10 seconds and others that run fine. So most likely we can only do so much from a software perspective and the rest would need to be hardware fixes/hacks.

"Unfortunately" I am one of the lucky guys and my driver works perfect (with any firmware). Have never had the OLED issue so it's hard for me to debug this issue.

kablek, 2020-11-09:
Well... In that case it really calls for complete rewrite... I am probably going to modify OLED code to also support HW SPI with asumption people use wires to fix the pinout. I believe tho we first require rewrite of other things. There is just too much wrong with original code, and it is really badly written. There are some good concepts in the code, but execution is terrible.

I believe it would be in our best interest to join "our forces" and start rewritting as much as we can.

Another thing I found is, that in function "Output" that sets PWM outputs, there is potential for effort values above 32 to overfloow? I have proposed solution but I haven't yet tested anything. Also I don't understand the use of float for phase multiplier, wouldn't it just be better to multiply by 25 and then divide by 2 for 12.5 phase multiplier? I still have to test said fixes.

But I suggest scrapping most of original code. I think it is not really worth fixing in the shape it is.

swanepoeljan, 2020-11-09:
> I believe it would be in our best interest to join "our forces" and start rewritting as much as we can.

Sounds good, I think we have some good people on here, each with their own set of skills making very positive contributions (in both software and hardware). Like you said, would be nice at some point to combine all this into a brand new project. Maybe even with support for different boards using a Configuration header file (like Marlin for example) to enable/disable features you want, depending on your hardware.

> Another thing I found is, that in function "Output" that sets PWM outputs, there is potential for effort values above 32 to overfloow?

You mean due to the order in which it is evaluated? it would be better to write:
`v_coil_A = effort * (sin_coil_A / 1024);`

instead of:
`v_coil_A = effort * sin_coil_A / 1024;`

The interesting thing is that some time ago I did measure the voltage on one of the VRef pins with effort value of 80 which gave an output very close to 1V which suggests that it works. If I have to take a guess, I think due to the 1024 constant all variables are promoted to 32bit integers which makes it work. Or do you see some other issue there?

> Also I don't understand the use of float for phase multiplier, wouldn't it just be better to multiply by 25 and then divide by 2 for 12.5 phase multiplier?

This one is also unclear to me, why it's even there in the first place...

> EDIT: Expect new version of OLED code today (in aprox. 5-6 hours from now) in my fork of the repo, compatible with TrueStep fork. I have commited changes but forgot to push them.

Nice, thanks! Will give it a try.

kablek, 2020-11-09:
Well I don't know what exactly is going on there. Promoting variable to 32bit might be the case, but it doesn't make much sense with all other being 16bit integer value. As for the order of evaluation goes:
`v_coil_A = effort * (sin_coil_A / 1024);`
Is a bad idea, because sin value being divided first would resoult it being 1 or 0 depending on rounding operation. But this makes me wonder, what did you measure VRef with? oscilloscope or meter? was it actuall sine wave representation of motor phase or was it square wave of 1V? if it is square wave of 1V, then it might be the case of program actually doing division first and then multiplication (Compiler optimizations work in misterious ways). We do want multiplication first, but we don't want number to overflow.
I will se if there is option to look at code disassembly and compare it to original source.

About phase multiplier I am also pretty clueless, it probably has to do with different formats of angle being written? but with code being written in ugly way it is, this will be hard to figure out. It should definitely be faster to multiply and divide with whole numbers than to just multiply with floats

Another note to my OLED code: the fact it is interrupt driven, making it non blocking makes key press detection much faster, double clicks are detected since there is no debounce/delay.

swanepoeljan, 2020-11-09:
Ah ja true, I didn't think that one through properly, we definitely want to start from the left.

For the measurement I just used my meter but can redo it with my scope to get a better picture.

> Another note to my OLED code: the fact it is interrupt driven, making it non blocking makes key press detection much faster, double clicks are detected since there is no debounce/delay.

Had a similar thing when I rewrote the OLED menu, they use delays in the original code to do the debouncing which I didn't like and it slowed the main loop down a lot. In the end I used the SysTick timer to scan for key presses at a lower rate which works okay.

kablek, 2020-11-09:
Alright, I finally did push new version of OLED code to my fork. I cleaned it up quite a bit and did some planning for further changes to OLED driver code. I believe code should work fine for now and should be stable enough for use. In the future I will add support for hardware SPI over fixed pinout, but that is currently not top priority.

Button handling could also be handled by interrupts I believe, but that does coma at a price of potentially slowing things down due to interrupt calls. Buttons are also not top priority IMO since their implementation is not really difficult. I believe area to focus on first is getting all important interfaces working correctly, if possible without anything happening in main loop?
I will probably look at code for magnetic encoder and bridge control (TIM3 PWM) next.

I would be very happy of comparison between original code waveform and my new version of code waveform, so if you are willing to test it out I would be quite happy.

kablek, 2020-11-09:
I believe I figured out where 12.5 phase multiplier might come from:
1 full rotation of the motor is 360°
1 full step is 1.8°
360/1.8= 200 -> represents number of steps in one full rotation

1/32 step mode sets stepangle variable to value of 2.

Then we have this piece of code:
```
s = LL_TIM_GetCounter(TIM1);
        if(s - s_1 < -32768)
          s_sum += stepangle * 65536;
        else if(s - s_1 > 32768)
          s_sum -= stepangle * 65536;

        r = s_sum + stepangle * s;
        s_1 = s;

        if(r == r_1)
        {
          hccount++;
          if(hccount>=1000)   //Delay to decrese current when stationary (after 1000 cycles idle it drops current to half)
            hccount=1000;
        }
        else
          hccount=0;

        if(hccount >= 1000)
          Output(r,UMAXOP/2);
        else
          Output(r,UMAXOP);
        r_1 = r;
```
Now, hccount is simply for current reduction after some time on idle and has nothing to do with angle.
r is what is passed forward to Output function to be then multiplied with 12.5.
r_1 is simply previous value of output angle and it is used for delay management together with hccount, so it doesn't do anything with angle calculation.
s is data from the TIM1 or counter that is counting step pulses, It seems like value saved in TIM1 register is not getting clear, and acts like absolute steps in some direction counter.
s_1 is just previous value of s
s_sum is I believe used for some averaging function? maybe overflow detection? I have no clue but we can assume it could be value of zero before if increase/decrease it. That means we can put it away.

that would simplify code to:
```
s = LL_TIM_GetCounter(TIM1);
r = stepangle * s;
Output(r,UMAXOP);
```
Now if on TIM1 pin we need 32 pulses (which get later multiplied by 2) for 1 step and 200 steps for one full rotation:
64 * 200 =12800 -> number of 1/64 usteps in one full rotation, this number divided with 12.5 results in 1024, which is very suspiciously 1024, which is quite a nice number considering 1024*4=4096 which is number of elements in the sine table? now this last bit kind of confuses me, but I guess reason is for steps from step input to be scaled to theta table.

swanepoeljan, 2020-11-10:
Could be that you are on to something here...

Last time I tried to figure it out I was looking at the OneStep() function. This one is used during the calibration and should move 1.8° per step. Here they used:

`Output(81.92f*stepnumber,80);`

When applying the 12.5 multiplier we get 12.5 * 81.82 = 1024 which kind of makes sense since for full steps we would read the sine table in 90° (1024) intervals. What throughs me off though is if that is the case then why when we use 1/2 steps (stepangle = 32) and make 2 steps we pass 64 to the same Output() function and also expect to move 1.8°?

Quas7, 2020-11-11:
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

For the OLED, it is maybe more robust to switch to a bitbanging I2C implementation instead of the 2-wire SPI. The bandwidth is not required for any animation/graphics. And the register-shifting used in SPI might be the root-cause as a too fast clock edge cycle (faster than in my captured glitch) propably kicks the display out of sync.

kablek, 2020-11-11:
Well it might be worth a try with I2C, that does require slight hardware modification of OLED board. However, I think it would be even worse with I2C, since it is much more subject to glitches from my experience. It might be worth a try to lower GPIO speed
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

Thread 18 (2020-09-30):

The Y-axis is stuttering and acts sometimes like a guillotine

copperfield74, 2020-09-30:
Hi everybody, today I was able to implement the S42B on my Artillery Sidewinder X1 Y-axis.
I followed the steps that were shown on YT by Teaching Tech.
I put  switch 4 on and did the calibartion. After that I entered the microsteps (16) and also entered the mAh (1700).
But the first test wasn't successful because the hotbed only moved stutteringly and not fluently. Also I'm not able to move the bed all the way to the front. I thought that maybe the voltage isn't high enough so I raised it to 2100. But still the same problems. Also the Y motor is somehow "humming" as if it's somehow working once it moved. Sometimes when I've shutoff the motors, turn them back on and home Y it's flying like a guillotine. If I had my thumb between the plate and the camera mount it might have cut it off (or at least hurt me). See a video here:
https://youtu.be/W5ACd9wWcLg

I've calibrated it once again but still the same problem. I would say that the magnet it quite in the middle of the motor and the distance to the pcb is also okay because of the spacers that were delivered. I hope to get some help asap so that I can go on with printing.
PS: when Closed Loop is off (dipswitch 3) it moves fluently. My firmware is Marlin 1.1.9

AbeFM, 2020-10-02:
I believe this is an issue with not having the PID values tuned for your printer. What happens is the motor turns to position, the bed hasn't QUITE gotten there yet. The motor stops but the bed goes past, pulls the motor PAST the position, so the motor starts pulling the other way, and if there's a match between PID values and the response time of your bed, you'll get rocking. Mine was about ready to knock the printer over, shaking violently till I damped the oscillations with my hand.

I suspect the loop needs to be slowed down for massive loads, but I'm still trying to get reliable programming so I've yet to mess with it.

(watched video) I'm not sure why it's unevenly traveling, but I suspect that's what it is. Tightening belt will help a little, but it's not the RIGHT answer, and will wear belt.

copperfield74, 2020-10-02:
Hi AbeFM, thanks for your response.
I thought nobody was here anymore! ;-)
I've already changed the PID settings to see what happens. It got better, but I'm honest....I didn't know what I was doing! :-)
I couldn't find any good resource or tutorial describing PID! I don't even know what the values should do. It now moves a bit more fluent but it sounds as  if it was grinding. I changed the values to:
P:30
I:10
D: 300
But I don't know which value is the right one concerning my special problem. And it's a pain in the a** that I have to disassemble the S42B from the motor to connect it to my Laptop everytime to see if the changes are good or bad.
If PID is so important why is there no real documentation? Or more easy way to dial it in without the hassle of unmounting it every time. If I would get it to work I would buy a few more for my other printers but right now I'm sad that there is no help from BTT to solve these problems.

nhabes79, 2020-10-02:
I suggest changing the I value to 1. It wasn't even worth it to me to do any PID tuning until the I value was fixed. 10 is way to high. Also, make sure A4988 is the motor driver chosen in your firmware. I had some issues if any other motor driver was chosen in my firmware.

copperfield74, 2020-10-02:
>
>
> I suggest changing the I value to 1. It wasn't even worth it to me to do any PID tuning until the I value was fixed. 10 is way to high. Also, make sure A4988 is the motor driver chosen in your firmware. I had some issues if any other motor driver was chosen in my firmware.

Thanks for your reply! What do the different values stand for? What happens when I is changed. It would be great to understand what is happening. Has it to do with acceleration? Or what does the I stand for, or the P or the D! And yes I did change the driver to A4988 in the firmware. Please let me be your padawan...teach me please! :-)

Quas7, 2020-10-03:
I would recommend you select TB6600 as stepper drivers for S42B in Marlin. Even A4988 is still a too fast communication for the S42B.
This change does not have a really big impact as long as you do not plan to go >500mm/s travel on 32usteps with 32bit controller boards.

copperfield74, 2020-10-04:
>
>
> I suggest changing the I value to 1. It wasn't even worth it to me to do any PID tuning until the I value was fixed. 10 is way to high. Also, make sure A4988 is the motor driver chosen in your firmware. I had some issues if any other motor driver was chosen in my firmware.

I've tried to go as low as I=1 but after that the Y axis didn't move anymore. I've changed it to 5 and now it's working again. It's not perfect but much better then before.

copperfield74, 2020-10-04:
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

I still have my stock MKS Gen L V1.0 board in my printer so no 32bit board. Maybe I'll give it a try and change to TB6600.
Thanks for the hint.

megatech1966, 2020-11-10:
> TB6600.

Did you have any luck fixing your problem. I think I have the same problem. I’m waiting for my st-link to arrive so I can update the firmware and change the pid values.

Thread 19 (2020-10-05):

Info: not all NEMA17 motors are compatible

Quas7, 2020-10-05:
After playing around with 5 different NEMA17 and 3 hybrid stepper DIY boards I figured that not all motors are "magnetically compatible" with the concept.

I did not bother reading out the field values with a hall probe or similar but just compared working setups with non-working ones by using "magnetic view foild".

The difference I observed is a change in sharpness of the N/S boarder (center) as well as the outer shape of the magnetic contour while rotating the shaft for the same airgap (no magnet tilt etc.).
Seems, like the motor casing is magnetic or the permanent magnets from the inside of the motor interfere somehow.

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

I have no direct proof but after seeing this I just added spacers between the motor shaft and the magent and additional spacers on the mounting screws. This got one of three previoulsy non-working setups working.

Therefore, if the S42B is not working for you maybe just try exchanging the NEMA17.
For me it was a 50:50 chance up to now with smaller motors (e.g 4047) working generally better than large ones.

Could, of course, have various different reasons but I just wanted to share in case someone made a similar observation.

raimis170, 2020-10-06:
what was your problem before ? did fix it?

Quas7, 2020-10-06:
for certain motors I did not get any movment. They were freewheeling till some magic lock-position and step commands showed angle deviation running up but no movment. Other motors showed movment but vibrated at certain angles quite heavily.

The spacers or a second axially magnetized magnet (reduces B field) did not fix all of them but for one it worked afterwards. It looks like it is not always a PID parameter issue but might also be an encoder or better a magnetic signal quality issue.

Others would have to test as well, if additional spacers below the encoder magnet get some combinations working.

Quas7, 2020-10-17:
not suprising but it looks like the spacer needs to be non-magnetic, e.g. 3D printed, and the magnet should at least be 50% outside of the motor housing.
With this improvment I got all motors to work that I tried so far (3 pcs).
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

MetalBeard72, 2020-10-24:
"For me it was a 50:50 chance up to now with **smaller motors (e.g 4047)** working generally better than large ones."

Forgive my ignorance. What does 4047 refer to? Physical size of the motor? Does higher amperage matter?

Quas7, 2020-10-24:
C4047 and similar are nema17 codings for common motors (https://reprap.org/wiki/NEMA_17_Stepper_motor)
For me this translates to 40 mm motor length.

Quas7, 2020-10-29:
I tested now a few more nema17 and found a totally incompatible one even with the magnet completely outside the shaft cavity. It does not move at all in close loop.

The main difference to the other motots seems to be a thinner aluminum backcover and a ball bearing close to the backside.
Magnets stick to the ball bearing though the backcover. This might be a first indication for compatibility.

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

MetalBeard72, 2020-10-29:
Hey, that looks promising.

MetalBeard72, 2020-10-30:
I switched to a motor that passed the magnet test and it worked! On another note, I think I fried one of my boards. It no longer powers up. (Unrelated to this post)

Brian-Zombait, 2020-11-08:
> The main difference to the other motots seems to be a thinner aluminum backcover and a ball bearing close to the backside.
> Magnets stick to the ball bearing though the backcover. This might be a first indication for compatibility.
>

Okay, so more spacers for the board and insert a non magnetic spacer between the shaft and magnet. That means longer screws, too.

Good thing I used only a whisp of gel super glue. Should be able to pry it off.

IhorNehrutsa, 2020-11-11:
Thank you, Till Quas7.
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
Calibrated well after the proper direction of the motor rotation (Issue #33).
I see your Pull requests.
May you change the firmware to see degrees during the calibration process?

Quas7, 2020-11-11:
I am quite sure, that the "calibration" process does not actually result in anything close to absoulte degrees. It can only be a relative degrees given by the motor precision of something like 1.8° +/-5%.
This also means, that before and during calibration the sensor has no clue what the actual angle is, as it is only referencing every new full step (+1.8°) to the readout of magnetic field of the sensor.

But, what should be doable is to output the number of steps already done and total steps needed like a progress indication.
Also, one could do a verification run after calibration as the MKS servo42b does.

Q5Grafx, 2020-11-29:
I tried your solution by doing this. i needed a 5mm x 2mm spacer for the magnet. i found plastic spacers at granger but only had minimal contact on the magnet and shaft because of the 3.2mm hole in the center. then i typed into a search 5mm discs. which brought me to etsy i ordered 5mm x 3mm stainless beads which have a 1mm hole and a different option of 5mm copper stamp cuts. i went with the copper. i had to use 4 layers. for centering i have 8mm od with a 5mm id spacer and use more magnets as a handle. what i noticed is the copper offset the magnetic field and other magnets would not line up with it on center anymore. But its due to magnetic flux from the copper and actually helped. for standoffs i went to grainger and found 6mm m3 spacers and they fit inside the countersinks on the motor and give the perfect distance of about 3mm from magnet to sensor. after that the setup was effortless and had no problems with it. Now all i need is an easy way to set the PID for tuning because i hate seriel port communication. but the system is functioning however i cant see where they get their step counts. a 8 microstep it says 2048 pulses but on my cnc its only 512 but then its as accurate as i have the capability to measure. i decided to use the 16 step and bumper the setting to 1024 and my pins are 1 on 2 off 3 on 4 off and its accurate 10cm = 10 cm.

Thread 21 (2020-10-06):

Step problem

DJDOUBLEG, 2020-10-06:
Sometimes the number of steps is more than the set value.
Why can this be?
This occurs when the printer has not been used for a long time but has been turned on (approximately 30 minutes).

Quas7, 2020-10-08:
you can try and check what is discussed in https://github.com/bigtreetech/BIGTREETECH-S42B-V1.0/issues/13

Thread 22 (2020-10-07):

Change of Filament (Homing) not working

copperfield74, 2020-10-07:
I'm using a Sidewinder X1 and Repetier Server!
Before installing the S42B there was no problem to change the filament during a print.
When I hit PAUSE the nozzle would raise 5mm and X/Y would home! Then I could change the filament, hit CONTINUE and the print would continue where it stopped. Normal behaviour!
WITH the S42B I've tested it maybe 12 times in the beginning of a print and it worked like I was used to, BUT everytime I had to do it during a longer print, the beaviour was like this:
PAUSE: Nozzle raises, X and Y are homing! Perfect.
CONTINUE: X goes to the right position but Y (S42B) fasts completely forward so that the print can't be continued.
I think that I'll get rid of the S42B when this project is done. In my case it's not reliable enough and has killed 3x 30h prints with that problem. I now have to buy 4.5kg spools so I can print 3 parts without having to change filament.

Quas7, 2020-10-08:
You could also try a filament fuser block. But I never tried this - sticking to 3.5kg (where do you get 4.5kg spools?!)

swanepoeljan, 2020-10-08:
Do the time you take to change the filament make any difference? For example, when it's in PAUSE mode for a short time (few seconds) it works but if it's paused for a longer time (more than a minute) then it doesn't work?

The times that it fails, could you notice the OLED maybe restarting?
Just thinking if the S42B restarts for some reason (watchdog, hard fault, etc.) and then forgets its last position...

When in PAUSE mode, are the motors enabled?

Quas7, 2020-10-08:
Also, there is a discussion on max step frequency and pulse width as it seems not all boards behave identical.
https://github.com/bigtreetech/BIGTREETECH-S42B-V1.0/issues/13

You can join and test with increased pulse width and see, if this corrects your error.
Here a proposal, what you could try out before discontinuing:

Configuration_adv.h:
/**
 * Minimum stepper driver pulse width (in µs)
 *   0 : Smallest possible width the MCU can produce, compatible with TMC2xxx drivers
 *   0 : Minimum 500ns for LV8729, adjusted in stepper.h
 *   1 : Minimum for A4988 and A5984 stepper drivers
 *   2 : Minimum for DRV8825 stepper drivers
 *   3 : Minimum for TB6600 stepper drivers
 *  30 : Minimum for TB6560 stepper drivers
 *
 * Override the default value based on the driver type set in Configuration.h.
 */
**#define MINIMUM_STEPPER_PULSE 10**  // 10us long step-pulse (7 was experimentally the lowest for in one test for one board)

It might also be, that your direction signal is decoded fast enough and it runs off in the opposite direction.

/**
 * Minimum delay before and after setting the stepper DIR (in ns)
 *     0 : No delay (Expect at least 10µS since one Stepper ISR must transpire)
 *    20 : Minimum for TMC2xxx drivers
 *   200 : Minimum for A4988 drivers
 *   400 : Minimum for A5984 drivers
 *   500 : Minimum for LV8729 drivers (guess, no info in datasheet)
 *   650 : Minimum for DRV8825 drivers
 *  1500 : Minimum for TB6600 drivers (guess, no info in datasheet)
 * 15000 : Minimum for TB6560 drivers (guess, no info in datasheet)
 *
 * Override the default value based on the driver type set in Configuration.h.
 */
#define MINIMUM_STEPPER_POST_DIR_DELAY 10000 // I assume, this means "wait 10us before sending steps"
#define MINIMUM_STEPPER_PRE_DIR_DELAY 10000 // I assume, this means "wait 10us after last step to send direction change"

And, of course, the max freq. has to be limited as well
/**
 * Maximum stepping rate (in Hz) the stepper driver allows
 *  If undefined, defaults to 1MHz / (2 * MINIMUM_STEPPER_PULSE)
 *  5000000 : Maximum for TMC2xxx stepper drivers
 *  1000000 : Maximum for LV8729 stepper driver
 *  500000  : Maximum for A4988 stepper driver
 *  250000  : Maximum for DRV8825 stepper driver
 *  150000  : Maximum for TB6600 stepper driver
 *   15000  : Maximum for TB6560 stepper driver
 *
 * Override the default value based on the driver type set in Configuration.h.
 */
#define MAXIMUM_STEPPER_RATE 150000  // how many steps/s max.

copperfield74, 2020-10-08:
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

That's a very good question!
The successful tries were all done in a short period of time. The real chnage of filament took obviously more time. I'll check next time.
If I'm not mistaken the motors should stay enabled during PAUSE.

copperfield74, 2020-10-08:
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

Qua7, it seems that you are really digged deep into this topic. I'll take a look if anything helps with my problems. Most of the time the motor is "humming" when I move it forward and it seems as if it's working against something so that it doesn't shut off and gets quiet. Never thought that it would be this hard to get it to work correctly. :-(

copperfield74, 2020-10-09:
>
>
> You could also try a filament fuser block. But I never tried this - sticking to 3.5kg (where do you get 4.5kg spools?!)

I got my 4.5Kg Filament from Material4Print they also have 8Kg spools but that would have been overkill. ;-)

Quas7, 2020-10-09:
You could try one more thing to check, if this is related to this issue https://github.com/bigtreetech/BIGTREETECH-S42B-V1.0/issues/3

1. Move everything to the center of your print area
2. send the printer the following commands:

G28 ; home all axis
G1 X30 Y30 Z30 ; All move 30mm
M18 ; (or M84) disable steppers
G4 S2 ; wait 2 seconds
M17 ; enable steppers again

If the Y-axis jumps to the center after this you have a board with the older firmware as I did.
Reflashing with the binary mentioned in the issue #3 solves this.

copperfield74, 2020-10-10:
> G1 X30 Y30 Z30

I did what you told me to do and you were right. It jumps back to the center of the printer.
So the first thing next time should be to update the firmware. I've already bought a STLink to do that.

Thread 23 (2020-10-10):

TMC CONNECTION ERROR

davidcgu, 2020-10-10:
Good night guys,

I just tried to install this on E axis while originally I had working an TMC2209 on UART with no issue.

I'm able to power up and complete calibration succesfully however I'm getting TMC connection error.

I'm I send M122 from pronter I see that issue is coming from this slot, E0.  If I move back and install again the TMC communicatoin error is gone.

I have no clue on how to solve it do you have some idea?

From other side, I see a 4 dip switch onboard and have no clue what is the purpose of this, I can find out anything about it on manual, do you have some document where is explained the purpose of those switches?

Thanks in advance

davidcgu, 2020-10-10:
trying to find the way to delete the post, any info regarding the funcion of the 4 position dip switch?

Thanks in advance

Quas7, 2020-10-11:
did you already do te steps in the manual?

dip 4 is write protection of calibration data.
dip 3 is closed loop vs open loop mode.
dip 1,2 set microstep resolution.

set 4 to off and select your preferred microsteps with 1,2.
Them run calibration without any load on the motor (detach belt).

Also A4988 is not the right setting in Marlin. Chosing TB6600 is more  appropriate for the signal timings.

davidcgu, 2020-10-11:
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

Thanks for your reply,

I read all PDF and I think I have not seen any clear steps to follow... what steps are you speaking about?

My actual marlin config changes are:

#define E0_DRIVER_TYPE A5984
#define INVERT_E0_DIR true
#define MAXIMUM_STEPPER_RATE 150000
#define MINIMUM_STEPPER_PULSE 3

Calibration process is completed succesfully as mentioned previosuly, on open loops i turns fine is when moving to close loop when I facing the problem, I could try to change to TB6600 but not sure if this will change anything,,,,

From other side, should I insert jumpers on the board to select the microstepping mode?

Regards

swanepoeljan, 2020-10-11:
Sounds like it could be an issue with the magnet installation, and that the distance between the magnet and the sensor needs some adjustment. Maybe experiment with adding/removing some of the small spacers. Think the manual said the sweet spot is somewhere between 2mm and 4mm.

Quas7, 2020-10-17:
@davidcgu you could take a look at #19 as this solved it for me for all stepper motors I tried.

Brian-Zombait, 2020-11-08:
> @davidcgu you could take a look at #19 as this solved it for me for all stepper motors I tried.
>

I am experiencing the same problem as the OP. My machine is an Anycubic Mega S.

I've already updated the settings in the motherboard firmware to reflect the pulse min 3, and the max rate to 150,00. The default driver on the board is A4988. Also, motherboard firmware has been updated to the latest version of Merlin using the Anycubic Mega file set from their website to ensure its set up properly for my machine. Note - it works fine without the S42B controllers.

On addition, I have tested the values, via the oled, of the micro steps from 16 firm to 4 with no change in closed-loop mode. Again, open-loop mode works fine.

I have not attempted to change PID values, and have no experience doing so. All firmware changes and updates have been done via Visual Studio.

The distance between the magnet and sensor is 2.62mm, based on my measurements with my trusty calipers.

Any help with this would be appreciated, as my whole reason for getting the S42B controllers was for the closed-loop function.

[My motherboard is an ANYCUBIC TriGorilla Integrated Main Board Compatible Mega2560 & RAMPS1.4 Combo Control Board 4 Layers PCB Controller Board for RepRap Mendel Prusa I3.](https://www.amazon.com/dp/B079GRJH6V/ref=cm_sw_r_cp_apa_fabc_SqaQFb8Z1X3H7?_encoding=UTF8&psc=1)

Thread 24 (2020-10-21):

Calibration Runs / Motors Won't Move

MetalBeard72, 2020-10-21:
I am using the Kit... Should have just bought it already assembled. I would return it and exchange if it weren't shipping from China. (delay).

I have read through the other threads:
1-Changed spacing of board to magnet both ways
2-Changed Marlin:
    a- #defineMINIMUM_STEPPER_PULSE 7
    b- #defineMAXIMUM_STEPPER_RATE 150000
    c- commented out x and y driver designations
3-Stripped everything down to just one motor and a bare SKR V1.4 Turbo at 12v
4-Calibration runs successfully
5-Switch pot 4 on dipswitch to off
6-Motor does not turn in open or closed loop modes
    a-Vibrates but does not move
    b-Red light comes on with "Err: 035.99"

I'm not sure what else to try. How sensitive is it to the magnet being perfectly center? If it is super sensitive, how do you get it centered perfectly? I have superglue all over my fingers and a big frowny face.

Quas7, 2020-10-21:
normally, constant red light means too close or too far away from the magnet. Also, if the magnet is deep inside a cavity for some NEMA17 motors, it gets issues.
Can you post a sideview photo of your assembly?

What bothers me is, that you have no movment in open-loop (dip-switch 3). Because it does not care for the magnet at all in this mode.
Are you sure, the motor is wired correctly with its phases? Is it moving 1.8deg per step during calibration or does it sound a bit non-constant?

MetalBeard72, 2020-10-21:
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
I will try a spacer under the magnet. As far the wiring. Pretty standard stuff. These have been running on a printer with an SKR v1.4 Turbo and TMC2209 drivers for some time. I will  double check though. Movement during calibration looks pretty consistent.

MetalBeard72, 2020-10-21:
It was wiring. I put a spacer on the magnet as well.

Quas7, 2020-10-22:
In my experience the centering of the magnet is less important than the flatness or parallelism to the encoder chip (no runout of the airgap).
If you run in open-loop, do you see any wobbling of the magnet in Z (airgap) or XY (top view on magnet). You can take the board off for checking that, I think.

MetalBeard72, 2020-10-23:
Looks level. I re-did the magnets justvto make sure. Is there a US source yet? I teallyvwant to return these and just get the assembled version. What motors are recommended?

MetalBeard72, 2020-10-23:
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
looks a little off. I have fiddled with this for 5 days. Getting the magnet level and centered seems beyond my capabilities. Regardless. It still only returns a 35.99 error.

Quas7, 2020-10-23:
And you did try already 4mm or higher as distance with more spacers as this looks like only 2 to 3mm?
If you need more spacers, I personaly only use one diagonal for mounting (2 screws) instead of overconstraining with 4 mounting screws.
Also, opening 4 screws of the nema17 at once theoretically can increase tolerances, e.g. step error.

MetalBeard72, 2020-10-23:
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
I added more space, changed the screws to just 2 corners.
No luck.

Quas7, 2020-10-24:
That is really strange. Last try would be using a different motor.
But it is a 1.8deg motor, right?

MetalBeard72, 2020-10-24:
Yes. https://images.app.goo.gl/9hRqTCS8wh2aHETv8

MetalBeard72, 2020-10-24:
I even tried one more spacer.

MetalBeard72, 2020-10-24:
Are there any US retailers yet?

swanepoeljan, 2020-10-24:
A quote from the [Nano Zero Stepper](https://github.com/Misfittech/nano_stepper) manual:

"_The magnet will be glued to the back of the stepper motor on the shaft, it is recommended for the
maximum accuracy that a nylon washer be glued between the stepper motor and magnet.
The nylon washer between the motor shaft and the magnet reduces the magnetic loss through the
motor shaft, thus increasing the magnetic field for the encoder to read. The magnet shipped with the
NZS is a “strong” magnet and will work without using the nylon washer between motor and magnet but
the increased magnetic field with nylon washer is better for encoder._"

Maybe it's also something to try...

Quas7, 2020-10-24:
hehe, exactly. I have 2x nylon washers as magnet spacers.
I also tried using a second magnet from another set but that was the worst perfromance ever as it short circuits the magnet (needed to be almost touching to get calibration)

MetalBeard72, 2020-10-25:
I asked for an exchange

MetalBeard72, 2020-10-30:
I switched to another motor and it works. Quas7 suggested a magnet test in Issue19. Worked for me. I managed to fry one of my boards though. It no longer powers up.

tiagomaricate, 2020-11-03:
I'm having the same problem.
So basically is related to the distance from the magnet?
I also had to switch the order of the wires.
ON motor is A-B-C-D and on the board is B-A-D-C.

Quas7, 2020-11-03:
@tiagomaricate it can be the magnet distance to the board IC (2-4mm) or the magnetic surrounding of the magnet (ferromagnetic bearing right next to the shaft backside). It might help to add non-magnetic (plastic) spacers below the magnet but it has to stay somewhat centered and level! See also #19.
Note, that AB CD and BA DC is the same - no need to change anything besides maybe the rotation direction in the S42B menu.
What you might have got is a cross-wired motor with AC BD (Board AB CD) that would rotate erratic with no constant movement and uneven torque in open-loop or during calibration.

tiagomaricate, 2020-11-03:
> @tiagomaricate it can be the magnet distance to the board IC (2-4mm) or the magnetic surrounding of the magnet (ferromagnetic bearing right next to the shaft backside). It might help to add non-magnetic (plastic) spacers below the magnet but it has to stay somewhat centered and level! See also #19.
> Note, that AB CD and BA DC is the same - no need to change anything besides maybe the rotation direction in the S42B menu.
> What you might have got is a cross-wired motor with AC BD (Board AB CD) that would rotate erratically with no constant movement and uneven torque in open-loop or during calibration.

Got it!
I will remount the magnet and recheck the distance.
I back with the results.

tiagomaricate, 2020-11-03:
> @tiagomaricate it can be the magnet distance to the board IC (2-4mm) or the magnetic surrounding of the magnet (ferromagnetic bearing right next to the shaft backside). It might help to add non-magnetic (plastic) spacers below the magnet but it has to stay somewhat centered and level! See also #19.
> Note, that AB CD and BA DC is the same - no need to change anything besides maybe the rotation direction in the S42B menu.
> What you might have got is a cross-wired motor with AC BD (Board AB CD) that would rotate erratic with no constant movement and uneven torque in open-loop or during calibration.

I just replace the magnet now closer to the sensor.
Tested trying to rotate the axis through the TFT screen.
The motor just rotates once and a little step.
After that, it becomes unresponsible.

Brian-Zombait, 2020-11-08:
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

Okay, so the board motor pinout is (AB) (CD). Now, I just have to do an ohm check on my motors. Been trying to get this working, too, with similar issues.

Machine is an Anycubic Mega S.
Have updated firmware and set stepper maximum speed to 150,000, and stepper minimum pulse to 3.

Stepper moves on one direction in a stutter step throughout the calibration process. It juggled in place before the above mentioned firmware changes.

Trying to move it using the onboard axis controls causes the red LED to come on and the motor to lock in place. This was true before and after the firmware changes.

Hoping to find that the harness isn't wired for my motor as that would be a very simple fix.

tiagomaricate, 2020-11-08:
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

Well, I tested with another motor and the wire order worked with ABCD -> ACBD.
Basically inverting the two wires on the middle.
The first motor had metal cover. The second, plastic. Not sure if this is related.
I’m replacing the motors for a new one of the same model worked.

dzid26, 2021-01-19:
My magnet is 0.3mm from the sensor and it works fine,
The key is to arrange phases as BTT "intended".

If calibration does "uneven" steps, swap wires 1&3.
If calibration seems to step rotate OK, but close loop doesn't work after restart, change rotation direction by swappping 1&2 .

jlmxyz, 2021-04-01:
Hi,
I've the same problem here
what I've done

1. dip switch are all on, using LCD I do the calibration, the slider move 1cm forward then 1cm backward
2. power off, switch all dip on, then change dip switch 1 to off, send 1cm move order => 1 step is done then leds go green+red constant
4. power off, switch all dip on, then change dip 1 and 2 off, power on, send 1cm move => same
5. power off, switch all dip on, then dip 4 off, power on, send 1cm move => same
6. power off, switch all dip on, then dip 3&4 off, power on, send 1cm move => slider move 1.5cm (but move...)

the magnet is attached to the shaft using a nylon spacer.
distance between the magnet and the sensor, about 1.6mm, tried with shorter distance, same...

jlmxyz, 2021-04-01:
I managed to make it work somehow...

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

I managed to make it works somehow.....

1. I had to swap 1&2 motor wire
2. put all dip on
3. redo calibration
4. reset et power off
5. move dip4 to off
6. power on

it's working somehow..... I make a move 10cm, it begins to move with an awful noise then suddenly stop and make an really really awful noise, as if the motor was stuck by something.... it made me so worry that I jumped on power plug to switch off....
I redone the same test with the dip3 off (no closed loop) everything runs smoothly and quietly... O_o...

vb8080, 2022-11-29:
> b-Red light comes on with "Err: 035.99"

For me it helped that i adjusted the "Motor mA" value!

marshr32, 2022-11-29:
> How sensitive is it to the magnet being perfectly center?

Since this thread got bumped again I thought I'd add something else I found out.
The magnet doesn't have to be perfectly centred for the system to work, however for me, moving it around a little has massively improved how smooth the motor operates.

I didn't glue the magnet, just dropped on in the end of the shaft so it stuck itself. So I can just poke it with a plastic screwdriver to move it.

Also, you can loosen the screws on the board slightly and move the board to center with the motor running, which also helps with smoothness and noise.

Happy playing!

Thread 25 (2020-10-23):

X axis dancing

Sekai1942, 2020-10-23:
Hi. i just installed s42b on my diy printer and did the calibration and it works but the x axis when i try to move it it just goes back and forward really fast.I think the whole asamble is to large in weight and it overshouts when moving then try to compensate then it overshouts in reverse and that becames a loop.
I try to lower the accelaration but the same thing.
The Y axis does the same but not every time (as shown in video).
And when i turn off the motors in the interface below, the y axis i can move it but the x axis the motor stays energized but there is no compensation meaning the board is not active for close-loop.
Any ideea how to solve this?
https://drive.google.com/file/d/1P0TRuBtJh8re5k-FxD4gFDRKnzX-ddsW/view?usp=sharing

Quas7, 2020-10-23:
Did you calibrate without load (belt detached)? That would be my first shot as imprecise calibration kills the PID loop quite easy.

If the calibration is fine without load I would check for the PID settings of the S42B as they likely need tuning for heavy loads. Can be done either via serial control (see the manual) or via flashing the firmware directly (my prefered way).
Oszillation should be either too much I or P or to little D. Instead of I=10 a few use I=2 or even I=1. Just reduce I until you get no oszillation. If this is not possible, reduce P as well.

I am not sure, how far Jan is already for his fork to get PID tuning more user friendly: https://github.com/swanepoeljan/TrueStep

Maybe you check the other issues in this repo as well as there are some tunings required for Marlin 2.0.x as well.

Sekai1942, 2020-10-25:
You are right. i calibrated without load.I calibrated the y axis with load and it looks ok now but the x axis i have no way to reach out to the buttons. i will have to serial control it.
thanks.

Sekai1942, 2020-10-25:
btw how to upload the firmware?

Quas7, 2020-10-25:
for the flashing of the FW you will need an stlink dongle (clone). More details are here:

https://github.com/bigtreetech/BIGTREETECH-S42B-V1.0/issues/3#issuecomment-691197566

Sekai1942, 2020-10-28:
> for the flashing of the FW you will need an stlink dongle (clone). More details are here:
>
> [#3 (comment)](https://github.com/bigtreetech/BIGTREETECH-S42B-V1.0/issues/3#issuecomment-691197566)

Thx for the replay. I order the dongle about a month ago for different project.
The current problem i have is i cannot modify the pod from serial.
It gives me a response back but when i try to change the parameter, it gives back crc sum error.
What i am doing wrong?

Quas7, 2020-10-28:
@Sekai1942 I never used the serial interface and always flashed my changes directly. So, I can not help much on this one but there are other issues discussing on this here, I think.

swanepoeljan, 2020-10-28:
@Sekai1942 Did you see [this](https://github.com/bigtreetech/BIGTREETECH-S42B-V1.0/blob/master/Serial%20data%20transfer%20protocol.pdf) document. It explains how to calculate the checksum.

Sekai1942, 2020-11-09:
yes i found out how to modify the parameters.

swanepoeljan, 2020-11-09:
In the meantime I have added support for the original firmware in my [terminal program](https://github.com/swanepoeljan/TrueStep/blob/master/TrueStepTerminal.zip) which you could also use for changing the PID gains.

robtheminnie, 2021-01-04:
Does this firmware also work with the s42b V2.0 or is it only suitable for the V1.0?

swanepoeljan, 2021-01-04:
Since V2.0 uses the STM32F103 and probably also use a different pin out it will most likely not work. As for the terminal program, I am not sure, if they kept their protocol the same it could probably work.

robtheminnie, 2021-01-04:
@swanepoeljan, thanks for the info.  I commented in another issue, #32 , about having the same problem.  The user fixed the issue by updating to your firmware fork.  However, as I have V2.0 boards, this isn't possible.  Are you familiar with the #32, and behaving indicated, with vertical lines and ringing.  I'm assuming it's incorrect PID gains.  Any thoughts?

swanepoeljan, 2021-01-05:
Haven't seen that post, glad to hear it worked for him. I would also try playing with the gains to see if it helps, maybe he can share his printer model and gains that worked for him.

Thread 26 (2020-10-23):

motors loud/screeching

lousassole, 2020-10-23:
I am at a loss here. I have installed these drivers/kits on my x and y axis, and on both axes when holding position they emit a loud whine. When moving it becomes more of a screech. I have tried loosening my belts, which did not help much. I have ensured the voltages are correct as well, and that everything is mounted flush.
The printer still runs well, the screeching is nearly unbearable though.
Is there anything i'm missing that fixes this?

Quas7, 2020-10-23:
do you have a datasheet for your nema17 motors? E.g. the inductance, resitance and current rating?

lousassole, 2020-10-24:
Brand: Creality 3D
Item name: RepRap 42 Stepper Motor
Item number: 42-34
Step angle: 1.8 degrees
Nominal Voltage: 4.83V
Current Rating: 1.5 (A)
Rated speed: 1-1000 (rpm)
Rated torque: 0.4 (NM)
Ambient Temperatuar: -20℃~+50℃
Length: 34mm

The printer runs off 24v, mainboard is a BTT SKR 1.4 turbo on marlin 2.0.x bugix
they are the default x/y motors for the ender 3. As far as i'm aware, they should be compatible.

Quas7, 2020-10-24:
ok, and changing the motor current does change the screaming frequency?
I had loud motors only, if I wired the phases incorrectly (A1,A2,B1,B2 S42B output but some motors are A1 B1 A2 B2 input). But with wrong wiring they should move very erratic and you get successfull prints, right?

lousassole, 2020-10-25:
prints are successful (even had a successful 16hr job last night), and changing voltages seems to have no effect as far as i can tell. It seems to be that whenever there is any strain placed on the axle of the motor it produces this screeching sound.

Quas7, 2020-10-25:
I think, your motors are a bit on the high side with their inductance (>7mH maybe).
The required voltage to drive 1.5A is quite high which means there is more wire with its series resistance on the motor coils and this results in a higher inductance.
High inductance makes motors reluctant to change direction (or accelerate) and that should hit the decay mode of the stepper driver stage and might result in audible noise. Normally, higher or lower supply voltage should change the pitch.

In other words, you could try nema17 with <4mH or just around 3V for 1.5A and around 40Ncm torque.

https://reprap.org/wiki/NEMA_17_Stepper_motor

lousassole, 2020-10-27:
i'll play with the voltages some more. I'm trying to keep the motors as cool as possible though, so i may end up having to switch to a different motor.

Thread 28 (2020-10-30):

Board no longer powers up

MetalBeard72, 2020-10-30:
I'm afraid I fried my board. I have been very careful to power down before making any connection or switch changes. Now the green LED no longer turns on.  Just on the off chance that I can resurrect this thing, Has anyone else saved one of these?

Quas7, 2020-10-31:
can you still communicate with the controller via the SWD interface (e.g. still program it?), if powered only via the SWD interface?
If this does not work anymore, I would trash it.

Quas7, 2020-10-31:
Maybe also check with magnification that there is no bent pin/short or any other metal flicker sticking somewhere.
Reassembling the boards often might have thown some metal splinters from the screwing process on the board...

dzid26, 2021-03-06:
I wonder if BEMF could have kill it.

Because when I drive the motor from the output fast enough, the MCU resets. @Quas7  Do you have idea why is it restarting?

The input voltage is stable and current is never reversed.  - Hmm, maybe that's the key, because I think the board have reverse polarity protection diode. So if that diode doesn't allow the current to flow in reverse, the internal voltage will rise high. Though, I would expect the linear regulator to heatup, and no MCU reset.

....Hah, while writing this I run it with a drill for longer, while it was reseting. It seems the A4950 didn't handle BEMF. Mosfet are shorted and it is drawing 0.4A continuously now.  Bummer.
But MCU still works.

Anyway, I still don't udnerstand why it was resetting.

I guess for now I am going to stick with MKS42B which doesn't have reverse polarity diode. I also put clamping diode on supply lines to protect for overvoltage.

dzid26, 2021-04-06:
Ok, so I think it resets (and then burns) from BEMF, due to bad location of the clamp diode.
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
@bigtreetech  Maybe V2.1 could be improved.

Thread 29 (2020-11-01):

Missing License file and source files.

JustGitting, 2020-11-01:
Hi BTT,

Seems BigTreeTech's major positive selling point is that sells "Open Source Hardware". Giving users freedom to modify, repair and create new applications with BTT hardware. However, this goal is not backed up by the appropriate license or source files (gerber PCB design files, etc) in this repo, see #5 for example.

Please add an appropriate Open-Hardware License (e.g. OSHW) and provide the hardware source files (e.g. gerber, netlists, etc files) to this great project.

Best wishes.

GithubSimba, 2020-12-08:
@JustGitting Hello. Do you have any reply from BIGTREETECH?

JustGitting, 2020-12-08:
Hi @GithubSimba,

Nothing from @bigtreetech, which is rather disappointing.

Unfortunately there are companies that claim to produce "Open Source Hardware" because either they don't really understanding the meaning of OSH or they are being deceptive. Simply adding a few PDFs and some software does not make it "Open Source Hardware". OSH should allow users to reproduce their own device without the need for proprietary tools or software (in general), hence the meaning of Freedom.

@bigtreetech please update your repo with the appropriate OSH license and hardware source files as soon as possible or stop pretending to be for OSH.

Thread 30 (2020-11-03):

How to update the firmware?

tiagomaricate, 2020-11-03:
Hi people!
I was reading tome topics related but the documentation itself is very minimum.
I'd like to know if there is some kind of tutorial or similar to help me on how to update the S42b.
So far, the only thing I know is the need for an adapter.

Quas7, 2020-11-03:
A starting point can be found here: https://github.com/bigtreetech/BIGTREETECH-S42B-V1.0/issues/3#issuecomment-691197566
A working adapter would be a stlink v2 clone, or any other stm32 programmer that can be found on Amazon.

Setting up the development environment consiting of Visual Studio Code and platform.io can be found on youtube, e.g. https://www.youtube.com/watch?v=cmHQxd_qGl8

Hope this gets your running.

tiagomaricate, 2020-11-03:
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

Tks!!!
I will give a check.

imperator-maximus, 2021-03-04:
Platform.io was not able to upload firmware here (" OpenOCD init failed"). Solution: use STM32 ST-LINK Utility. Open firmware there and upload it via "Target"-"Program"

vc, 2021-03-22:
After uploading [TrueStep](https://github.com/vc/TrueStep) firmware via ST-LinkUtility, you can upload firmware via serial port using [TrueStepTerminal NG](https://github.com/vc/TrueStep/tree/master/utils/TrueStepTerminal)

paulrbeers81, 2021-05-03:
@vc is TrueStep compatible with S42B v1.1?  I assume so since the processor is the same and I THINK it's just a tweak to the layout, but maybe not?

vc, 2021-05-03:
> @vc is TrueStep compatible with S42B v1.1? I assume so since the processor is the same and I THINK it's just a tweak to the layout, but maybe not?

You are right. TrueStep firmware specifically for S42B v1.1

ravx4, 2021-05-25:
Hello everyone,
After reading topics about True Stepper, I decided to give it a try.
I have managed to upload firmware.bin via ST-Link utility and it's working fine.
However, when I try to connect via true step terminal, I get "could not connect" message no matter what baudrate is set.
Also I have tried connecting my S42b v1.0 to TS-terminal on 2 different laptops and pc (win 10 and win7) and still got the same error.
Can anyone give me any clue what could be the reason of this error?

vc, 2021-05-25:
> Can anyone give me any clue what could be the reason of this error?

I think you'd better ask a question in the repository from which you took the firmware and the TS-terminal program. There are already several varieties of these components.

ravx4, 2021-05-25:
Thank you for reply @vc,
although I don't quite understand how to ask in original repository (I'm using files from @swanepoeljan repo) as there's no possibility to open an issue there.

vc, 2021-06-01:
> although I don't quite understand how to ask in original repository (I'm using files from @swanepoeljan repo) as there's no possibility to open an issue there.

Yes, you are right, the issue section has been closed in @swanepoeljan's repository.
You can try using my build of s42b firmware and TrueStepNG software. I forked from @swanepoeljan repository and did some tweaks. If it is interesting, you can look here: https://github.com/vc/TrueStep

ravx4, 2021-06-13:
Ok, I'll try your repo, maybe can manage to get board comunicating with my pc,
Big thanks again :)

Thread 31 (2020-11-04):

Steppers running too hot

KOENgineering, 2020-11-04:
Installed the driver on X and Y ( on SKR 14 Turbo) Z and E use TMC2209 and are much cooler than before specially Z (E is pancake stepper that comes with BB direct drive extruder, all on Ender 3 pro)
but X and Y are too hot, over 60-70 deg (approx) once I burned myself on X axis drive
stepper in standard creality motor, before was hot (on standard ender 3 MB, but now it HOOOOOT, tried to reduce the current to 600mA same, no changes,

motor is 1.2 A rated, should I set the current to 2400 mA, will that lower the temp (makes no sense that higher current will lower it)
seriously thinking to remove the drivers and go with TMC2209 for X and Y too, this is just a crap!
and yes, I do not see any improvements to the prints

Quas7, 2020-11-04:
I would generally expect that the S42B setup is always running a bit hotter regarding the "total area" around the motor, if it is running under full mechanical load for same RMS current.

Reason are the stepper drivers that are right next to the motor withint a few millimeters with a S42B.
With a normal TMC2209 you have at least the stepper drivers normally cooled with a fan far away on the MB and also the inner resistance of the TMC2209 is much lower than the Allegro drivers on the S42B resulting in even more heat right next to the motor.
Also, convective cooling is a bit reduced with a piggy pack board on the motor backside.

Thread 32 (2020-11-06):

Poor quality prints

megatech1966, 2020-11-06:
Hello all. I installed 2 BTT S42B V1 on to my x and y. Calibrated ok. Uncommented x and y in configuration.h. Y was playing up. Wasn’t moving all the way to 0 on my bed. Changed 2 lines in configuration_adv.h
#define MINIMUM_STEPPER_PULSE 3

#define MAXIMUM_STEPPER_RATE 150000

Now y is working ok
Had to change x steps to 100 and y steps to 100

The problem is I get poor quality cube. Vertical banding and horrible ringing. The nice one was with my TMC2130s.
My max acceleration is 500
Any help would be appreciated 😃
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

megatech1966, 2020-11-06:
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

S42B using open loop (switch 3 off)

robtheminnie, 2021-01-04:
I have a similar issue with mine.  I have these fitted to x and y on an ender3, and now have the same ringing/vertical lines shown in the initial post.
Have you found a fix?

megatech1966, 2021-01-04:
I updated the firmware from a fork of the btt firmware

robtheminnie, 2021-01-04:
> I updated the firmware from a fork of the btt firmware

Do you have a link?

Was it from here?

https://github.com/bigtreetech/BIGTREETECH-Stepper-Motor-Driver/tree/0814d4a0371aa818ba08abeb214c3f460904cde9/S42B/firmware

megatech1966, 2021-01-04:
https://github.com/swanepoeljan/TrueStep

robtheminnie, 2021-01-04:
Ah, thanks.  Also, just seen you are using the V1.0 board.  I have V2.0 boards so that fork won't work unfortunately.
Thanks for the info though :) I might get in touch with the writer of that fork and see if he has any input.

GIANNHSitia, 2021-02-15:
I have the same problem, have you found a solution? I have S42b 1.1 to X and Y axis

![Uploading IMG_20210214_191235.jpg…]()

megatech1966, 2021-02-15:
I have a solution for version 1.0

GIANNHSitia, 2021-02-15:
how to fix it?  not working to 1.1v?

megatech1966, 2024-04-07:
This issue should be closed.

Closed 2024-04-07.

Thread 33 (2020-11-11):

Direction of motor rotation during calibration?

IhorNehrutsa, 2020-11-11:
My motor was worked well only in an open-loop mode (DIP 3 is OFF).
After Calibration (when DIP 3 is ON) when the motor shaft was rotated manually, the Err: parameter changed near +/- 1 degree.
I pushed the magnet out of the motor housing as described in issue #19. That not helped.

Closed-loop mode began work, only when I swapped two wires of one motor coil. That changed the direction of motor rotation during the calibration process.
So I think there is a bug in the calibration process which requires a certain direction of motor rotation. First CCW, then CW (View from the shaft, not from the driver board).

Quas7, 2020-11-11:
Interessting. I will test this next weekend.

ElekPat, 2020-11-12:
Thank you very much, I could not get my motor to run in closed loop (i tried all previous suggestions) until I tried this: IT WORKS NOW !!!

dzid26, 2021-01-19:
Or one can change DirPin direction in the menu

Thread 34 (2020-11-30):

Endstop issues

MasterBPM, 2020-11-30:
Hi,

i have to say i am very unpleased with this Product so far. Bought 5 pre-assembled s24b v1.2 from biqu and I am now troubleshooting since 14h. So on all 5 Steppers the magnet has different dimension so I had  to disassemble all of them and measure, combining spacers to fit correct distance between magnet and sensor. Also 1 Display provided a short (lucky I had spares). 1 Motor is still not running in closed loop, but in open. So much "fun" for 32€ each. Anyway ...

I am running an skr 1.4 Turbo with 5 of these and newest marlin Bugfix. The only thing I really think I can't figure out myself is the problem I had on all endstops in closed loop.

---------

X and Y - hits endstop, stepper stops but  raise up from 0.04° to ~35° error/misalignment and stepper shows red led till I press reset button or reset printer. No issues in open loop.

BL touch clone for z - axis turns up a bit (5 mm) should then pull down pin and motor steps down to heatbed, but instead it doesn't pull down the pin but also here error count goes up to ~35° , red led turns up and only reset pin or printer reboot fix it.

With other motors and tmc 2209 everything is running fine, also in open loop everything is as it should be. But I need the closed loop feature otherwise this product is absolutely useless for me.

I hope someone could help.

Cheers,

MBPM

Quas7, 2020-11-30:
is the s42b stepper driver timing already set to slow?

MasterBPM, 2020-11-30:
Hi,

Iam not 100% sure what you mean. If you mean pulse settings I tried it commented, 1/500000 and 3/150000 in marlin conf adv.

Cheers,

rafaljot, 2020-12-08:
I am very disappointed with the lack of a feature from the nano_stepper project. Especially the virtual endstop.
https://github.com/Misfittech/nano_stepper

"
**errorlimit**
Gets set the maximum number of degrees of error that is acceptable, any posistioning error about the error limit will assert the **error pin**, when error pin is set as error output.
For example:
:>errorlimit 1.8
Will set the error limit to 1.8 degrees.
"
I think it could be the best option to manage endstops.

Thread 35 (2020-12-01):

S42B 2.0 Closed Loop Not Working.

rennwaffen, 2020-12-01:
Just installed the new S42B 2.0, and closed loop doesn't seem to want to work. I'm waiting on a response from BTT (which takes a little while) so I figured I'd ask here in the meantime. I also have a V1.1 on my X axis that works flawlessly. Any idea as to what the issue could be? Notice the deg. value not changing as the axis moves.
Info:
Calibration went fine (Supposedly)
DIP 3 is set to ON
DIP 1, 2, 4 are set to OFF
32 Microstepping
Tried currents as high as 1000mA (2000 setting) with no luck.
Board: SKR 1.4 Turbo

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

dzid26, 2021-01-19:
Swap one one of the phase polarity:
https://github.com/bigtreetech/BIGTREETECH-S42B-V1.0/issues/33#issue-740859328

N6MQD, 2021-01-28:
There is another issue posted that may be your issue.  DIP 2 is for Closed Loop mode.  DIP 1 is for Calibration.  DIP 3 and 4 are for subdivision.

Thread 36 (2020-12-16):

S42B_v2.0 won't enter calibration mode

pizzabola, 2020-12-16:
Hey I'm writing this be cause the lack of clear instructions on the BTT github site.
My set up:
BTT SKRv1.3
Stepper 17HS4023
S42B_V2.0 board
This is what I've done so far:
I installed the hardware S42B and the oled display on my x axis stepper motor. After that, I remove my TMC2208 driver from the skr 1.3 and installed the cable from the S42B and put it in place (in UART mode). On the S42B I flipped all the switches to off but switch #4 which remained on according to the pdf from BTT to enter calibration mode.
On marlin, in the configuration.h,  I comment out //#define X_DRIVER_TYPE  TMC2208 in order to make the stepper driver to default "A4988". In configuration_adv.h I enabled "#define MINIMUM_STEPPER_PULSE 3" and also enabled "#define MAXIMUM_STEPPER_RATE 150000" changing the values from 250000 to 150000. I compiled everything on visual studio code and uploaded the sketch to the skr1.3. I turned on the printer and everything seemed working just right but when I try to calibrate the stepper using the oled display of the S42B nothing happens. I mean, the s42b turns on but no blinking lights or motor movement at all. From the lcd display of the printer I was able to make the steppers move no problem. The only problem is that the S42B won't enter calibration mode. I'm I missing some step to set up closed loop control right? Any help would be pretty much appreciated thanks

Q5Grafx, 2020-12-17:
I have the same with a couple of mine. at first they would go to calibrate whenever i wanted them to. one day they stopped. My machine is working flawlessly but i cant do a calibrate. Im running 3 of these on 60mm steppers and my machine was kinda close before but i could never get exact dimensions. when i added these its dead on and repeatable. With mine i had issues with a few motors and ill explain what i did so maybe it will help you. I set mine to activate high so i had to set $4=1. still was getting issues with start and stops but the software thinking the motor was moving but it wasnt. pin 1 and 2 are for microstep settings, make sure they are set to match the setting on the oled screen. i set the power to the power level the motor was rated at and not doubling it like others have said because the power is halved. I also had to add a non magnetic spacer behund the magnet to raise it slightly outside of the aluminum motor housing. for these i found 5mm copper stamped discs on etsy. it took 4 to get about 2mm height increase. then put on a 5mm spacer to lift the board to get about 3mm space between the magnet and the sensor. when i turned on my machine after this last mod i couldnt get into calibrate on 2 of the three motors, but when testing actual calibration against a caliper i am with .001" which for me is good enough. in addition the stepper motors are completely silent now where they had never been anything close to silent. I ran a few test jobs last weekend and all went well, all dimensions were dead on and cuts were clean so now its time to make christmas gifts for the grandkids. I forgot to mention if i set pin 4 to on and pin 3 to off i can get into calibrate on those 2 motors. but not when closed loop mode on and calibrate pin turned off. the third motor doesnt really care what settings are and it will calibrate any time i want it to. the third motor is new though so i wonder if it will stop going to calibrate after awhile.  Hope something in this rant helps.

GhostlyCrowd, 2021-01-19:
Did you guys ever solve this i have 2 brand new ones and neither will enter calibrate mode, the rest of the menu works.

jcmental, 2022-11-02:
Hi Sorry to bring up an old thread, but I've just installed 2 of these and neither will accept any function i select from the menu, I have 2 S42B V2.0 I can scroll through the menu but when I press the enter button nothing happens. I have all dip switches to off except #4

Thread 37 (2020-12-20):

schematics??? and 0.9deg motor support?

jlmxyz, 2020-12-20:
Hi,
on the documentation, it's said we have to cross some motor control lines and not some others... on my motor there is only wire that goes outside... I assumed the wire color were the same as the provide cable... but there is nothing that happens when entering calibration except a bad noise... my motor is a 0.9degree motor, obviously the calibration will fail because a whole rotation won't be performed...

1. I need the schematics of the board to now how the drivers are connected to the motor control interface
2. I don't get what the purpose of the switches on the center of the board, again a schematic will greatly help
3. I will have to reflash the board in order to support my 0.9 motor... I read that there is only a way through the JTAG inteface on P4 connector?

thanks and regards

Quas7, 2021-01-13:
I think, you should maybe read a summary on NEMA17 motor wiring and working principle. You have to connect A and A' (coil A) as well as B and B' (Coil B) of the motor correctly to the 4-pin connector of the board.
The wire color is no indication here as it is not standardized at all.

Here are the requested informations, if that can help you.

1. it is hidden in a not very convient way here: https://github.com/bigtreetech/BIGTREETECH-S42B-V1.0/blob/master/Item-Pinmap.PDF
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

2. read the manual on page 7 and page 9 for the dip switch meaning (schematics will not help you because they are just inputs to the firmware): https://github.com/bigtreetech/BIGTREETECH-S42B-V1.0/blob/master/42%20Stepper%20Motor%20Closed%20Loop%20Driver%20Control%20Board%20Manual.pdf

3. it is the so called SWD interface. Pinout see pinmap above. Just make sure, the motor is not enabled during programming as this messes with the signals. You will need a stlink v2 or similar to program. Good luck.

pctj101, 2021-01-18:
Hello!

I looked at https://github.com/bigtreetech/BIGTREETECH-S42B-V1.0/blob/master/Item-Pinmap.PDF

I see your info, but it does not contain the part number, or part values (such as 330 Ohm).  Is the part list available?

Thank you!

Quas7, 2021-01-19:
there is no BOM (part list) provided, afaik.

jlmxyz, 2021-02-03:
> I think, you should maybe read a summary on NEMA17 motor wiring and working principle. You have to connect A and A' (coil A) as well as B and B' (Coil B) of the motor correctly to the 4-pin connector of the board.

well, in fact this don't help... on https://github.com/bigtreetech/BIGTREETECH-S42B-V1.0/blob/master/Item-Pinmap.PDF there is no information about where A and A' and B and B' are located.... there is also nothing printed on the pcb.... a schematic would have gave me the answer... but no... so I will have to try and guess...

Thread 41 (2021-01-17):

How to Update firmware

adamfilip, 2021-01-17:
How Do you connect the S42B v1.1 board to USB?
it has no USB ports

IF i need to use another device.. what pins does it use?

Quas7, 2021-01-17:
dpublicate of #30

JWest1969, 2021-02-26:
I too have questions about this. There was no programming cable supplied with the unit. There is no description other than an image of 4 wires plugged into the header pins on the board. I have no serial port on my computer, just usb, so I have no clue what to do. My installation went smoothly until I ran a test print and the result was very ugly print quality. I hope someone will chime in and show/tell about the actual device needed to connect to the board to access parameters that are not available through the provided user interface of the oled screen and buttons. It sucks that the device doesn't work correctly out of the box and that myself as an end user of the product has to become a firmware programming expert in order to make it work on my machine! If I turn dip switch 3 off (open loop mode) prints look great! With dip switch 3 turned on (closed loop mode) prints look terrible.

NZ-Nitro, 2021-03-21:
The information supplied by BTT is pretty shit, did you know between 1.1 and 2.0 the button functions reverse?

Thread 42 (2021-01-19):

Build Failing with new version of ST STM32 (11.0.0)

cwindsor2003, 2021-01-19:
PLATFORM: ST STM32 (11.0.0) > STM32F030C8 (8k RAM. 64k Flash)
HARDWARE: STM32F030C8T6 48MHz, 8KB RAM, 64KB Flash
DEBUG: Current (blackmagic) External (blackmagic, cmsis-dap, jlink, stlink)
PACKAGES:
 - framework-stm32cubef0 1.11.1
 - tool-ldscripts-ststm32 0.1.0
 - toolchain-gccarmnoneeabi 1.70201.0 (7.2.1)
AssertionError: Missing MCU or Product Line field:
  File "C:\Users\windsorchris\.platformio\penv\lib\site-packages\platformio\builder\main.py", line 170:
    env.SConscript("$BUILD_SCRIPT")
  File "C:\Users\windsorchris\.platformio\packages\tool-scons\scons-local-4.0.1\SCons\Script\SConscript.py", line 598:
    return _SConscript(self.fs, *files, **subst_kw)
  File "C:\Users\windsorchris\.platformio\packages\tool-scons\scons-local-4.0.1\SCons\Script\SConscript.py", line 287:
    exec(compile(scriptdata, scriptname, 'exec'), call_stack[-1].globals)
  File "C:\Users\windsorchris\.platformio\platforms\ststm32\builder\main.py", line 99:
    target_elf = env.BuildProgram()
  File "C:\Users\windsorchris\.platformio\packages\tool-scons\scons-local-4.0.1\SCons\Environment.py", line 219:
    return self.method(*nargs, **kwargs)
  File "C:\Users\windsorchris\.platformio\penv\lib\site-packages\platformio\builder\tools\platformio.py", line 61:
    env.ProcessProgramDeps()
  File "C:\Users\windsorchris\.platformio\packages\tool-scons\scons-local-4.0.1\SCons\Environment.py", line 219:
    return self.method(*nargs, **kwargs)
  File "C:\Users\windsorchris\.platformio\penv\lib\site-packages\platformio\builder\tools\platformio.py", line 127:
    env.BuildFrameworks(env.get("PIOFRAMEWORK"))
  File "C:\Users\windsorchris\.platformio\packages\tool-scons\scons-local-4.0.1\SCons\Environment.py", line 219:
    return self.method(*nargs, **kwargs)
  File "C:\Users\windsorchris\.platformio\penv\lib\site-packages\platformio\builder\tools\platformio.py", line 342:
    SConscript(env.GetFrameworkScript(f), exports="env")
  File "C:\Users\windsorchris\.platformio\packages\tool-scons\scons-local-4.0.1\SCons\Script\SConscript.py", line 661:
    return method(*args, **kw)
  File "C:\Users\windsorchris\.platformio\packages\tool-scons\scons-local-4.0.1\SCons\Script\SConscript.py", line 598:
    return _SConscript(self.fs, *files, **subst_kw)
  File "C:\Users\windsorchris\.platformio\packages\tool-scons\scons-local-4.0.1\SCons\Script\SConscript.py", line 287:
    exec(compile(scriptdata, scriptname, 'exec'), call_stack[-1].globals)
  File "C:\Users\windsorchris\.platformio\platforms\ststm32\builder\frameworks\stm32cube.py", line 43:
    assert PRODUCT_LINE, "Missing MCU or Product Line field"

Pampinho1, 2021-01-19:
Look into #38. I was able to get it to compile using those changes just fine.

Thread 43 (2021-01-20):

BTT S42B V2.0 - will not enter calibration

GhostlyCrowd, 2021-01-20:
I've got 2 brand new BTT S42B V2.0 and I can't get either one of them to calibrate. They start up to say calibration OK but when I click calibrate with Dip4 on if does nothing, the K4 button works because I can use it to change every other menu option but selecting calibrate does absolutely zero.

It's not functioning in closed loop either (dip4 off dip3 on). But it is working I can move the stepper It never corrects its self, the RPM always says 0000, error always 000.00 and degrees never change from the initial value when turning on the stepper. I've gone over the documentation several times its pretty sparse. What am I missing?

Quas7, 2021-01-20:
was dip 4 off not required for enabling writing the cal data to the flash area? not sure, how it is for v2.

GhostlyCrowd, 2021-01-20:
> was dip 4 off not required for enabling writing the cal data to the flash area? not sure, how it is for v2.

I've tried both on and off and regardless it won't enter a calibration state. It does nothing when selecting to calibrate.

milicigoran, 2021-01-21:
i had the same problem and remember reading that for version 2 you need to have dip 1 and 2 on and for another version was 3  and 4. so i just turned 4 off right now and turned on 1 and 2 and it worked. it went into calibration mode. But whats weird is the writting said to do that after you calibrate. so try that. it worked for me. so 3 and 4 down and 1 and 2 up.

GhostlyCrowd, 2021-01-21:
> i had the same problem and remember reading that for version 2 you need to have dip 1 and 2 on and for another version was 3 and 4. so i just turned 4 off right now and turned on 1 and 2 and it worked. it went into calibration mode. But whats weird is the writting said to do that after you calibrate. so try that. it worked for me. so 3 and 4 down and 1 and 2 up.

MOTHER OF GOD THIS IS THE ANSWER!

GhostlyCrowd, 2021-01-21:
Either the Dip switch is mounted backwards. 1 seems to be 4 and 4 seems to be 1. Dip 1 on 234 off its calibrating Now. So the PDF guide in the source code says Dip 4 on 123 off, sigh but in reality its Dip1 @milicigoran  thanks!! i wasted so much time compiling and flashing because seriously how could ever BTT S42B V2.0 i got be bad???

milicigoran, 2021-01-21:
I found it am accident because I have 2 other ones that it's dip 4 and they work perfect but I was in here this morning looking for a solution trying to compile with vs code. Not letting me. And I've had this new one for a few days but haven't touched it because i was waiting for my linear rails to get here and make my printer in to double z with linear rails everywhere. Anyway couldn't find a solution to my problem but your post was the last one i read before going to start the hook up process and sure enough it wouldn't calibrate. But my other one side just fine. And then i remembered reading on BTT website that for sale 1.4 turbo it's pins 3 and 4 and for 1.3 i think it's pins 1 and 2. But that's to run it after you calibrate. But since I saw that you guys tried everything else i said i might as well try pins 1 and 2. And sure enough. I was like a little kid. Didn't wait for the calibration. I went straight to the computer to let you know because I know how it is to want to do something but u just can't and hope someone else figures it out. I hate that feeling. Anywayblojfg story short glad i could help. Hope it works out for you.

GhostlyCrowd, 2021-01-21:
@milicigoran  I got them all working on my test bench ramps with Pin 1 instead of 4 for calibration and pin 2 instead of 3 for closed loop enable.  Pins 3 and 4 set the microsteps.   It makes no sense that a different Main board for the printer would change the dip positioning needs. I still feel like my dip and your dip switches are just installed in reverse.  The documentation is also lacking sadly. The PDF included with the V2.0 source shows a  board layout for their old S42A with USB port still.

milicigoran, 2021-01-22:
> @milicigoran I got them all working on my test bench ramps with Pin 1 instead of 4 for calibration and pin 2 instead of 3 for closed loop enable. Pins 3 and 4 set the microsteps. It makes no sense that a different Main board for the printer would change the dip positioning needs. I still feel like my dip and your dip switches are just installed in reverse. The documentation is also lacking sadly. The PDF included with the V2.0 source shows a board layout for their old S42A with USB port still.

Yeah it's probably reversed because I have 2 that work normal with 4 for calibration and just b1 that's pin 1. And this one that's backwards i got on Amazon for cheaper because it was a return. And I'm betting they returned it because they couldn't get it working. They were probably trying pin 4 and when it didn't work they sent it back. Actually just now writing this i realised another variable. This one that's like yours and backwards i got with the stepper as a plug and okay package. The other ones that are dip 3 and 4 i got just the board with the oled. Did you buy the package or just the board?

milicigoran, 2021-01-22:
Because it could be the package is different than if you buy just the board with the screen.

GhostlyCrowd, 2021-01-22:
> > @milicigoran I got them all working on my test bench ramps with Pin 1 instead of 4 for calibration and pin 2 instead of 3 for closed loop enable. Pins 3 and 4 set the microsteps. It makes no sense that a different Main board for the printer would change the dip positioning needs. I still feel like my dip and your dip switches are just installed in reverse. The documentation is also lacking sadly. The PDF included with the V2.0 source shows a board layout for their old S42A with USB port still.
>
> Yeah it's probably reversed because I have 2 that work normal with 4 for calibration and just b1 that's pin 1. And this one that's backwards i got on Amazon for cheaper because it was a return. And I'm betting they returned it because they couldn't get it working. They were probably trying pin 4 and when it didn't work they sent it back. Actually just now writing this i realised another variable. This one that's like yours and backwards i got with the stepper as a plug and okay package. The other ones that are dip 3 and 4 i got just the board with the oled. Did you buy the package or just the board?

I got the Full Kit with OLED with out the stepper from BTT's amazon store.  Kind of weird. Seems like they might have had a production run that was reversed.

N6MQD, 2021-01-28:
Just picked up two of the motors myself from Amazon and found the same thing.  Would not work in closed-loop mode but after reading the posts here, I tried reversing the number order.  I think the issue is documentation and not a reversed switch as the orientation mark on the PCB seems to match up with DIP position 1.

tnap1979, 2021-02-28:
I've just purchased 2 of these from KingPrint on amazon.ca s42b v2.0 without stepper motor..
I came here just looking for a manual.. but I'm damn glad I did because I'd have returned these myself thinking they were faulty for following old version information.. used pin 1 to calibrate, and pin 2 to set closed loop...
Seems more documentation and information needed for the v2 s42b's

NZ-Nitro, 2021-03-20:
I am going through the pain right now............ I find I can do the calibration but end up with a stepper that when I give it 10mm moves about 7.8, looking at your comments I am going to test this theory

NZ-Nitro, 2021-03-20:
Well so far the theory is correct with the switch positions but the problem still exists, pretty average company BTT

NZ-Nitro, 2021-03-20:
I I ever solve this I will share it from the rooftops bloody annoying

Sunbuzz, 2021-04-03:
@NZ-Nitro I think that has to do with the steps per revolution, the S42B uses 256 steps instead of 200. (Which is 78%)

NZ-Nitro, 2021-04-03:
> @NZ-Nitro I think that has to do with the steps per revolution, the S42B uses 256 steps instead of 200. (Which is 78%)

It's poor design, look for my post with the answer

NZ-Nitro, 2021-04-03:
Follow up comment from BTT
hello
Generally speaking, the motherboard firmware is set to 16 subdivisions. If the motor is 1.8 degrees, the number of pulses is 16*200=3200. If you use our S42B motor and set 16 subdivisions, our S42B pulse number is 4096, so 4096/3200=1.28. You need to use the original number of pulses per millisecond * 1.28 to get the correct number of pulses per millisecond. If S42B is set to 8 subdivisions, our S42B pulse number is 2048, so 2048/3200=0.64. You need to use the original number of pulses per millisecond * 0.64 to get the correct number of pulses per millisecond. Similarly, if 32 subdivision is used, the calculation method is the same as above.
Sincerely,
BIQU customer service

jammi, 2021-08-29:
> Generally speaking, the motherboard firmware is set to 16 subdivisions. If the motor is 1.8 degrees, the number of pulses is 16*200=3200. If you use our S42B motor and set 16 subdivisions, our S42B pulse number is 4096, so 4096/3200=1.28. You need to use the original number of pulses per millisecond * 1.28 to get the correct number of pulses per millisecond. If S42B is set to 8 subdivisions, our S42B pulse number is 2048, so 2048/3200=0.64. You need to use the original number of pulses per millisecond * 0.64 to get the correct number of pulses per millisecond. Similarly, if 32 subdivision is used, the calculation method is the same as above.

You could better just say it's using 256 steps per rotation instead of the usual 200 or 400. Anyhow, I have two of your modules that don't work properly and one that works most of the time, but not always. I think you could be much more responsive on updating your documentation and help your customers.

jcmental, 2022-11-02:
So guys, sorry new to all this stuff. I finally got the stepper to calibrate by setting all dip switches to of then turning #1 back on.
it says it’s calibrated on start up now, and I’ve managed to change the rotation of of one of the steppers. But I don’t know what to do now?
Do I switch dip 1 to off? I’m not sure what switch to turn on for closed loop?

oriwheb, 2023-01-23:
Putting this here in case someone else roams the internet for answers:
https://github.com/bigtreetech/BIGTREETECH-S42B-V1.0/issues/24#issuecomment-950551658

Basically: The hardware/firmware changed, but the wires from the S42B to the motor didn't, so you need to pop the pins out of the cable connector and rearrange them (the S42B's side of the cable is easier to deal with).

The classic symptom of an improperly wired cable is when the calibration process thunks along and stutters back and forth rather than doing clean steps in one direction then the other.
Another sign of improper cabling is if when trying to move the motor via the printer board/screen the motor locks up and starts heating up, this is probably because the wiring confuses the S42B since the movement does not match with what it thinks it sends to the motor, so it locks up in 'fixing the position' of the movement.

If the tiny screen module doesn't update in real time when you move the bed you can reset it to see the new degree.
Note that the screen might not show any data (only 000's) if DIP 3 is 'off'.

As for the DIP pins: 1 & 2 are supposed to match your chosen subdivision (microsteps) via the screen module.
3 in the 'on' position is for enabling closed-loop feedback (basically the entire point of all of this). Turn it off for open loop printing and debugging I guess.
4 is the calibration enabling pin. Without it in the 'on' position you can't calibrate.
I personally haven't seen any issues with calibrating while 3 is in 'on'.

Sadly, like I said, BTT change things up inconsistently, so some people get their DIP pins installed in reverse, so 1 is calibration, 2 is closed loop, and 3 & 4 are microstepping.
Copying this straight out of the PDF in BTT's github:
1st 2nd subdivision
impulses per circle 1024： 1 1 4
impulses per circle 2048： 0 1 8
impulses per circle 4096： 1 0 16
impulses per circle 8192： 0 0 32
Set your 1 & 2 DIP pins according to this. There's no need to turn them on or off when calibrating or enabling closed-loop.

Some people have issues with the magnet being too deep inside of the motor encasing, so propping the magnet up on glued non-magnetic material might help with properly tracking the magnetic field. You can see such interference visually if you have a piece of magnetic paper.
Note that according to BTT the distance between the encoder and the magnet should be between 2mm and 4mm.

Thread 44 (2021-01-21):

DEFAULT_ENV

milicigoran, 2021-01-21:
I cant seem to be able to compile the firmware with vs code. i get a "Warning! `env_default` configuration option in section [platformio] is deprecated and will be removed in the next release! Please use `default_envs` instead" when i try to compile.  From what ive read it has to do with the core of platforio but i checked i have the latest 5 which is backwards compatible with 4 which is what im guessing was out when this code was written. so how do i go about compiling it or should i just not worry and flash the bin file thats available and flash with my sd card?

milicigoran, 2021-01-21:
now im getting this.

AssertionError: Missing MCU or Product Line field:
  File "C:\Users\Milici\.platformio\penv\lib\site-packages\platformio\builder\main.py", line 170:
    env.SConscript("$BUILD_SCRIPT")
  File "C:\Users\Milici\.platformio\packages\tool-scons\scons-local-4.0.1\SCons\Script\SConscript.py", line 598:
    return _SConscript(self.fs, *files, **subst_kw)
  File "C:\Users\Milici\.platformio\packages\tool-scons\scons-local-4.0.1\SCons\Script\SConscript.py", line 287:
    exec(compile(scriptdata, scriptname, 'exec'), call_stack[-1].globals)
  File "C:\Users\Milici\.platformio\platforms\ststm32\builder\main.py", line 99:
    target_elf = env.BuildProgram()
  File "C:\Users\Milici\.platformio\packages\tool-scons\scons-local-4.0.1\SCons\Environment.py", line 219:
    return self.method(*nargs, **kwargs)
  File "C:\Users\Milici\.platformio\penv\lib\site-packages\platformio\builder\tools\platformio.py", line 61:
    env.ProcessProgramDeps()
  File "C:\Users\Milici\.platformio\packages\tool-scons\scons-local-4.0.1\SCons\Environment.py", line 219:
    return self.method(*nargs, **kwargs)
  File "C:\Users\Milici\.platformio\penv\lib\site-packages\platformio\builder\tools\platformio.py", line 127:
    env.BuildFrameworks(env.get("PIOFRAMEWORK"))
  File "C:\Users\Milici\.platformio\packages\tool-scons\scons-local-4.0.1\SCons\Environment.py", line 219:
    return self.method(*nargs, **kwargs)
  File "C:\Users\Milici\.platformio\penv\lib\site-packages\platformio\builder\tools\platformio.py", line 342:
    SConscript(env.GetFrameworkScript(f), exports="env")
  File "C:\Users\Milici\.platformio\packages\tool-scons\scons-local-4.0.1\SCons\Script\SConscript.py", line 661:
    return method(*args, **kw)
  File "C:\Users\Milici\.platformio\packages\tool-scons\scons-local-4.0.1\SCons\Script\SConscript.py", line 598:
    return _SConscript(self.fs, *files, **subst_kw)
  File "C:\Users\Milici\.platformio\packages\tool-scons\scons-local-4.0.1\SCons\Script\SConscript.py", line 287:
    exec(compile(scriptdata, scriptname, 'exec'), call_stack[-1].globals)
  File "C:\Users\Milici\.platformio\platforms\ststm32\builder\frameworks\stm32cube.py", line 43:
    assert PRODUCT_LINE, "Missing MCU or Product Line field"

Thread 45 (2021-01-25):

Manual and CAN bus control for V2.0 board?

mfxpyro1, 2021-01-25:
Where can I find the manual and details on how to use CAN bus to control the S42B V2.0 board ? I can't seem to find it anywhere.

Wayne2580, 2021-01-29:
I am interested in this as well

Frontpage32, 2021-02-19:
I too am interested. I have gotten some info but it's depressing if correct. Seems it only works on a specific duet board and doesn't work on any BTT boards at this time. (Please correct me if I am wrong) So it's is basically useless till BTT makes a board or you switch to duet well due to the cost that is not going to happen anytime soon.
This is the board I was directed to but seems duet has 2 or 3 that can use CAN BUS.

https://duet3d.dozuki.com/Wiki/Duet_3_Mainboard_6HC_Wiring_Diagram

Sunbuzz, 2021-02-19:
I am also interested.

NZ-Nitro, 2021-03-21:
i CANT FIND ANY INFORMATION anywhere ON THE s42b v2.0

dzid26, 2022-08-12:
Use [Intellistep ](https://github.com/CAP1Sup/Intellistep) firmware.

Thread 46 (2021-01-25):

S42b 1.1 after calibration write 357.7 degrees

GIANNHSitia, 2021-01-25:
Hello boys, i bought two S42B 1.1 for my printer. I test both with a nema17 and as after calibration, on screen write rpm 0, error 0 and degress 357.7. I tried many times to do it again calibration but the result is the same. I watched some presentation videos in youtube and saw after calibration on screen write 0 degress. my question is, is it defective or let me fix it. this video shows the problem please check - and the second problem is, when moving the stepper motor, the speed on the screen is 0. some write something

https://youtu.be/cgP7WpYkTbE

GhostlyCrowd, 2021-01-26:
In the video you never shut the calibration Dip switch off after you calibrate and reboot and turn the Closed loop dip switch on. So first i would  be trying that.

GIANNHSitia, 2021-01-26:
Hello, i try, with close loop dip switch OFF, after calibration and i press reset button, on screen the degrees is 0. After this, i turn off the power suppy and i turn the dio switch calibration OFF and the Close loop ON, turn again the power supply on and again write 357.6 degrees. I try and without 3d printer mainboad and is same. I have 2 S42b and present the same.
-note, that it works normally I just can not understand what 357.6 degrees means, and if it is normal

I attachment a video
https://youtu.be/GVUeH1f0JPE

GhostlyCrowd, 2021-01-26:
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

Try Turning Dip 2 on for Closed loop and 1, 3 and 4 off does that work?

Some of these boards seem to have the dips reversed, my V2 are both like this.

GIANNHSitia, 2021-01-26:
The dip switch 1 and 2 is the microsteps, 3 is close loop on/off and dip switch 4 is calibration. If dip switch 4 is off i cant calibration. 1 on and 2 off is 16.microstep ( i try 1 and 2 on but is same). Do you can a calibration video with v2 board???

GhostlyCrowd, 2021-01-26:
> The dip switch 1 and 2 is the microsteps, 3 is close loop on/off and dip switch 4 is calibration. If dip switch 4 is off i cant calibration. 1 on and 2 off is 16.microstep ( i try 1 and 2 on but is same). Do you can a calibration video with v2 board???

IF dip 4 off you cannot calibrate then your dips are not transverse.  what happens if you send it a movement command does the red light turn on and the motor fail to move?

GIANNHSitia, 2021-01-26:
No no work normal, the red light is off. If i try move the motor with my hand, this return to last position.the close loop working. Mabe the 357.6 degress is the calibration accuracy. 360 degress -357.6 = 2.4/200 step=0.012 error accuracy

Thread 47 (2021-01-27):

s42b v1.1 frame err! ch340g connection

linewallker, 2021-01-27:
Hello to all,
  I have some issue when I connect s42b v1.1 board via ch340g usb to ttl driver, no baud rate works and still getting only Frame Err! when I am on serial monitor.

Even connecting with TrueStep Terminal is not working and I am still getting this error again and again, but TS Terminal is reading the settings I need but when I change I can not write back with error message that something went wrong.

Does anyboody have any clue what to do to get it work ? I need to change PID settings due oscilation os X axis arm
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

when I change to 115200 baud I am getting only symbols
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

please help guys

when I try to move the arm it is like when the amatuer driver is trying to get the car mooving forward :)

GhostlyCrowd, 2021-01-27:
TX on the USB-TTL goes to RX on the S42B and RX on the USBTTL goes to TX on the S42B. GND goes to GND and don't connect  3.3v or 5v on the USB-TTL, Power the S42B via the Printers power. I have a cheap ch340g usb to ttl and this works for me.

linewallker, 2021-01-28:
Now I can connect and read data with no problem, but I can not write Back anything with error something went wrong
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

linewallker, 2021-02-22:
Thanks for your a swer, I will try tomorow and let you know if It worked for me. If I should be honest, i have conected only by Ch340 to usb without printer so this is possible the answer for me 😉Odesláno z mého telefonu Huawei-------- Původní zpráva --------Od: GhostlyCrowd <notifications@github.com>Datum: st 27. led 2021 21:54Komu: "bigtreetech/BIGTREETECH-S42B-V1.0" <BIGTREETECH-S42B-V1.0@noreply.github.com>Kopie: linewallker <linewallker@centrum.cz>, Author <author@noreply.github.com>Předmět: Re: [bigtreetech/BIGTREETECH-S42B-V1.0] s42b v1.1 frame err! ch340g connection (#47)
TX on the USB-TTL goes to RX on the S42B and RX on the USBTTL goes to TX on the S42B. GND goes to GND and don't connect  3.3v or 5v on the USB-TTL, Power the S42B via the Printers power. I have a cheap ch340g usb to ttl and this works for me.

—You are receiving this because you authored the thread.Reply to this email directly, view it on GitHub, or unsubscribe.

linewallker, 2021-03-01:
Ok, so after some time I must say that serial terminál is working solution but the P I D tuning is a large pain in my ass right now.
I do not know how to count the correct value so I am trying manuál way.

After about 1000 tests i am exactly where I started, axis still oscilate and create wawes in the plot even whe i am not able to setect vibration.

Do somebody know how to find correct values for P. I. D.?

linewallker, 2021-03-04:
It was not grbl so we can close it..

Closed 2021-03-04.

Thread 48 (2021-02-01):

Code example without Marlin?

imperator-maximus, 2021-02-01:
Hi, I ordered some S42B V1.1 and SKR V1.4/V1.4 Turbo board. I want to use these in a project which does not have any connection to a 3D printer or something similar.

As I see everything here is made so for 3D printer use with Marlin firmware.  I already found examples about how to implement custom functions for custom G-Code commands in Marlin.
But I am wondering how it would be possible to use that board + that closed loop S42B just in a plain example without Marlin overhead?
In both scenarios (custom G-Code command) or plain code: how to use these motors (Wifi, display,...)?

Thank you!

imperator-maximus, 2021-03-06:
In my opinion the interface has to be improved before which can be made via custom firmware. So with this it would be possible to access it via UART only and any board can be used. SKR V1.4/V1.4 is not very helpful here.

Closed 2021-03-06.

Thread 49 (2021-02-25):

Example how to read angle?

imperator-maximus, 2021-02-25:
Hi,
I already asked for a beginner example
https://github.com/bigtreetech/BIGTREETECH-S42B-V1.0/issues/48
but in the meantime I dig into Marlin and it is a crazy overhead but also quite simple to use anyway.

But I am still searching for  an example how to read the current target angle (the "Deg" value which is shown on display) in Marlin?
Thank you!

imperator-maximus, 2021-03-06:
I just found an example in custom firmware here: https://github.com/swanepoeljan/TrueStep/blob/master/firmware/S42BV1.0/Close_loop/src/User/telemetry.c which transfers angle via UART.

Closed 2021-03-06.

Thread 51 (2021-03-19):

S42B-V2.0 firmware rebuild

xhejtman, 2021-03-19:
Hi I tried to rebuild firmware for S42B-V2.0 version. It works, however, built firmware has only 35kB while pre-build firmware 2.0 has 54kB. This is ok, but the OLED display refreshes very slowly when flashed rebuilt firmware. If I flash pre-built, refresh speed is normal. Moreover, platformio settings for V2.0 has actually settings for V1.2.

Any ideas how to rebuild fast V2.0 firmware?

GhostlyCrowd, 2021-03-19:
The firmware the posted for V2.0 is incomplete and not what they shipped on the devices and does not work correctly.

They have ignored all requests ive sent to update the repository.

xhejtman, 2021-03-19:
Thanks, is there any firmware that can be used for V2.0? I need to rebuild to add 0.9 stepper support.

GhostlyCrowd, 2021-03-19:
a fellow by the name @CapSup1 is doing a rewrite in his free time its not working yet

CAP1Sup, 2021-03-20:
As of right now, the LCD is working (minor bug left with buttons, I'm going to fix it today). The serial and CAN bus should also be working, but I haven't personally tested them yet. As for the motor, I had issues with the encoder, so that's also on the list of things to fix. I'm getting close, I'm hoping to have it finished by the end of either this month or the next. I've just been busy lately working on my Robotics team.

xhejtman, 2021-03-21:
Thanks, great work. Should 0.9 motor work as well, if sources are tweaked a bit (mostly sed 200/400).

CAP1Sup, 2021-03-21:
@xhejtman I've already been working on implementing that, the motor calculations should accept basically any step angle you like once I iron out the kinks. I'll create a release once I finish with the stepper testing. I'm shooting for the end of the next month or two

Thread 52 (2021-03-19):

S42b firmware upgrade TrueStep

GIANNHSitia, 2021-03-19:
hello, today i upload the Truestep X1 firmware. After upload on screen write " NOT Calibration Please Calibrate".. i cant see Navigate menu. working only reset. i try connect with TrueStep Terminal but no connected. With Ttl, i connect the TTL TX to BT RX , and TTL RX to BT TX and gnd to gnd.. the 3.3v not need.. and Baudrate to 34800.... help me plz.. how to calibrade

Thread 53 (2021-03-20):

S42B Closed loop stepper inaccuracy

NZ-Nitro, 2021-03-20:
Well I cant be the only person with this problem.
Tried the 1.1 version first then the 2.0 version with exactly the same issue.
SETUP
SKR1.4 turbo
connected using the direct adaptor to the board
current 1600
steps 16
once calibrated (if does a full 360 deg turn both ways) if you send a command to the machine of 10mm it moves only around 7.8mm

Machine steps are accurate for an ender 5 plus

if I disconnect the motor and run it with a 2209 drive I get 10mm, change back I get the 7.8mm

My understanding of calibration is first run you turn on sw1 and sw2 plus sw4

when set up for 16 pulses is dip sw 1 on 2 off 4096

I have tried every combination possible lol

Who ense has had this?

NZ-Nitro, 2021-03-20:
More testing as I have seen comments about the 5v missing, I am getting 24v and also 3.3 v at the motor so that should be fine

NZ-Nitro, 2021-03-21:
Testing cont
changing dip sw 3 and 4 makes no change to the length of movement
changing #define DEFAULT_AXIS_STEPS_PER_UNIT   { 80, 80, 800, 100 } makes no change to the distance

maracMB, 2021-03-22:
Same issue here.
V1.0

Multiplexing tmc2100 and this s42b. So the input is THE SAME.
Tmc2100 moves correctly, s42b does not.

No matter the pins, no matter the 5 or 3.3v, nothing. It just fails to move correctly.

The calibration does rotate 360 degrees tho...

At total loss.

NZ-Nitro, 2021-03-22:
https://github.com/bigtreetech/BIGTREETECH-Stepper-Motor-Driver/blob/master/S42B/V2.0/42%20Stepper%20Motor%20Closed%20Loop%20Driver%20Control%20Board%20Manual.pdf Just been sent this by BTT

NZ-Nitro, 2021-03-22:
BTT reply to me and my problem

hello
Please operate according to the instructions first. And your pulse number setting is wrong. If the default number of pulses per millisecond for the X axis in the firmware is 80 and 16 subdivisions are used, you need to change it to 102.4.
Number of pulses per millimeter = one revolution of pulses
Number/Length of one circle of machine gear

maracMB, 2021-03-22:
yes there is a step/mm correction needed. we get that BTT, yet that's the issue; correcting step/mm is just... weird and wrong. all 1.8° degrees have 200 steps per rotation. it's HARDWARE BASED!
"operate according to the instructions first"... :D no comment needed.
i won't even sell these, i'll throw them away!

It's not just us two, there are more people, but predominantly, there are users of this that just don't find this weird. "oh i have to correct my steps, ok"..
it's not that i have issues with it not knowing how to use it. It is that it does not operate to common sense and in sync with anything we know.

NZ-Nitro, 2021-03-22:
I am away from home for a few days, my guess is there are 1000s of these that have been chucked in the bin, a degree is a degree a mm is a mm

NZ-Nitro, 2021-03-22:
I will study and test this on Wednesday

GhostlyCrowd, 2021-03-22:
> I will study and test this on Wednesday

If youre looking to fix any stepping accuracy, this project is working to redo the firmware in its entirety and addfeatures worth checking it out its in early stages https://github.com/CAP1Sup/Intellistep

maracMB, 2021-03-22:
@GhostlyCrowd now that looks proper! Thanks. I'll watch that.

NZ-Nitro, 2021-03-22:
Yeah I will watch this too, it's a pity BTT has let this one slip

NZ-Nitro, 2021-03-23:
4, 8, 16, 32, 64, 128, 256, 512, 1024

NZ-Nitro, 2021-03-23:
Here is the true calculation for an Ender 5+, so where on earth did BTT get their figure from?
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

NZ-Nitro, 2021-03-23:
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
I think I am onto something? 1024, 2048, 4096, 8192 are their micro steps as listed in the manual, this does not corelate to real world settings like I listed above

NZ-Nitro, 2021-03-23:
And if we use their setting..............................
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

maracMB, 2021-03-23:
@NZ-Nitro so they got the stepper pitch wrong? This is  easy fix in firmware right?

NZ-Nitro, 2021-03-23:
I am not sure, will look tomorrow as im knackered, last two days on a course learning how to relocate venomous snakes, was a lot of fun

NZ-Nitro, 2021-03-23:
Well some success at last I couldnt sleep so went out to test some things, I changed Marlin to #define DEFAULT_AXIS_STEPS_PER_UNIT   { 102.4, 102.4, 800, 100 }
Uploaded this to the printer and still got my crappy 7.8mm on a 10mm move
Decided to check the settings with Pronterface after seeing the popup in Marlin saying "override with M92" well checked and for some strange reason the setting didnt go into the printer!!, put the Gcode in M92 Y 102.4 and hello got my 10mm movement, anybody got some clues about this?
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

NZ-Nitro, 2021-03-26:
Follow up comment from BTT
hello
Generally speaking, the motherboard firmware is set to 16 subdivisions. If the motor is 1.8 degrees, the number of pulses is 16*200=3200. If you use our S42B motor and set 16 subdivisions, our S42B pulse number is 4096, so 4096/3200=1.28. You need to use the original number of pulses per millisecond * 1.28 to get the correct number of pulses per millisecond. If S42B is set to 8 subdivisions, our S42B pulse number is 2048, so 2048/3200=0.64. You need to use the original number of pulses per millisecond * 0.64 to get the correct number of pulses per millisecond. Similarly, if 32 subdivision is used, the calculation method is the same as above.
Sincerely,
BIQU customer service

CAP1Sup, 2021-03-26:
@NZ-Nitro
 I have read all of your comments and BTT really did a horrible job on this firmware. I am in the process of redoing the firmware with actual gcode commands, a whole CAN bus configuration method so you'd only have to connect to one to configure them all, as well as a full menu rewrite and a correction of the stepping algorithm. I hope to support a wide variety of motors and configurations on things like serial baud. Is there anything specific you'd like to see from the rewrite? I'm happy to implement anything that you think might be beneficial.

TazerReloaded, 2021-03-27:
> Decided to check the settings with Pronterface after seeing the popup in Marlin saying "override with M92" well checked and for some strange reason the setting didnt go into the printer!!, put the Gcode in M92 Y 102.4 and hello got my 10mm movement, anybody got some clues about this?

Marlin saves changed values to EEPROM, which is not overwritten by flashing firmware. So it does not matter what you specify in the firmware config as long as you have the old values in the EEPROM.
Still, the steps per mm should not change by switching drivers.

NZ-Nitro, 2021-03-28:
Thanks TazerReloaded I only just worked this out after countless hours trying to fix stuff, CAP1Sup I will probably use your firmware, its currently working and printing
Pretty poor show by BTT that what I have discovered is not covered on any documents anywhere

CAP1Sup, 2021-03-28:
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

It can if the microstepping is different I believe.

maracMB, 2021-03-28:
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

Sure, it can be, but multiplied 2x, 4x, 1/2x, etc.
Not 1.24x 😁

CAP1Sup, 2021-03-28:
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

Fair enough, you're right. I really don't know why it's different.

jlmxyz, 2021-04-01:
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

what the F***K?
"16 subdivisions. If the motor is 1.8 degrees, the number of pulses is 16*200=3200" => ok I understand this, 1.8degrees stepper have 200 steps for a turn.... right
"16 subdivisions, our S42B pulse number is 4096" => whaaaat? why 4096? why not Pi*AgeOfCaptain/squareroot(2)?????
ok, I don't get anything of the rest... if I knew this was sooooo bad, I wouldn't bougth thoses..... too bad the makerbase ones are not supporting 3.3V control power level... I chosen theses because they were 3.3V....

CAP1Sup, 2021-04-01:
What an interesting reply @jlmxyz I'm doing a complete rewrite, which I'm going to be finishing soon. I'm hoping to finish over this weekend. My version is not only better commented but it actually make sense. Check it out once you get the chance. The only thing that I need to finish yet to have it basically 100% operation is writing the communication for the encoder and making sure that the stepping method is correct.

maracMB, 2021-04-01:
@CAP1Sup is there a way for you to make factored steps? since you're rewriting firmware?...
Theory: the s42b is recalculating steps that the mainboard gives it. X number of steps that s42b board has to recalculate either way. Soooo, if s42b firmware would have an option to factor these steps, then one could use one output on the mainboard and drive these motors at virtually different step/mm from a single output of mainboard. It's complicated and at first stupid, but i'll try to eplain why this would be god-like to have:

i did an IQEX machine (quad - 4 independant carriages), the logical evolution is to do six... because why not. I now need 15 individual stepper motors. Duet3 is not an option. And using klipper also a no-no. so to achieve that i am expanding duet2+duex5 driver capacity via demultiplexing existing 2 external stepper driver pins. that will give the theoretical 10+10 native steppers PLUS 2x16 multiplexed stepper driver count/stepper driver channels. The demultiplexed steppers will serve as extruder motor drivers. Factored steps on s42b side would enable me to use different extruders and not be bound to same toolheads used at the same time or having to change esteps each time the toolchange happens.
For now, i wait your firmware like a godsend because it will give me an option of "forced" enable and thus holding torque on otherwise non-enabled drivers that will enable to use this principle not only for E motors but on Z motors as well...

So, if you could just input a tiny little additional factor for steps that we can then change via gcode.. That would be out-frickin-standing :)

PS: if you want to know more about my IDEX build, later Quad and further stuff about demultiplexing, my FB group is here: https://www.facebook.com/groups/237163797566846

THANK YOU IF YOU CAN IMPLEMENT THIS CRAZY IDEA! ;)

jlmxyz, 2021-04-01:
> What an interesting reply @jlmxyz I'm doing a complete rewrite, which I'm going to be finishing soon. I'm hoping to finish over this weekend. My version is not only better commented but it actually make sense. Check it out once you get the chance. The only thing that I need to finish yet to have it basically 100% operation is writing the communication for the encoder and making sure that the stepping method is correct.

humm too badly I don't have any hardware to reprogram the chip... I finished to make it work somehow... but compared to the maker base ones I have, they are 10x more noisy in closed loop and 2x more in open loop... and for some reason on closed loop mode, the movement never end (or maybe it ends, but I fear too much for my board to burn that I switch power off)... at the end of movement, the motor behave as if there was something blocking the movement... it make an awfull noise like an oscilation... as if a hammer was hurting a wall at high frequency... so I guess I will drop theses drivers, there is no schematics, noisy, poorly documented...

CAP1Sup, 2021-04-02:
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

This actually isn't that hard to implement. I'll have it implemented by tomorrow afternoon. It's actually only like 25 line changes to enable this. All I have to do is add a multiplication factor and an OLED menu. Any specific multiples you want?

CAP1Sup, 2021-04-02:
> > What an interesting reply @jlmxyz I'm doing a complete rewrite, which I'm going to be finishing soon. I'm hoping to finish over this weekend. My version is not only better commented but it actually make sense. Check it out once you get the chance. The only thing that I need to finish yet to have it basically 100% operation is writing the communication for the encoder and making sure that the stepping method is correct.
>
> humm too badly I don't have any hardware to reprogram the chip... I finished to make it work somehow... but compared to the maker base ones I have, they are 10x more noisy in closed loop and 2x more in open loop... and for some reason on closed loop mode, the movement never end (or maybe it ends, but I fear too much for my board to burn that I switch power off)... at the end of movement, the motor behave as if there was something blocking the movement... it make an awfull noise like an oscilation... as if a hammer was hurting a wall at high frequency... so I guess I will drop theses drivers, there is no schematics, noisy, poorly documented...

The programmer is quite cheap. You can get one [here] (https://www.amazon.com/Aideepen-ST-Link-Programming-Emulator-Downloader/dp/B01J7N3RE6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). They only cost $10 so I think it's worth it.

maracMB, 2021-04-02:
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

Omg! Yesss!

Well the multiple would need to be a variable (So that's couple of lines more...)... But one would set it via gcode like M93 F1.34

CAP1Sup, 2021-04-02:
@maracMB I can definitely do that, there's only one concern. The stepper coil calculations only work with whole micro stepping values. So I'm going to have to round it to the nearest step, which might cause minor inaccuracies. However, considering that the board should be able to achieve 1/32 microstepping, I estimate that the accuracy will be rounded to 0.05625 degrees. Probably not really something to worry about,  but it's something that's going to have to be kept in mind.

CAP1Sup, 2021-04-03:
@maracMB I spent all of my time today working on the encoder's SPI interface. I was, of course, unable to get it working so I didn't get to your idea. If you wouldn't mind posing your idea under the new idea discussion page on my repo, it would be greatly appreciated so we could keep everything in one place. Other than that, I will make your idea top priority for tomorrow morning's coding time.

CAP1Sup, 2021-04-03:
@maracMB all done! I only implemented the value over the serial and CAN bus. I left it out of the OLED menu just because I figured it wouldn't really be used that much from the panel. The only remaining issue is the motor's encoder, which I will be finishing up hopefully very soon.

maracMB, 2021-04-03:
@CAP1Sup yeah, OLED does not matter at all.
i will find you and buy you a beer. That's a promise. Thank you VERY much. Once i publish the build, you will be named.
I'll test it after the weekend probably

CAP1Sup, 2021-04-03:
@maracMB No problem, happy to help. It only took me a couple of minutes to implement. The only issue left is the encoder. I worked on it today, but I still can't seem to get any values out of it yet.

jlmxyz, 2021-04-06:
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

ok thanks, will give it a try!!! CAN bus can hopefully be a nice option in my case, I'm considering making a "intelligent" closed loop controler, with 2 end stop connectors, thermal sensor connector... and having communication done by CAN protocol instead of STEP/DIR control.... maybe the firmware rework can be a base for this project?

jlmxyz, 2021-04-13:
any news about the new firmware? I bought a programmer so I should be able to test it...
BR

CAP1Sup, 2021-04-13:
> any news about the new firmware? I bought a programmer so I should be able to test it...
>
> BR

@TazerReloaded and I have been working on implementing encoder readings. We where able to get the angle values from the motor (now nicely padded on the LCD) and speed is right around the corner (probably later today). Other than that, we have some minor values to fix and I need to redo how the coils are calculated because how I have it is wrong. After those are done, the board should be functional enough for use. More features are planned once we get it working on a basic level, so stay tuned for that. I'm thinking we can get the board working by the end of this week or the next.

jubjub64, 2021-04-30:
Can someone here point me in the right direction to wire up my s42b v2 to a st-link v2 so that I can either change the PID or upload a new firmware? And which program to use for the communication? BTT decided to leave any of that info out of their documents that I can find. Thanks for any and all help.

jlmxyz, 2021-05-10:
I've a question since you're working on the firmware, how is the communication DIR/STEP/EN handled? according to the doc, the timings have to be quite bigs, MKS closed loop model is by far faster, but have a huge issue on the CEM (the device control system is hugly, in fact it's able to burn small buffers or unprotected GPIO of CPU O_o) the bigtreetech S42B and nema57 version use optocouplers which is by far better (EL0631 if i'm correct, according to datasheet https://datasheet.lcsc.com/lcsc/1809291513_Everlight-Elec-EL0631-TA-V_C110806.pdf, Output rise time can be as low as 40ns, but with different values of resistor/capacitor) so how do you perform the "sampling" of pulses? if I correctly understood what BIGTREETECH programmed, they perform polling like sampling and not gpio interrupts based measurements... I really look forward your firmware... because BIGTREETECH one is just buggy and unusable... and MKS closed loop require to create an adaptation board... so my project is stuck

CAP1Sup, 2021-05-11:
@jlmxyz
The step pin is setup with an interrupt to handle the stepping. The stepping function checks the direction pin while calculating the stepper coils. The enable pin is checked every time the stepper correction updates (around 10-50x a sec, haven't decided on frequency yet). I didn't see a use for having to deal with an extra interrupt on either the enable or direction. I'm working on the final touches of the stepping algorithm and step correction now.

Thread 54 (2021-03-31):

what are the dip switches for????

jlmxyz, 2021-03-31:
I'm a bit puzzled...
on the doc https://github.com/bigtreetech/BIGTREETECH-S42B-V1.0/blob/master/42%20Stepper%20Motor%20Closed%20Loop%20Driver%20Control%20Board%20Manual.pdf, there is written that 2 firsts switches are for microstepping :
1 1 = 4
0 1 = 8
1 0 = 16
0 0 = 32

but on the screen we can select the microstepping....
so.... what is what for????? does the switches overdrive the selection in the menu? does the menu overdrive the selection of the swithes?  is the menu the settings for the controlBoard->ClosedLoopControler settings? or are the swtiches for controlBoard->ClosedLoopControler settings?  or is the menu for ClosedLoopControler->Motor? or are the switches for ClosedLoopControler->Motor????

I'm lost, the ClosedLoopControler calibrate, but nothing move... while it move with makerbase's servo57B (by the way I'm using S57B CLC, not sure this is the right place to ask, but there is no bigtreetech-S57B-V2.0 repository....)

thanks and regards

GhostlyCrowd, 2021-03-31:
the dip logic is inverted and BTT is too incompetent to update their source or manuals.  Dip 1 On is to Calibrate Dip 2 on is Closed loop Dips 3 and 4 are for micro stepping.

NZ-Nitro, 2021-03-31:
I think they provide dip switches for if you don't use the screen, also look at my post about accuracy

jlmxyz, 2021-04-01:
>
>
> the dip logic is inverted and BTT is too incompetent to update their source or manuals. Dip 1 On is to Calibrate Dip 2 on is Closed loop Dips 3 and 4 are for micro stepping.

what does it means "DIP 1 ON is to CALIBRATE"

1. DIP1 has to be ON for calibration, OFF for normal use?
2. DIP1 can be left ON for calibration AND normal use?
3. DIP1 had to be OFF to prevent recalibration, has no impact for normal use?

DIPS 3 and 4 apply on what micro stepping? motor microstepping? control micro stepping????
eg are MotorStep = LCDConfiguredMicroStep * CommandStepping / DipswitchMicroStepping?
or MotorStep = CommandStep * DipSwitchMicroStepping????

really thoses DIP switch just brings pain in the ASS.... why adding something that cost more and can be configured with the LCD???

Thread 57 (2021-07-20):

Will move only DIR High direction?

thejinn13, 2021-07-20:
Hey you all,
After the first success on connecting and running the calibration without any problem, I now cannot find the solution for adjusting the direction of the stepper. In short: it won't move backwards, a.k.a. the DIR = LOW wont move, but just stall.

The circumstances:

Arduino UNO sends commands to the S42B-V2.0 via digital Pins D2 (En), D3 (Dir), D4 (Step). Further the UNO provides 5V to the 5V COM of the S42B as also common for other drivers.
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

There is no load on the stepper. If rotating, it consumes about 200mA. I use the following sketch from  #https://github.com/bigtreetech/BIGTREETECH-S42B-V1.0/issues/13#issuecomment-704586812
[sketch_jul20a_BigTreeTechS42Btest.txt](https://github.com/bigtreetech/BIGTREETECH-S42B-V1.0/files/6851059/sketch_jul20a_BigTreeTechS42Btest.txt)
Note, that I sent quite slow pulstrains.

I changed various Dip-Positions on the S42B-V2.0. On my board: Dip No. 2 accounts for Closed/Open Loop. The problem persists in Open Loop mode.
I checked the stepper for a broken coil. However, both phases have 2.2Ohms.

To spice it up:
Adjusting Enable on the Stepper (OLED) to "!Enable" won't work, too. The motor will also only start on HIGH with "Enable" activated.

I dispared already, nothing would make me happier than some you capable people would find an obvious mistake.

best

thejinn13, 2021-07-26:
Dear who it may concern,

I figured the problem. Of course it turned out to be a novice error.

Please make sure, that you properly defined GND in the above sketched circuit. It is of major importance the GND Arduino and GND S42B have the same level.

My floating lab-supply of course did not share a GND with the Arduino. Therefore the level of the control Pins for STEP, DIR und EN were quite undefined. **Connecting a GND Pin of the Arduino with the negative pole of the lab-supply solved the problem.**

Interestingly, other drivers (TB6600) do not have this problem. It could be from separated rails or just a housing kept at neg. lab-supply.

Closed 2021-07-26.

Thread 59 (2021-11-21):

BIGTREETECH S42C

NZ-Nitro, 2021-11-21:
New model?

Anyone tried it?

andrew-cowell, 2021-12-05:
i have it.
installed on a voron 2.4 ON X Y.
when moving in just x axis or y axis they drift the toolhead out of place.
its like the motors loses torque when not used then eventually corrects it self as it has reached it destination.
also when you do Z lift and or Bed mesh.
the z is already moving down before they are on the destination they should be.
the manuals are crap there is no in depth  information.
the lcd menu lacks  options in my opinion.
screws should be 100mm long so they fit EVERY type of stepper motor
no install information but its kinda straight forward.
The only information to make these puppy's work is on marlin.
no clear documentation how to write to the uart port.
the alu heat and mounting block is then again A SUPER AWESOME feature.
just needs a top plate now .
2000rpm they say
can not get them to run fast in anyway at this moment.
Running them on klipper.
En these needs a auto brake on them to work there.

TheRevenantStar, 2021-12-30:
Can we get some docs on this model?

andrew-cowell, 2021-12-31:
on my voron its very cleary this servo pcb is under preforming.
even when current is high !
and you can not twist the pulley.
once you install them and they get a command.
they do drift the firmware is crap at this moment.
but am sure this can be fixed also they say they are uart capable!
PLEASE !!! better documentation For klipper and or any other firmware.
as is!!!
these are 100% unuseable unless!!!
YOU WANT TO PRINT SLOWER THEN you did before.

TheRevenantStar, 2021-12-31:
I haven't noticed any drift, or slow movements.
Mine is setup on the Ender 5+'s X-axis (I have yet to replace a defective one to setup the Y-axis) as of 2 hours ago.
The device performs exactly as advertised, once I figured out how to get the thing to calibrate.

In the end, speed and accuracy are typically inversely related. You can't expect high-speed printing and perfect accuracy, even from a CLS; though a CLS can help you approach perfection.

_On a personal note, and I hate to pull this card, maybe use more complete and understandable sentences. If anyone at BTT is using Google Translate, fragments and bad grammar make it harder to understand you._

andrew-cowell, 2021-12-31:
On a personal note, and I hate to pull this card, maybe use more complete and understandable sentences. If anyone at BTT is using Google Translate, fragments and bad grammar make it harder to understand you.

Zal ik het dan gewoon volledig in het Nederlands doen ??
Zodat niemand van jullie het verstaat :)
Sorry dit mijn leesblindheid u probleem is.
en het is niet omdat dat jij nu maar op 1 werkt!
dat het niet waar is wat ik zeg.
ik heb er wel degelijk 2 werkende.
En ze driften dus wel.
heb dit al bewezen met geposte video.
Dus als ik van u was zou ik u getrokken kaart maar terug steken.
Want u ganse woord salade.
is tegen strijdig met u claims.
en iemand bij btt reageren ???
ik ben al meer dan een maand nu bezig om een reactie te krijgen.
NIKS!!!
Dus wat als ze dit lezen met een vertaler.
And the grammar is not the problem :)

The-Distal, 2022-01-02:
https://github.com/bigtreetech/BIGTREETECH-Stepper-Motor-Driver/

You can find the S42C documentation here. I still can't get mine to work (fails calibration) and their support hasn't gotten back to me about issues... but at least you can see their code. The doc isn't great, but it's better than nothing.

mink007, 2022-06-15:
> I haven't noticed any drift, or slow movements. Mine is setup on the Ender 5+'s X-axis (I have yet to replace a defective one to setup the Y-axis) as of 2 hours ago. The device performs exactly as advertised, once I figured out how to get the thing to calibrate.

Any tips and tricks on how to calibrate ? Other than just plugging in the wires and following the instructions on the OLED?

reynhardtstef, 2022-08-01:
Does the firmware for the S42c even exist publically? I have also reached out to their support team but no one has contacted me yet.

Thread 60 (2022-06-09):

S42C V1.0 Github library?

mink007, 2022-06-09:
I understand i am writing under S42B V1.0 repository but this question is related to S42C-V1.0 version which is recently released

https://www.biqu.equipment/collections/driver-board/products/bigtreetech-s42c-v1-0-42-stepper-motor-closed-loop-driver-board-with-oled-display

I do not see the github library for S2C V1.0. Will you be publishing the documentation and relevant code/software for S2C V1.0 ?

The boards i ordered are still in shipping transit. I am looking forward to it. It appears it can support 24Volt input which is great.

Thank you.

mink007, 2022-06-09:
Found the library at for S42C V1.0

https://github.com/bigtreetech/BIGTREETECH-Stepper-Motor-Driver

Closing the issue.

Closed 2022-06-09.

Thread 61 (2023-01-11):

UART communication to set PID values with BTT Writer

CKCMorgoth, 2023-01-11:
Hello there
I added 2 S42C steppers to my printer and now I have the problem that my prints result in heavy ghosting, so I checked multiple posts in here and decided to try to set the PID values until the firmware for the S42C become opensource.
Since I dont have an arduino available right now, I decided to try the BTT writer I got for my Wifi modules, since it is basically a CH340G USB to Serial converter.
I set the level jumper to 3.3V, connected GND to GND, 3.3V to 3.3V, Receive from the CH340 went to PA2 and transmit of the CH340 went to PA3 which are the UART pins for the STM32G, and plugged it into my USB port.
Nothing went on fire and the display of the stepper display the normal menu, so I was happy for that :)
Now I wanted to read the current PID values, first attempt was putty, set it to the right COM port, baud rate set to 9600 (checked that on the OLED) and connected, which worked, but didnt give me any output.
Next try was the serial monitor of the arduino IDE, but this kept blank too.
Last try was to try realterm, which also seemd to connect to the interface, but still no output, and also realterm showed me no status info for the connection, everything stayed grey.
So in my opinion, either I misjudged the BTT writer of being capable of communicating by UART and I will need to get an Arduino, or I misswired something, or I didnt get into using UART right.

Can anyone tell me where to start to get this setup running?
Thanks in advance and greeting
Morgy

CKCMorgoth, 2023-01-17:
Okay with the help of some work colleagues I got it figured out, telling you how I did it so you dont need to wildly guess like me ^^

Connect the BTT writer with the S42C like mentioned above
Download HTerm
Connect the COM port
send binary 10101000 10000110 to read the PID values (change answer to ascii to get clear text)
write I value with 10101010 00000111 0000000 00000000 for I = 0 or 10101010 00000111 00000000 11111111 for I = 255
write D value with 10101010 00001001 00000000 00000000 for D = 0
and save with 10101010 00011000 00000000 00000000
You will receive a "S42C_V1.0" message

Congratulations, you successfully overwritten the (P)ID values of your S42C motor
